INO-quantum/FPGA-SoC-experiment-control/documentation/readme.md

# documentation

## manual

This folder contains the user manual of the FPGA board. 

This contains additional information about the board and how to configure and program it.
