INO-quantum/FPGA-SoC-experiment-control/labscript-suite/readme.md

# labscript FPGA-SoC device

Python code to implement FPGA-SoC board with labscript-suite

## The FPGA-SoC board

The FPGA-SoC (system-on-a-chip) board is used as a low-cost experimental control hardware for controlling cold and ultracold atoms experiments. It is designed to work together with existing hardware placed in a 19" rack and replaces the outdated DIO64 board from Viewpoint Systems. In each sub-rack several plug-in modules can be inserted, like digital or analog outputs which are programmed via a ribbon "bus" cable on the backplane of the sub-rack. A custom [buffer card](/FPGA-buffer-card) was designed to buffer and level-shift the signal from the FPGA-SoC board voltage lever (3.3V) to that of the rack (5V). It additionally hosts clock input and output buffers for an external clock reference and buffers for external I/O which allows to synchronize several boards and as start/stop trigger. The FPGA-SoC board is connected with Arduino style headers to the buffer card and they are together inserted into one slot of the sub-rack and drive the backplane bus. The idea was that the new buffer card replaces the old opto-coupler card which is now not needed anymore. The FPGA-SoC board is the commercial low-cost board Cora-Z7 from Digilent. It has a FPGA-SoC chip from Xilinx (Zynq-7007S) consisting of a FPGA part and a CPU. The board hosts Gigabit Ethernet, USB (device and host) ports and plenty of external pins in an extended Arduino style layout. On the CPU part a simple embedded Linux operating system (Petalinux 2020 with linux kernel 5.4) is running which faciliates proptyping and tests where one can execute custom application generated for example with C/C++ or Python. The second section of the chip is the FPGA (field-programmable gate array) part which contains the custom hardware design (programmed in Verilog) which generates the signals which communicate with the hardware devices in the sub-rack via the backplane bus. 

Each FPGA-SoC board can drive up to two sub-racks when they are not too far apart (few meter). For larger separations two FPGA-SoC boards are recommended.

The channels (plug-in modules into sub-racks) are distinguished with a 7-bit address which must be unique for each sub-rack. The device-dependent data word is 16-bits long which allows to address 16 digital channels or to set the voltage of one 16-bit DAC. The FPGA-SoC puts the address and data word on the bus at the programmed time and after about 300ns (for 1MHz bus update rate; this can be configured) another bit on the bus (called 'strobe') goes high and after about 300ns goes low. The rising edge of the strobe triggers the addressed channel to update its output according to the programmed data word. The delay (usually referred as "setup time") ensures that all data and address bits are settled. Since the strobe signal acts like a clock but is changing state only when needed (different to a real clock), it is called 'pseudoclock' by labscript.

## Implementation as a labscript-suite device

The present software implements the FPGA-SoC board as a labscript device. Labscript-suite (https://docs.labscriptsuite.org/) is a free software package written in Python which allows to control ion, cold- or ultracold atoms experiments. It consists of 'runmanager' which generates the experimental sequence data, 'runviewer' which allows to visualize the data like oscilloscope traces and 'BLACS' which interacts with the hardware. The additional program 'Lyse' allows to gather data (like images) and analyze it. The experimental sequence, i.e. the list of actions as a function of time, is saved as Python script file [see example FPGA_test.py](/labscript-suite/userlib/labscriptlib/FPGA_test/FPGA_test.py) which the user edits. A separate file [connection_table.py](/labscript-suite/userlib/labscriptlib/FPGA_test/connection_table.py) is used to declare the hardware and needs to be imported into each experiment script.

The FPGA-SoC board is implemented in [FPGA_device.py](/labscript-suite/userlib/user_devices/FPGA_device.py) as a "pseudoclock device" (FPGA_board). The plugin-modules (having several channels) are implemented as "intermediate device" (DigitalChannels and AnalogChannels) and the individual channels are standard labscript digital and analog outputs (DigitalOut and AnalogOut).

Each FPGA board can drive up to 2 sub-racks where the second sub-rack shares the same address and data space but individual pseudoclock ('strobe') signals are generated such that only one or the other or both sub-racks are addressed. The timing of the two pseudoclocks can be adjusted individually allowing also to compensate for run-time delays on the different cable lengths.

Several FPGA boards can be declared in the connection table. One of the board must be defined as the primary board (in labscript termed as "master pseudoclock") for which the "trigger_device" entry must be None and for all other boards, called secondary boards, "trigger_device" is set to the name of the primary board. In order to synchronize the boards in time the primary board provides its internal clock on the "clock out" port which needs to be connected with a coaxial cable (and maybe splitter) to the "clock in" of the secondary boards. Alternatively, a shared external clock can be be used instead for all boards. Additionally, the primary board provides a "trigger" (also called "sync out") signal at the start of the experiment which needs to be input to the secondary boards. All output and input signals can be configured by software, either in the connection table, the experimental script or in the BLACS GUI. For examples see [connection_table.py and FPGA_test.py files](/labscript-suite/userlib/labscriptlib/FPGA_test/).

## Steps to get started

1. install labscript-suite on your computer as described here: https://docs.labscriptsuite.org/en/stable/installation/
2. you have to edit the file /labscript-suite/labconfig/\<your computer name\>.ini: give for "apparatus_name" the name of your experiment. This defines in which folder in /labscript-suite/userlib/labscriptlib/ your connection table and experiment script are located. I usually set save_hg_info = False since I have not hg (Mercurial) installed.
3. copy into the folder /labscript-suite/userlib/user_devices: FPGA_device.py, register_classes.py and generic_conversion.py
4. copy into the folder /labscript-suite/userlib/labscriptlib/\<apparatus name\>: conncetion_table.py and FPGA_test.py
5. edit 'FPGA_test.py' and connection_table.py for your actual experimental setup. For example you want to give proper names to each of the channels.
6. to start runmanager and blacs on Windows you will most likely find some desctop shortcuts, on linux it depends how you installed: most likely you launch them from the terminal after activation of a virtual environment. I use instead Pycharm-community.
7. after you started BLACS it will ask you to compile the connection table. Just press the compile button and after the small window appeared and it hopefully successfully compiled click on restart BLACS. BLACS restarts but unfortunately, it will always give error messages ("Broken Pipe" on Ubuntu, something else on Windows) and you have to manually close all of the popup error windows and BLACS and restart it. After manual restart the errors are gone. I have not understood where these errors are coming from but I assume its a bug in labscript. 
8. now yo can lanuch runmanager (sometimes you have to restart it after BLACS recompile and restart error) and click on "Engage" to compile your experiment script. When you have enabled "Run shot(s)" the sucessful created hd5-file with the data is inserted into the "Filepath" table of experiments in BLACS.
9. in BLACS click on the "Pause" button when it is gray and the experiment should be executed. When you enable the "Repeat" button then all files in the table are executed in a loop until you push the "Repeat" button again. To get an idea of the execution of the boards click on the black square in the top-right corner of the board tab. This opens the terminal showing messages from the blacs worker talking with the board (and maybe with the other boards). This is helpful if something goes wrong. The Digital and Analog outputs buttons open the sections where you can set outputs manually. In the "FPGA board" section you can see the current setup of the board and you can temporarily do changes after you enabled "allow changes (caution!)" - this is for testing. The "get state" button prints the actual board state in the terminal window. The disconnect button disconnects the board. The "abort!" button I think does not do anything at the moment.

## notes regarding the 'pseudoclock' and other details

The concept of the 'pseudoclock' has caused some confusion. As stated above, it is a phycical (digital) signal which acts like a clock but changes state only when needed, i.e. only when some device on the sub-rack has to read data from the bus and change state. This has two advantages: 1. for each channel only the state changes need to be memorized and uploaded without corresponding timing information, and 2. channels provided with independent pseudoclocks can run independently.

Most labscript devices are either a pseudoclock device (like the Pulseblaster) or a so-called intermediate device (like the National Instruments cards) which uses an external pseudoclock device for timing. A pseudoclock device needs to process only timing data, while the intermediate device needs to process only channel data. A physical pseudoclock device can provide several pseudoclocks to clock devices at different rates. Some of them have also a limited number of digital channels (called "direct outputs") for arbitrary use. 

The present implementation features both aspects, where the "FPGA_board" is the pseudoclock device handling the timing, and the two intermediate devices ("DigitalChannels" and "AnalogChannels") are handling the channel data. However, time and channel data is **not separated** here and is uploaded on each FPGA board within a single data structure. This is the data expected by the Viewpoint Systems DIO card which the present FPGA board is intended to replace.

The uploaded data consists of 32bit time information (in units of 1/bus_rate which is typically one microsecond) plus 32bit data where 7bits is the channel address and 16bits is the channel data. For the 2 sub-racks version a second 32-bit data with the same structure is added. From the remaining 9 bits in the data the bit (BIT_STRB) next to the address bits was historically toggled for each sample which created in the old opto-coupler card the delayed 'strobe' pulse. This was a cheap way to generate a 300ns delayed pulse without the need of a separate clock signal. Additionally, it allowed to skip one sample without changing the buffer size by not toggling this bit (but the bit needed to be toggled in all following data samples). The present FPGA board ignors BIT_STRB (although generated by runmanager) since it can generate the strobe independently with a much better resolution (and much less jitter) than the old opto-coupler card. However, if needed, BIT_STRB can be enabled to skip samples when this bit does not toggle. This way it might be easier to migrate from old software in case it uses this feature. Ask me or check with an oscilloscope that this feature works, since it might need to be enabled also in the firmware (note that with the old DIO card, because of the BIT_STRB, it might skip the first sample when the last executed sequence has an odd number of samples). Another - more useful bit - is bit 31 (BIT_NOP) of the data. If BIT_NOP is set (1) then the sample is ignored by the FPGA board but the timing is not affected. This allows, as BIT_STRB to skip data but only one sample needs to be changed in memory. This bit cannot be disabled since it is also used by the driver (on the FPGA board) to add additional samples to have always a multiple of 4 samples in the data (this comes from the 8 or 12bytes per sample and allows to have a fixed internal bus size on the FPGA logic of 16bytes since 4x8=2x16 and 4x12=3x16 give integer multiple of 16). Last special bit which can be enabled is bit 30 (BIT_IRQ) which when set causes the FPGA board to generate an internal IRQ which triggers to update the number of sample and execution time registers and sends an updated time information to the control software. This is useful to software trigger some external devices, for example a device using USB or GPIB, and avoids that the software has to poll for a certain execution time to send commands to the device. Tests showed that the jitter caused when using this feature is significantly reduced. Please ask me for details how to do this when needed.
