INO-quantum/FPGA-SoC-experiment-control/firmware-source/2017.4/Vivado/Screenshot from 2021-05-19 11-35-13.png

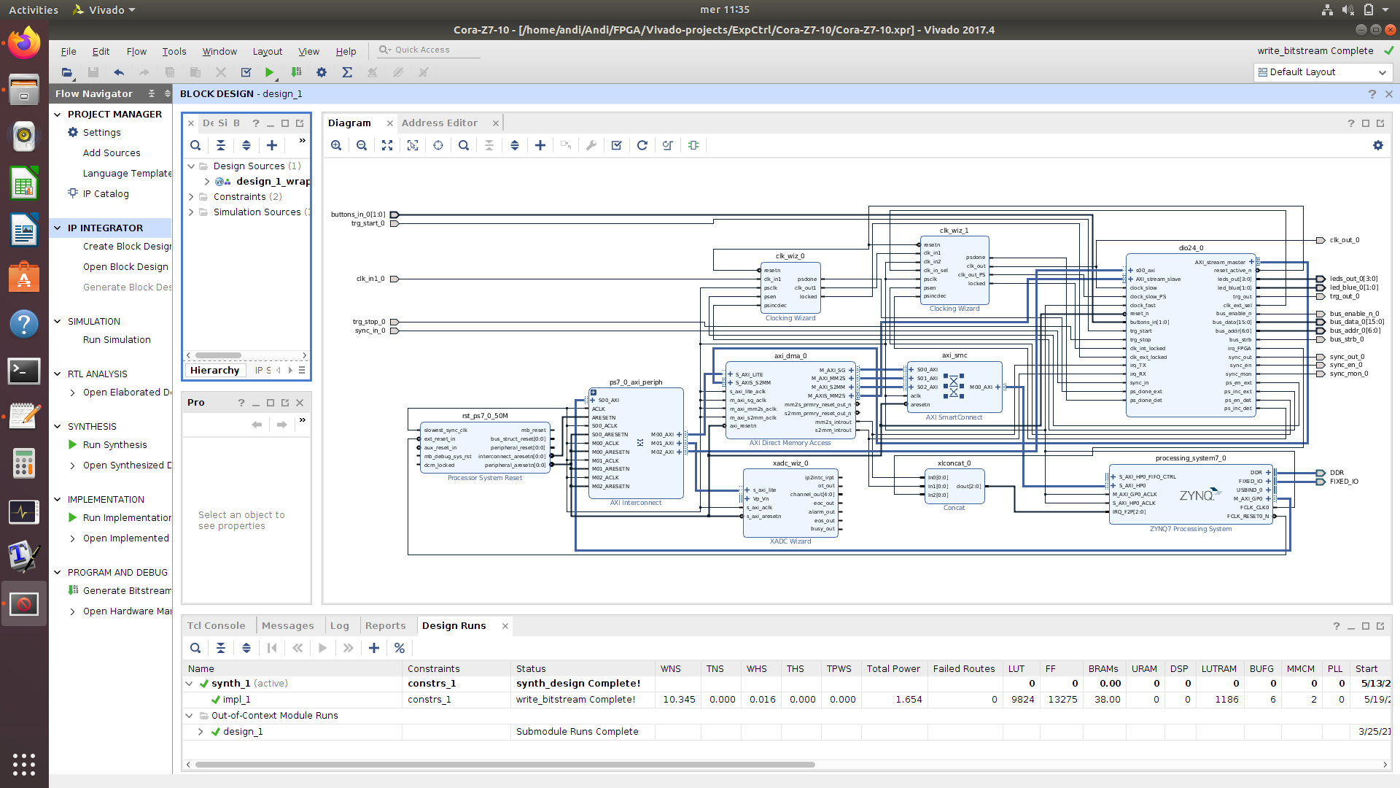
firmware-source/2017.4/Vivado/Screenshot from 2021-05-19 11-35-13.png
