INO-quantum/FPGA-SoC-experiment-control/buffer-card/v1.4/production/FPGA_buffer_board_v1.4_shopping_list.xls

FPGA and buffer board v1.4, 2024/01/16 by Andi
list contains items needed for 1 FPGA board + 1 buffer board
not all items are/were available on RS. I found the rest at mouser
*these items depend on the chosen configuration. you can leave them open and insert later manually when needed.
price is without VAT
position | qty/board | Value | description | RS/mouser code | price/item | items/pgk | pkg to buy | RS list | price/RS | price/total | note
C1 | 1 | 100uF | Condensatore Panasonic, serie HD RADIAL, 100μF, 16V cc, ±20%, +105°C, Radiale, Foro passante | 744-1990 | 0.118 | 10 | 1 | ok | 1.18 | 1.18
C2 | 1 | 10uF Tantalum | AVX TAJ 10μF ±20%, 16V cc, +125°C, package 1206 (3216M) | 136-0190 | 0.222 | 50 | 1 | ok | 11.1 | 11.1
C3 - C13, C16, C17 | 13 | 100nF | Condensatore ceramico multistrato MLCC, 0603 (1608M), 100nF, 50V cc, SMD | 135-8352 | 0.08 | 50 | 1 | ok | 4 | 4
C14, C15 | 2* | 10nF/short* | Condensatore ceramico multistrato MLCC, 0603 (1608M), 10nF, ±10%, 50V cc, SMD, X7R | 242-3912 | 0.01 | 100 | 0 | * | 0 | 0 | *10nF/short for ext.clock 10MHz since/LVPECL
D1 | 1 |  | Indicatore LED per PCB Rosso Dialight, 45 °, 1 LEDs, Right-angle, 2 V, Montaggio con foro passante | 546-0463 | 1.1 | 1 | 1 | ok | 1.1 | 1.1
D2, D3 | 2 |  | Indicatore LED per PCB Verde Dialight, 45°, 1 LEDs, Right-angle, Montaggio con foro passante | 917-0767 | 0.785 | 20 | 1 | ok | 15.7 | 15.7
J1 | 1 | Cora supply jack 2.1mm | Morsettiera per circuito stampato RS PRO Maschio a 2 vie, 1 fila, passo 5mm, Montaggio su foro passante | 897-0843 | 0.537 | 10 | 1 | ok | 5.37 | 5.37
J2 | 1 | +/-15V, 5V from rack | Connettore circuito stampato Molex Filo-Scheda, 5 vie, 1 fila, passo 3.96mm | 679-5697 | 0.462 | 10 | 1 | ok | 4.62 | 4.62 | maybe by mistake of RS we recieved a shorter version last time. this should be Molex type 41791, mat. nr. 26-60-4050 with total pin length 18.29mm (mating length 11.43mm)
J3, J5, J6 | 2 | 1x8 (1x 1x2, 1x 1x8, 1x 1x4) | HMTSW-108-22-G-S-400, Board to Board & Mezzanine Connectors .100" High-Temp Variable Post Height Terminal Strip | 200-HMTSW10822GS400 | 1.47 | 1 | 2 |  |  | 2.94 | mouser
J4, J8 | 2 | IO0-41 (2x 2x8) | HMTSW-108-22-S-D-400, Board to Board & Mezzanine Connectors .100" High-Temp Variable Post Height Terminal Strip | 200-HMTSW10822SD400 | 3.35 | 1 | 2 |  |  | 6.7 | mouser
J7 | 1* | SPI* (2x3) | Presa PCB Samtec, 6 vie, 2 file, passo 2.54mm, Foro passante | 155-7781 | 1.96 | 10 | 0 | * | 0 | 0 | *open
J9 | 1 | A0-A11 (2x6) | HMTSW-106-22-L-D-400, Board to Board & Mezzanine Connectors .100" High-Temp Variable Post Height Terminal Strip | 200-HMTSW10622LD400 | 1.82 | 1 | 1 |  |  | 1.82 | mouser
J10, J11 | 2 | Cora PMOD JA/B (2x6) | Presa PCB Samtec, 12 vie, 2 file, passo 2.54mm, Montaggio superficiale | 198-1520 | 4.19 | 1 | 2 | ok | 8.38 | 8.38
J12 | 1* | I2C* (1x3) | Connettore maschio Samtec, 3 vie, 1 fila, passo 2.54mm | 180-3419 | 0.263 | 50 | 0 | * | 0 | 0 | *open
J13, J21 | 2 | daugther I/O, bus out (2x25) | TSM-125-01-L-DV, Headers & Wire Housings .100" Surface Mount Terminal Strip | 200-TSM12501LDV | 6.87 | 1 | 2 |  |  | 13.74 | mouser
J14 | 1 | rack backplane connector (2x32) | Connettore DIN 41612 Harting 09031647921 64 vie Maschio, 2 file, passo 2.54mm, tipo C, classe C3 Foro passante, Saldare | 406-357 | 3.04 | 1 | 1 | ok | 3.04 | 3.04
J15, J18, J22, J23 | 4 | clock in/out, in/out_0 (SMA) | Connettore coassiale Diritto RS PRO, Femmina, 50Ω, Montaggio su bordo, 1.6mm spessore | 526-5785 | 3.73 | 1 | 4 | ok | 14.92 | 14.92 | alternative SMB: 526-5814
J16-17, J19-20, J24 | 5* | in_1/2, out_1/2, clock_LVDS_1/2* | Connettore coassiale Ad angolo retto RS PRO, Maschio, 50Ω, Circuito stampato | 253-7046 | 2.3 | 1 | 1 | ok | 2.3 | 2.3 | *optional, J24 recommended for clock (1 selected)
R1, R2, R3 | 3 | 510 | Resistenza SMD Vishay Film spesso, 510Ω, 0805 (2012M), ±1%, 0.125W, serie CRCW | 679-1519 | 0.06 | 50 | 1 | ok | 3 | 3
R4, R5, R6, R29 | 4 | 100 | Resistenza SMD Panasonic Film spesso, 100Ω, 0805 (2012M), ±1%, 0.125W, serie ERJ | 865-4191 | 0.053 | 100 | 1 | ok | 5.3 | 5.3
R7, R8, R9 | 0* | open* |  |  |  |  | 0 | * | 0 | 0 | *open
R10, R11, R12 | 3 | 2.2k | Resistenza SMD Yageo Film spesso, 2.2kΩ, 0805 (2012M), ±5%, 0.25 W, 0.125 W | 199-5764 | 0.01 | 100 | 1 | ok | 1 | 1
R13-R20 | 8* | 220* | Resistenza SMD Vishay Film spesso, 220Ω, 0805 (2012M), ±1%, 0.5W | 812-3482 | 0.012 | 25 | 0 | * | 0 | 0 | *open
R21-R28 | 8 | 220k | Resistore per montaggio superficiale a film spesso TE Connectivity 220kΩ ±1%, 0.125W, 0805, serie CRG | 223-0742 | 0.034 | 50 | 1 | ok | 1.7 | 1.7
R30, R31, R36-R39 | 6 | 0 | Resistenza SMD Vishay Film spesso, 0Ω, 1206 (3216M), ±0%, 0.5W, serie CRCW | 812-1773 | 0.158 | 25 | 1 | ok | 3.95 | 3.95
R32, R34 | 2* | open/120* | Resistenza SMD TE Connectivity Film spesso, 120Ω, 1206 (3216M), ±5%, 0.5W, 200V, serie CRGH | 807-1114 | 0.02 | 100 | 0 | * | 0 | 0 | *open/120 for ext.clock 10MHz sine/LVPECL
R33 | 1* | short/82* | Resistenza SMD TE Connectivity Film spesso, 82Ω, 1206 (3216M), ±5%, 0.5W, 200V, serie CRGH | 807-1306 | 0.012 | 100 | 0 | * | 0 | 0 | *short/82 for ext.clock 10MHz sine/LVPECL
R35 | 1* | 51/82* | Resistenza SMD Vishay Film spesso, 51Ω, 1206 (3216M), ±1%, 0.5W, serie CRCW | 812-1916 | 0.3 | 25 | 0 | * | 0 | 0 | *51/82 for ext.clock 10MHz sine/LVPECL
R40, R41 | 2 | 110 | Resistenza SMD TE Connectivity Film sottile, 110Ω, 0805 (2012M), ±0.1%, 0.1W | 666-2446 | 0.094 | 5 | 1 | ok | 0.47 | 0.47
U1-U4, U7-U10 | 8 | 74HCT541 | Driver e buffer di linea 74HCT541D,652, HCT, 3 stati, Non-invertente, SOIC, 20-Pin | 103-8183 | 0.633 | 38 | 0 | * | 0 | 0
 |  |  | 74HCT541D,653, Buffer e line driver OCTAL BUF/DRIVER 3-S | 771-74HCT541D-T | 0.586 | 1 | 8 |  |  | 4.688 | alternative on mouser
U5 | 1 | 74LVC06 | Invertitore HEX INV Open Drain 1.65V to 5.5V 24mA | 621-74LVC06AT14-13 | 0.353 | 1 | 1 | ok | 0.353 | 0.353
U6 | 1 | 74LVC3G17 | Buffer SN74LVC3G17DCTR, Triple canali, LVC, 1,65 → 5,5 V, SSOP, 8 Pin Sì | 662-9045 | 0.74 | 5 | 0 | * | 0 | 0 | package TSSOP-8 3x3mm is ok
 |  |  | 771-LVC3G17DP125, Buffer e line driver TRIP NO-INV SCH TRIG, TSSOP-8 | 771-LVC3G17DP125 | 0.567 | 1 | 1 |  |  | 0.567 | alternative on mouser
U11 | 1 | MC10EPT20 | Traslazione - Livelli di tensione 3.3V TTL/CMOS to Diff PECL, SOIC-8 | 863-MC10EPT20DG | 9.47 | 1 | 1 | ok | 9.47 | 9.47 | alternative 908-0951 (TSSOP, dual footprint)
U12 | 1 | LTC6957xDD-3 | Buffer di clock Low Phase Noise, Dual Output Buffer/Driver/Logic Converter with LVDS Outputs | LTC6957HMS-2#PBF | 10.2 | 1 | 1 |  |  | 10.2 | mouser, alternative: 584-LTC6957HMS-3#PBF or 584-LTC6957HMS-4#PBF
additional:
 | 1 |  | Kit di sviluppo 410-370 per ARM Development, FPGA Development | 184-0456 | 151.96 | 1 | 1 | ok | 151.96 | 151.96
 |  |  | Strumenti di sviluppo CI logici programmabili Cora Z7-07S Product Kit | 424-410-370 | 144.12 | 1 | 0 |  |  | 0
 | 1 |  | Micro SD Transcend Class 10, UHS-1 U1 MicroSDHC | 124-9639 | 13.99 | 1 | 1 | ok | 13.99 | 13.99 | use high-quality SD cards! 2 from Verbatim broke very fast!
 | 1 | 2x30, 90 degree, long pins, Cora PMOD JA clock interconnection | HMTSW-130-09-G-D-240-RA, Board to Board & Mezzanine Connectors .100" High-Temp Variable Post Height Terminal Strip | 200-HMTSW13009GD240R | 9.64 | 1 | 1 |  |  | 9.64 | found only on Mouser; this is for clock connection which could be made also just by cutting 0.7mm thick wire.
 | 1 |  | Cavo di alimentazione, L. 1.8m, Cavo spina da 2,5 mm Senza terminazione, 12 V, 1 A | 656-3894 | 7.42 | 1 | 1 | ok | 7.42 | 7.42
 | 4 |  | Connettore coassiale Angolo destro Telegartner, Maschio, 50Ω, Montaggio su cavo | 193-8990 | 4.68 | 1 | 4 | ok | 18.72 | 18.72 | SMA connector for external clock and trigger. maybe you need a coaxial cable for this as well?
sum | 80 |  |  |  |  |  |  |  | 289.043 | 339.338
