INO-quantum/FPGA-SoC-experiment-control/buffer-card/v1.4/production/FPGA_buffer_board_v1.4_FPGA_board_only_with_accessoires.xls

FPGA board v1.4, 2025/03/05 by Andi
list contains items needed for 1 FPGA board
price is without VAT
position | qty/board | Value | description | RS code | Mouser code | price/item | items/pgk | pkg to buy | RS list | price/RS | price/total | note
0 | 1 |  | Kit di sviluppo 410-370 per ARM Development, FPGA Development | 184-0456 | - | 151.96 | 1 | 1 | ok | 151.96 | 151.96
1 | 1 |  | Micro SD Transcend Class 10, UHS-1 U1 MicroSDHC | 124-9639 | - | 14.41 | 1 | 1 | ok | 14.41 | 14.41 | use high-quality SD cards! 2 from Verbatim broke very fast!
2 | 1 |  | Cavo di alimentazione, L. 1.8m, Cavo spina da 2,5 mm Senza terminazione, 12 V, 1 A | 656-3894 | - | 8.03 | 1 | 1 | ok | 8.03 | 8.03
