INO-quantum/FPGA-SoC-experiment-control/firmware-source/2020.1/labscript/labscriptlib/NI_DAQmx_test/c1f0nXgzot6vj0mP.png

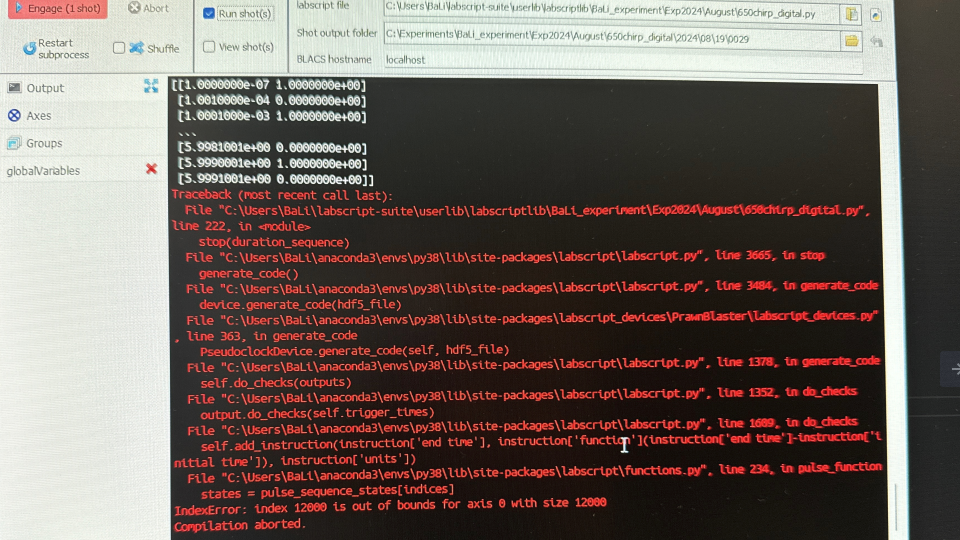
firmware-source/2020.1/labscript/labscriptlib/NI_DAQmx_test/c1f0nXgzot6vj0mP.png
