INO-quantum/FPGA-SoC-experiment-control/buffer-card/v1.4/FPGA_buffer_board_v1.4_schematics_color.pdf

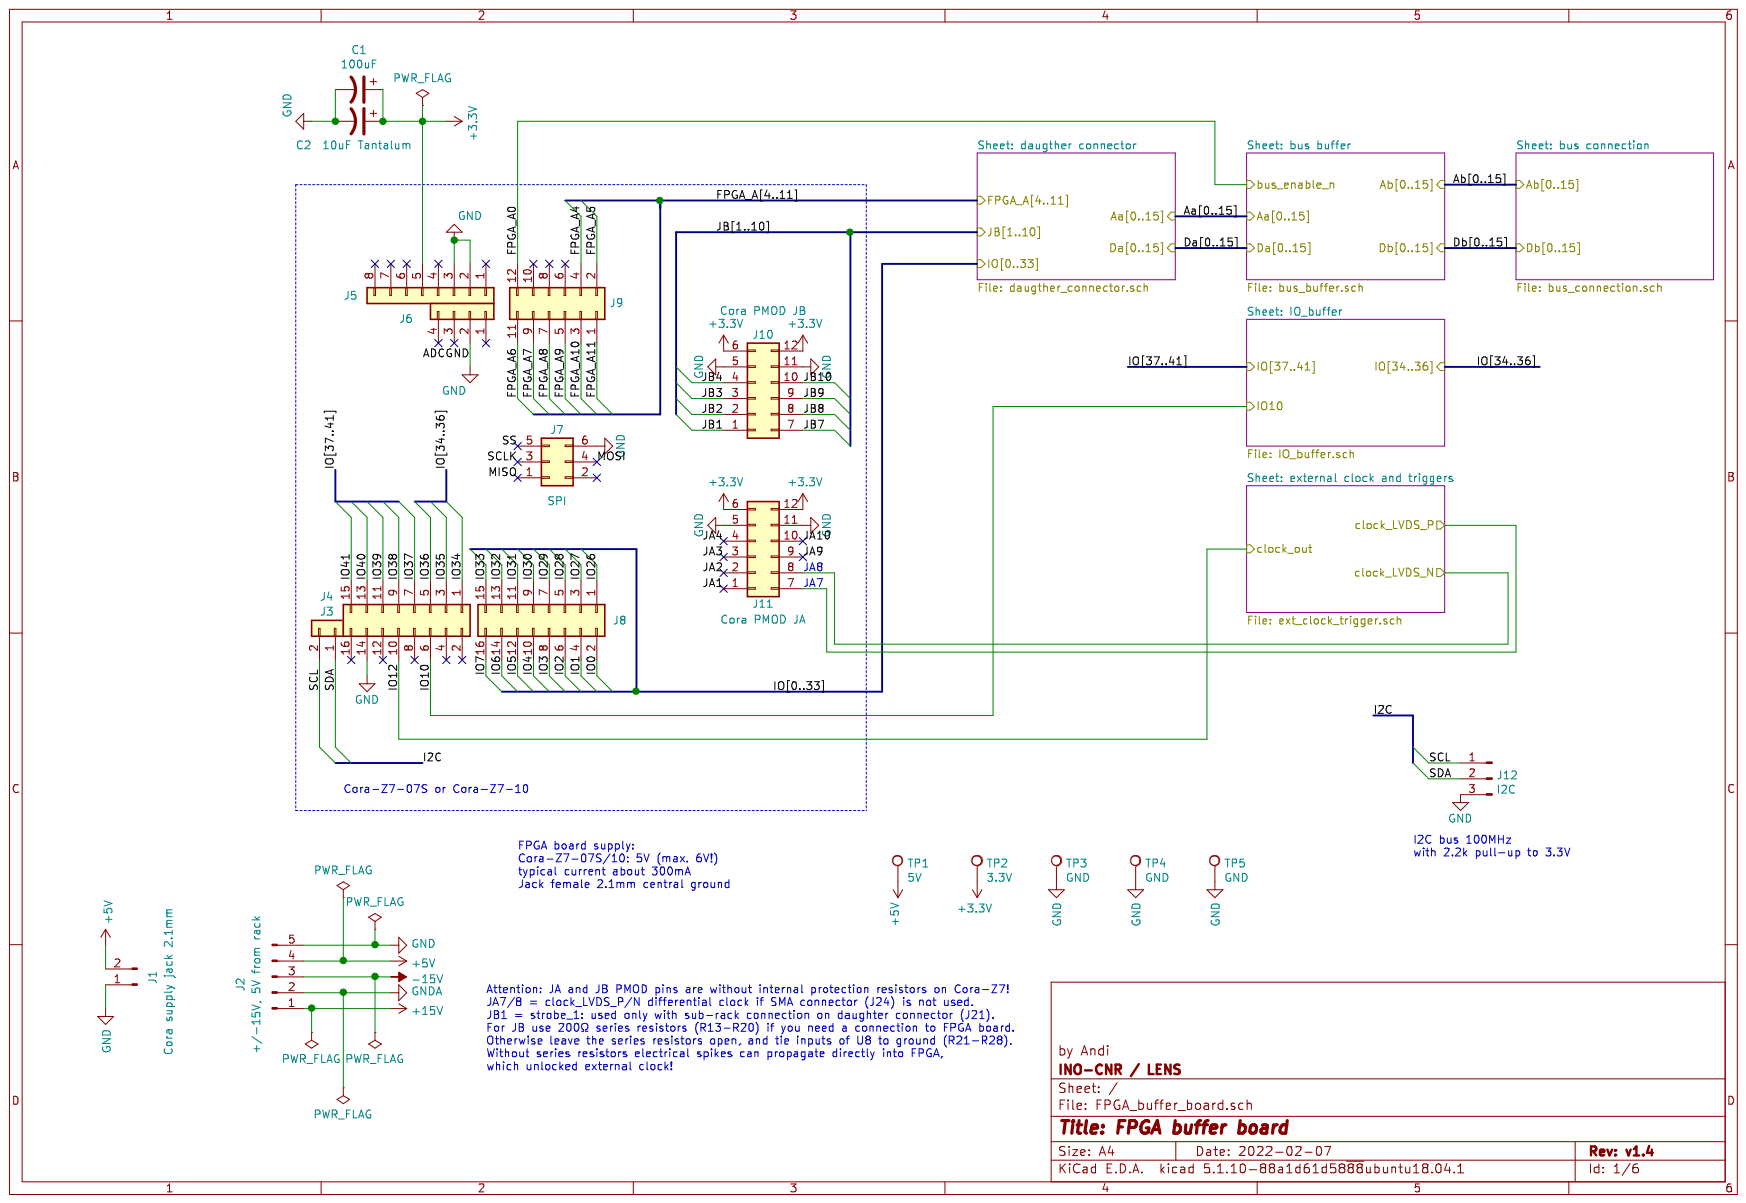
[picture p11: page 1]

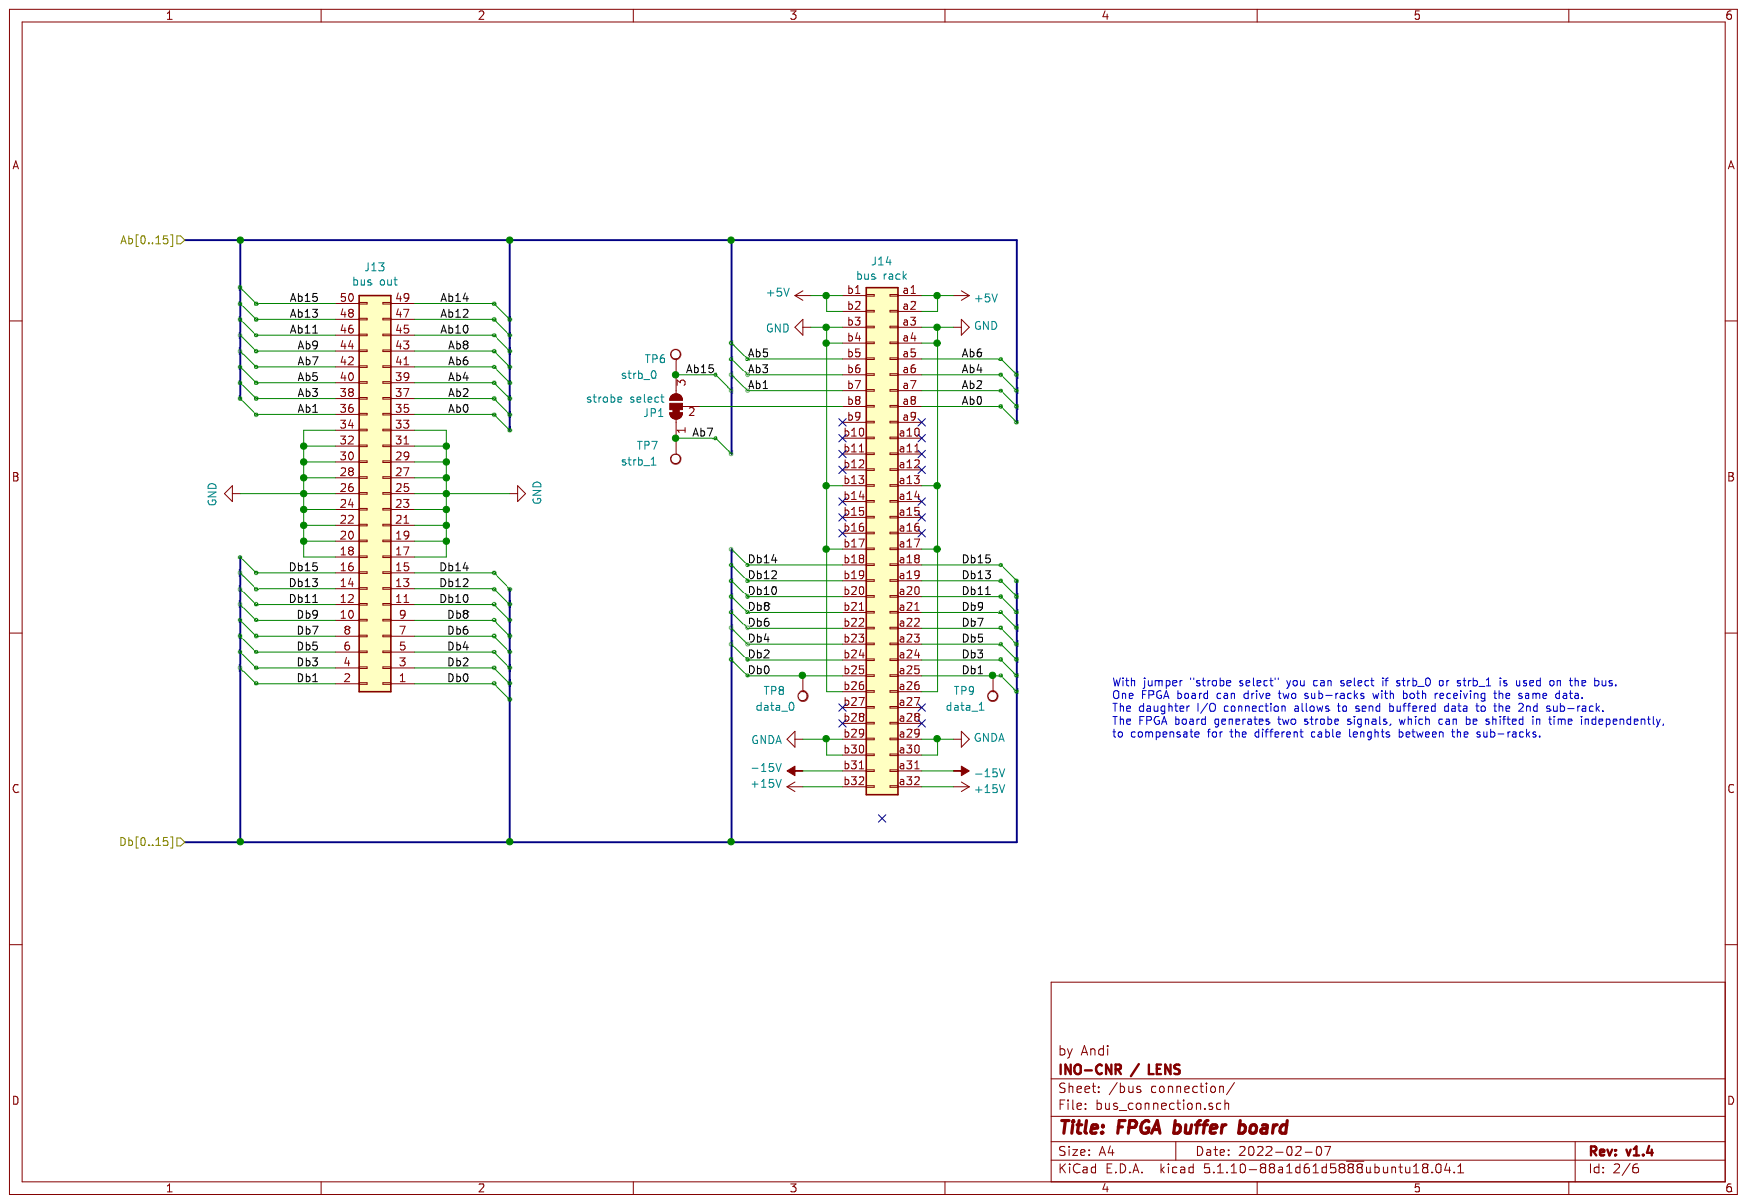
[picture p12: page 2]

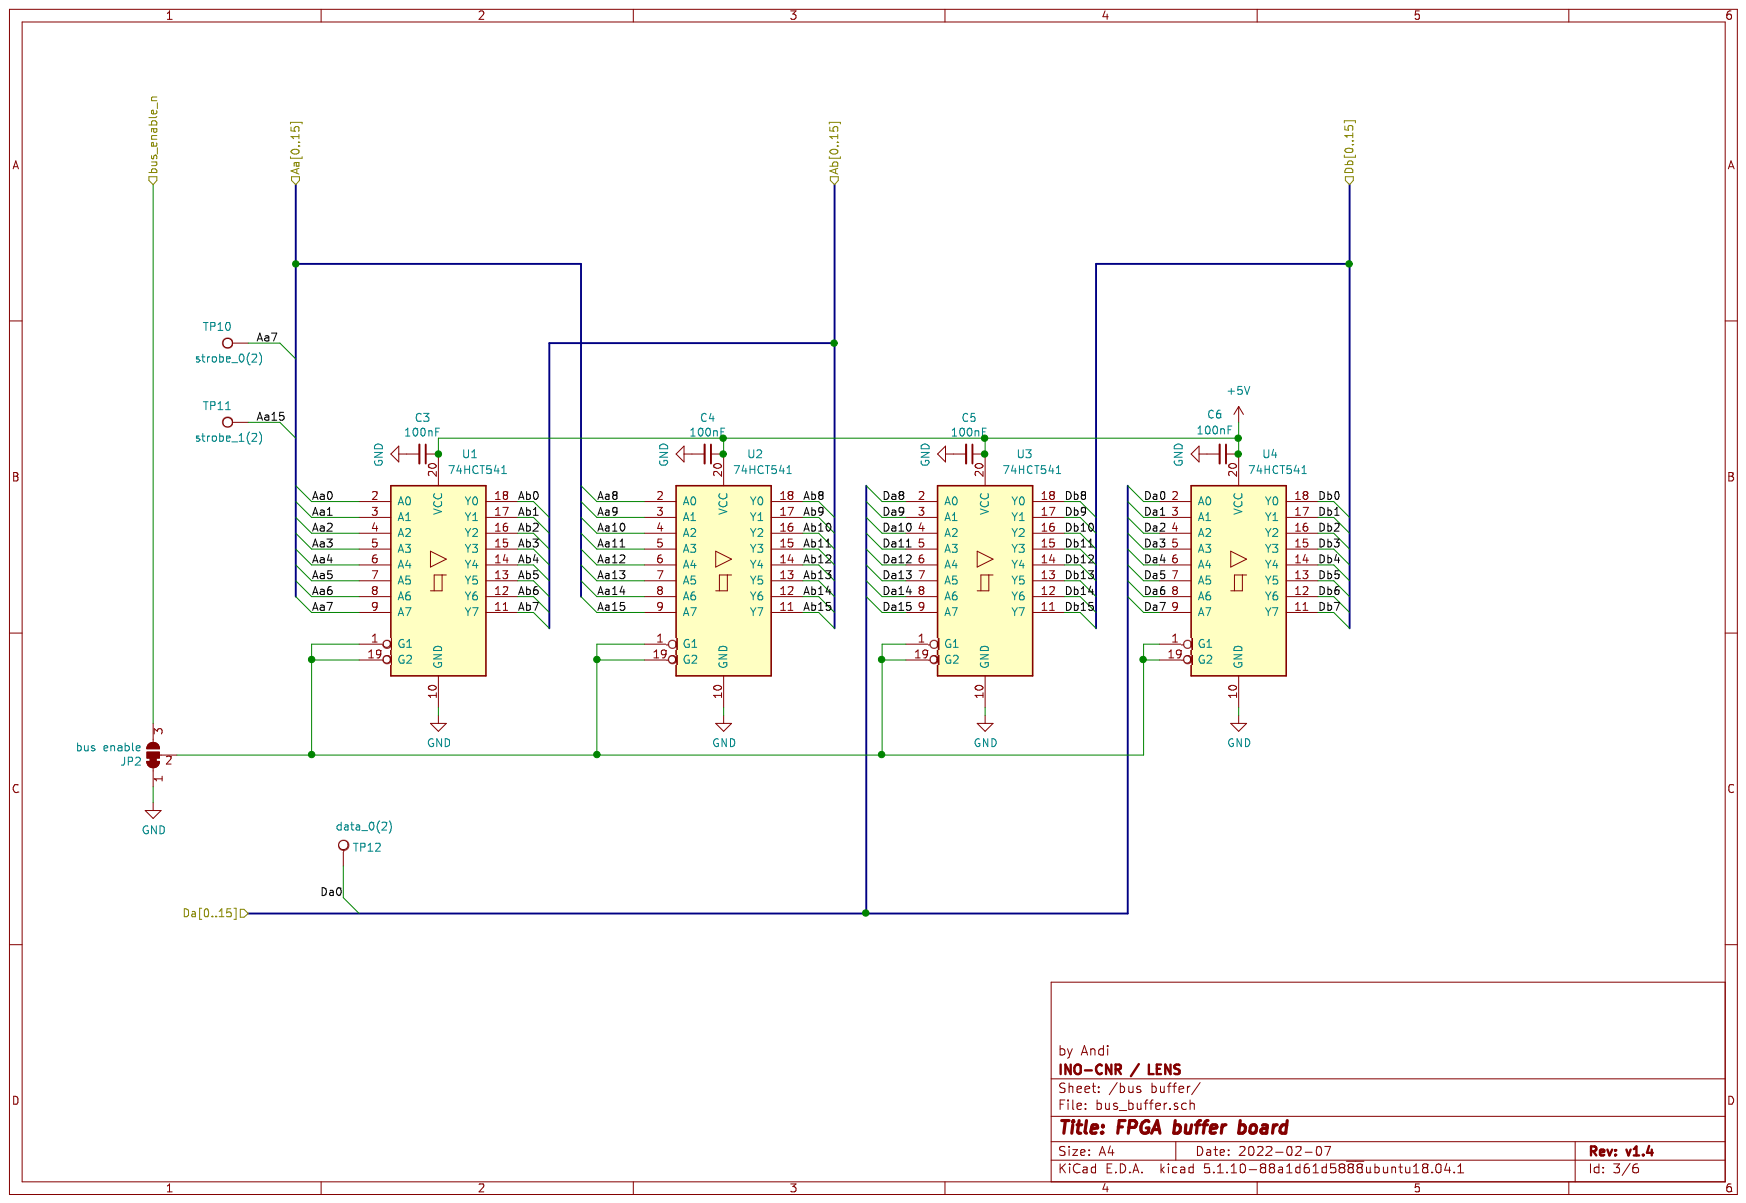
[picture p13: page 3]

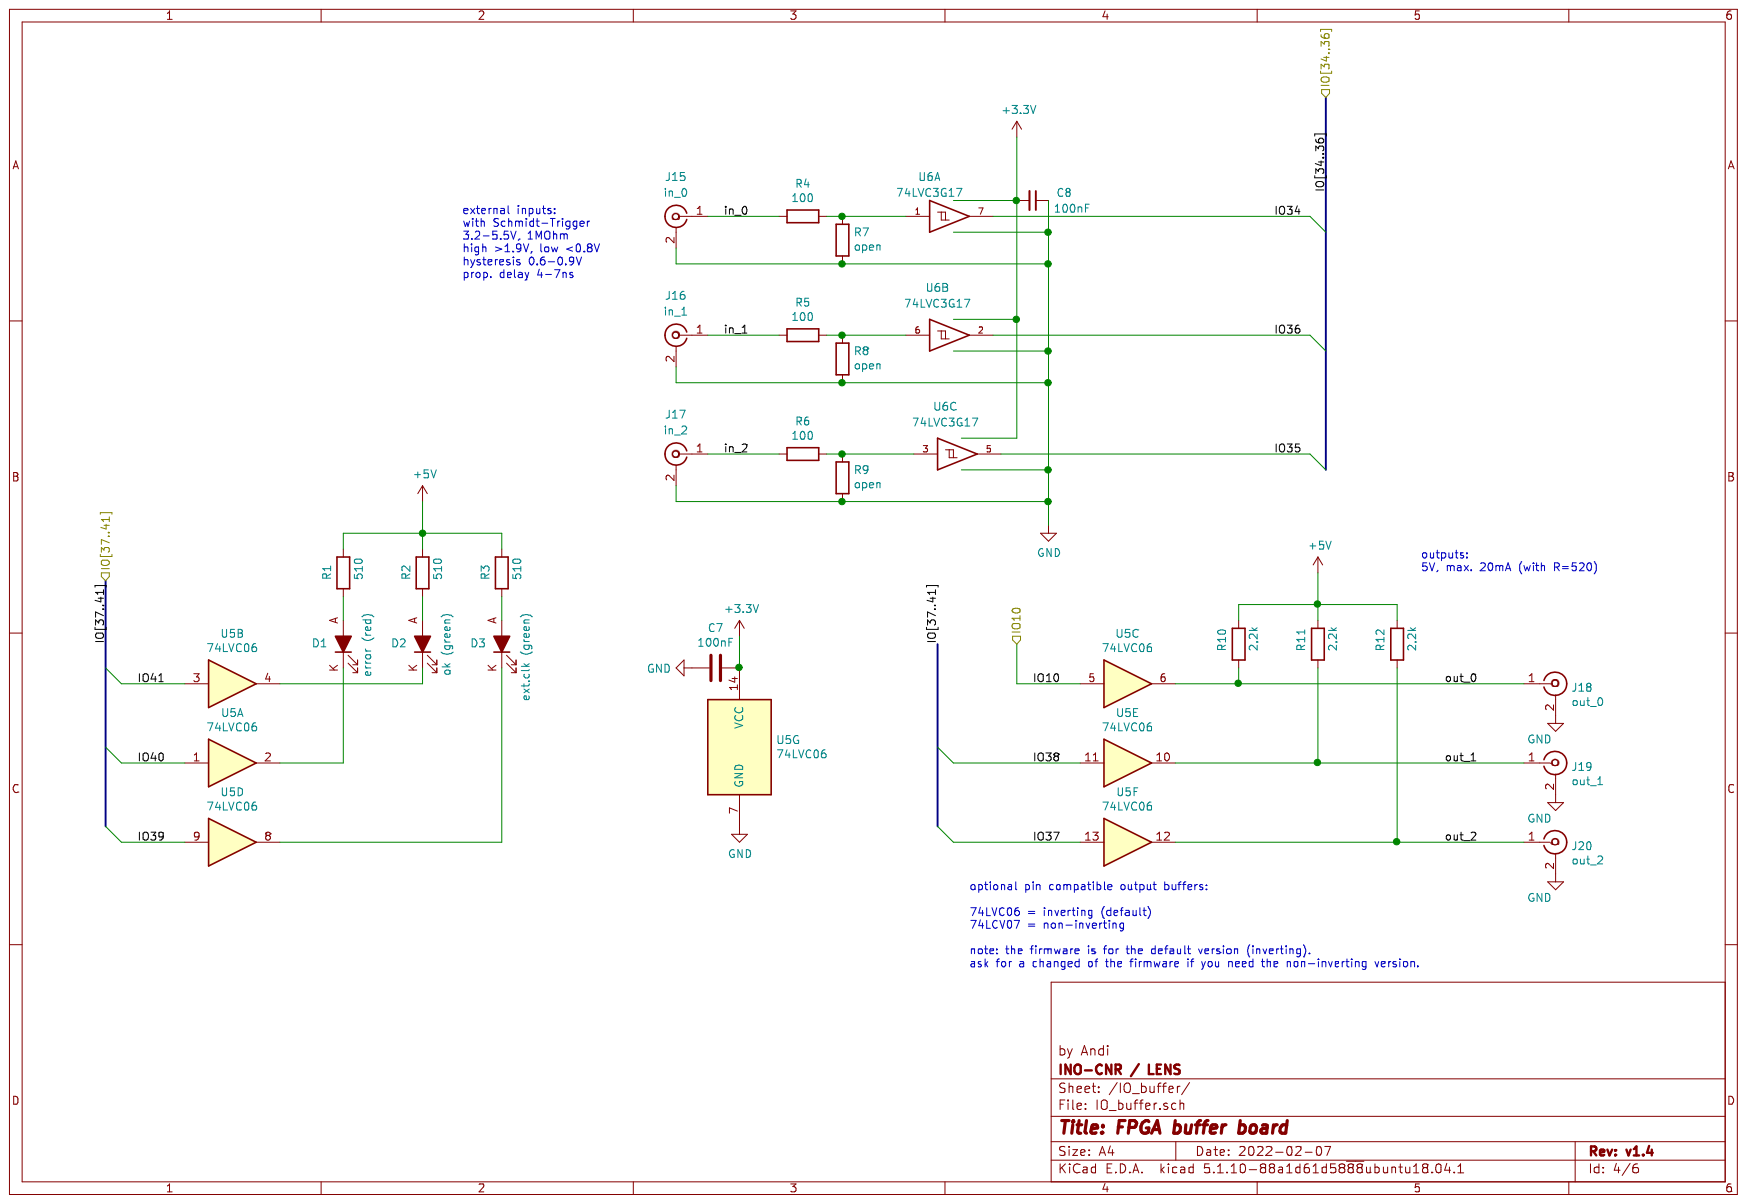
[picture p14: page 4]

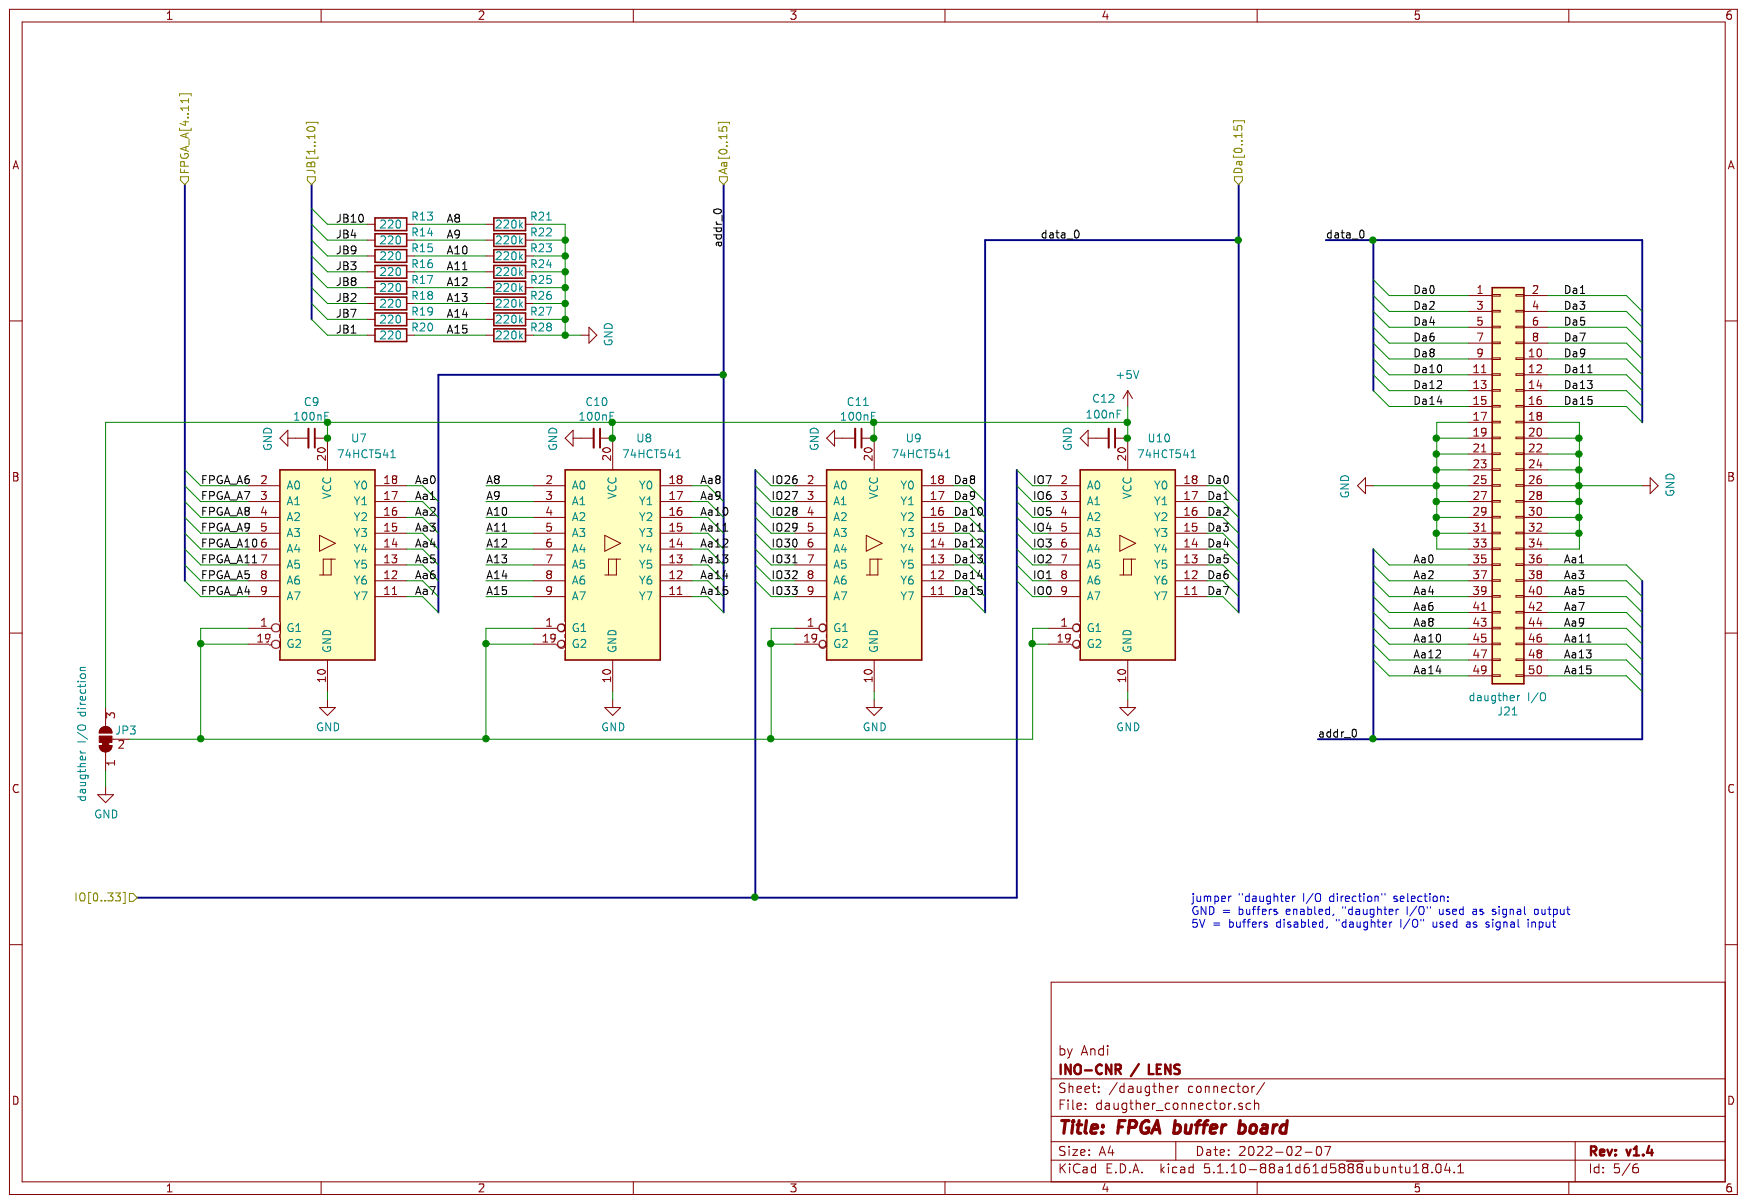
[picture p15: page 5]

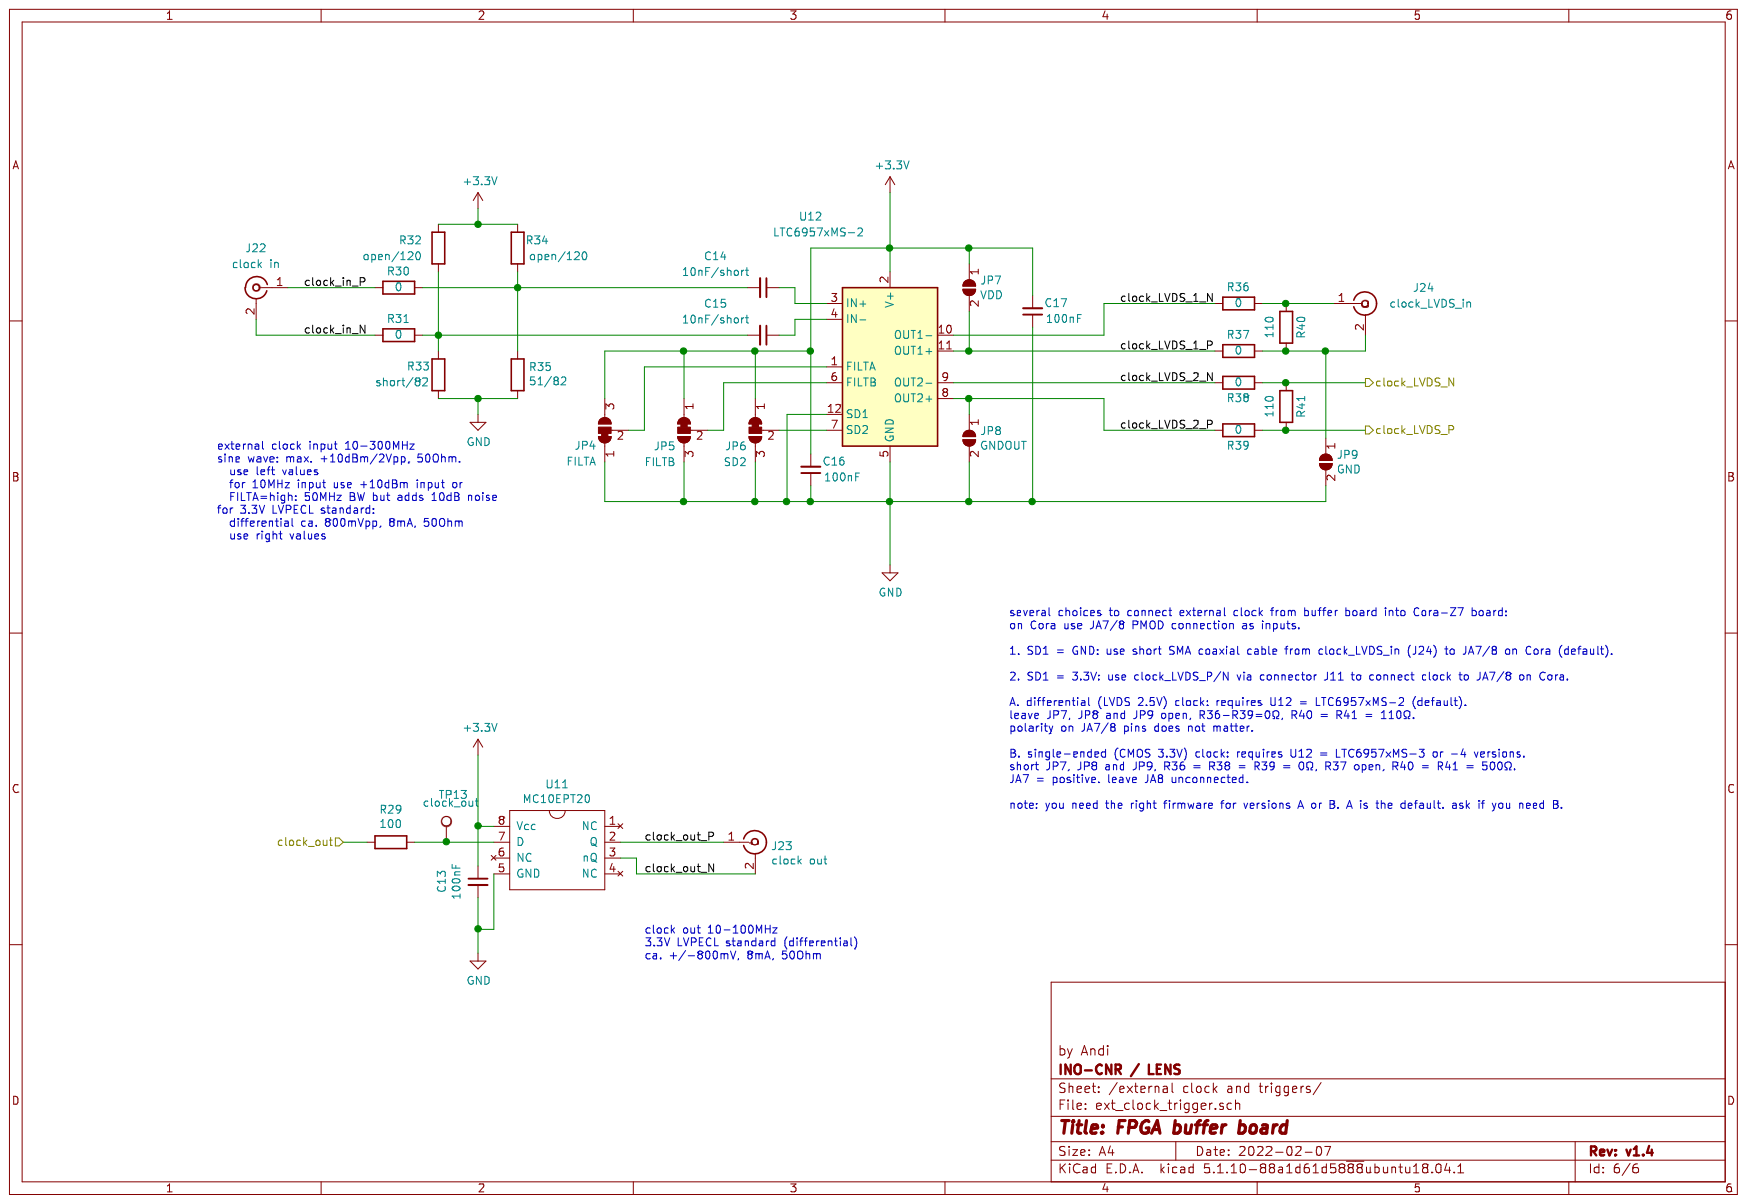
[picture p16: page 6]
