INO-quantum/FPGA-SoC-experiment-control/buffer-card/v1.4/production/FPGA_buffer_board_v1.4_PCB_back.pdf

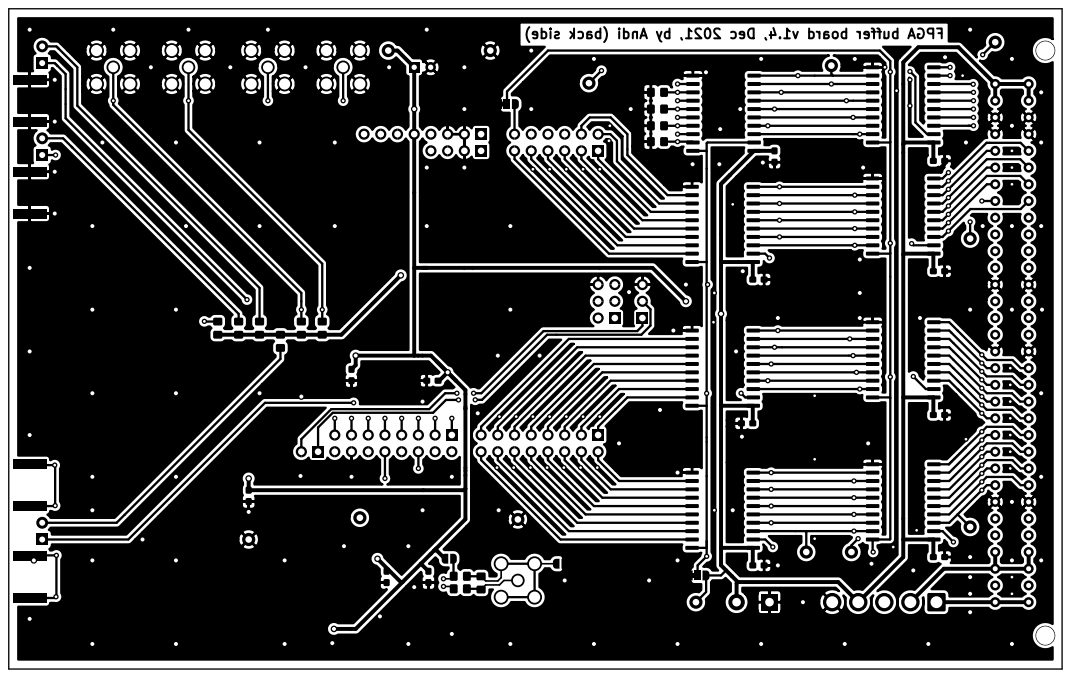
[picture p17: page 1]
