INO-quantum/FPGA-SoC-experiment-control/buffer-card/v1.4/production/FPGA_buffer_board_v1.4_PCB_front.pdf

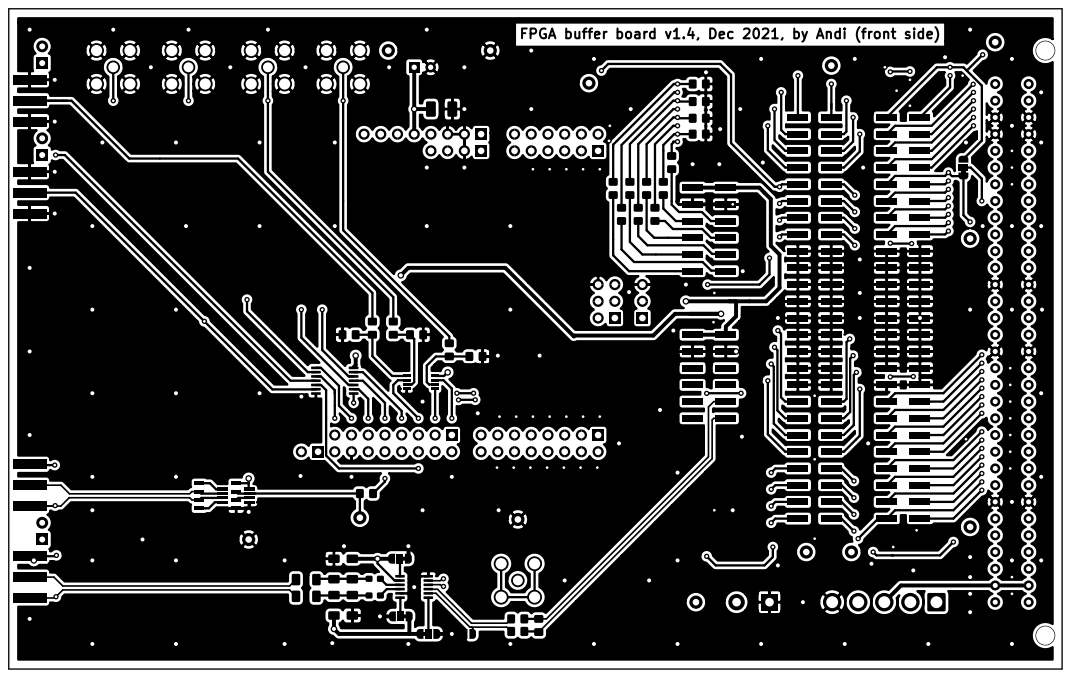
[picture p18: page 1]
