INO-quantum/FPGA-SoC-experiment-control/paper/schematics/FPGA_cable_driver.pdf

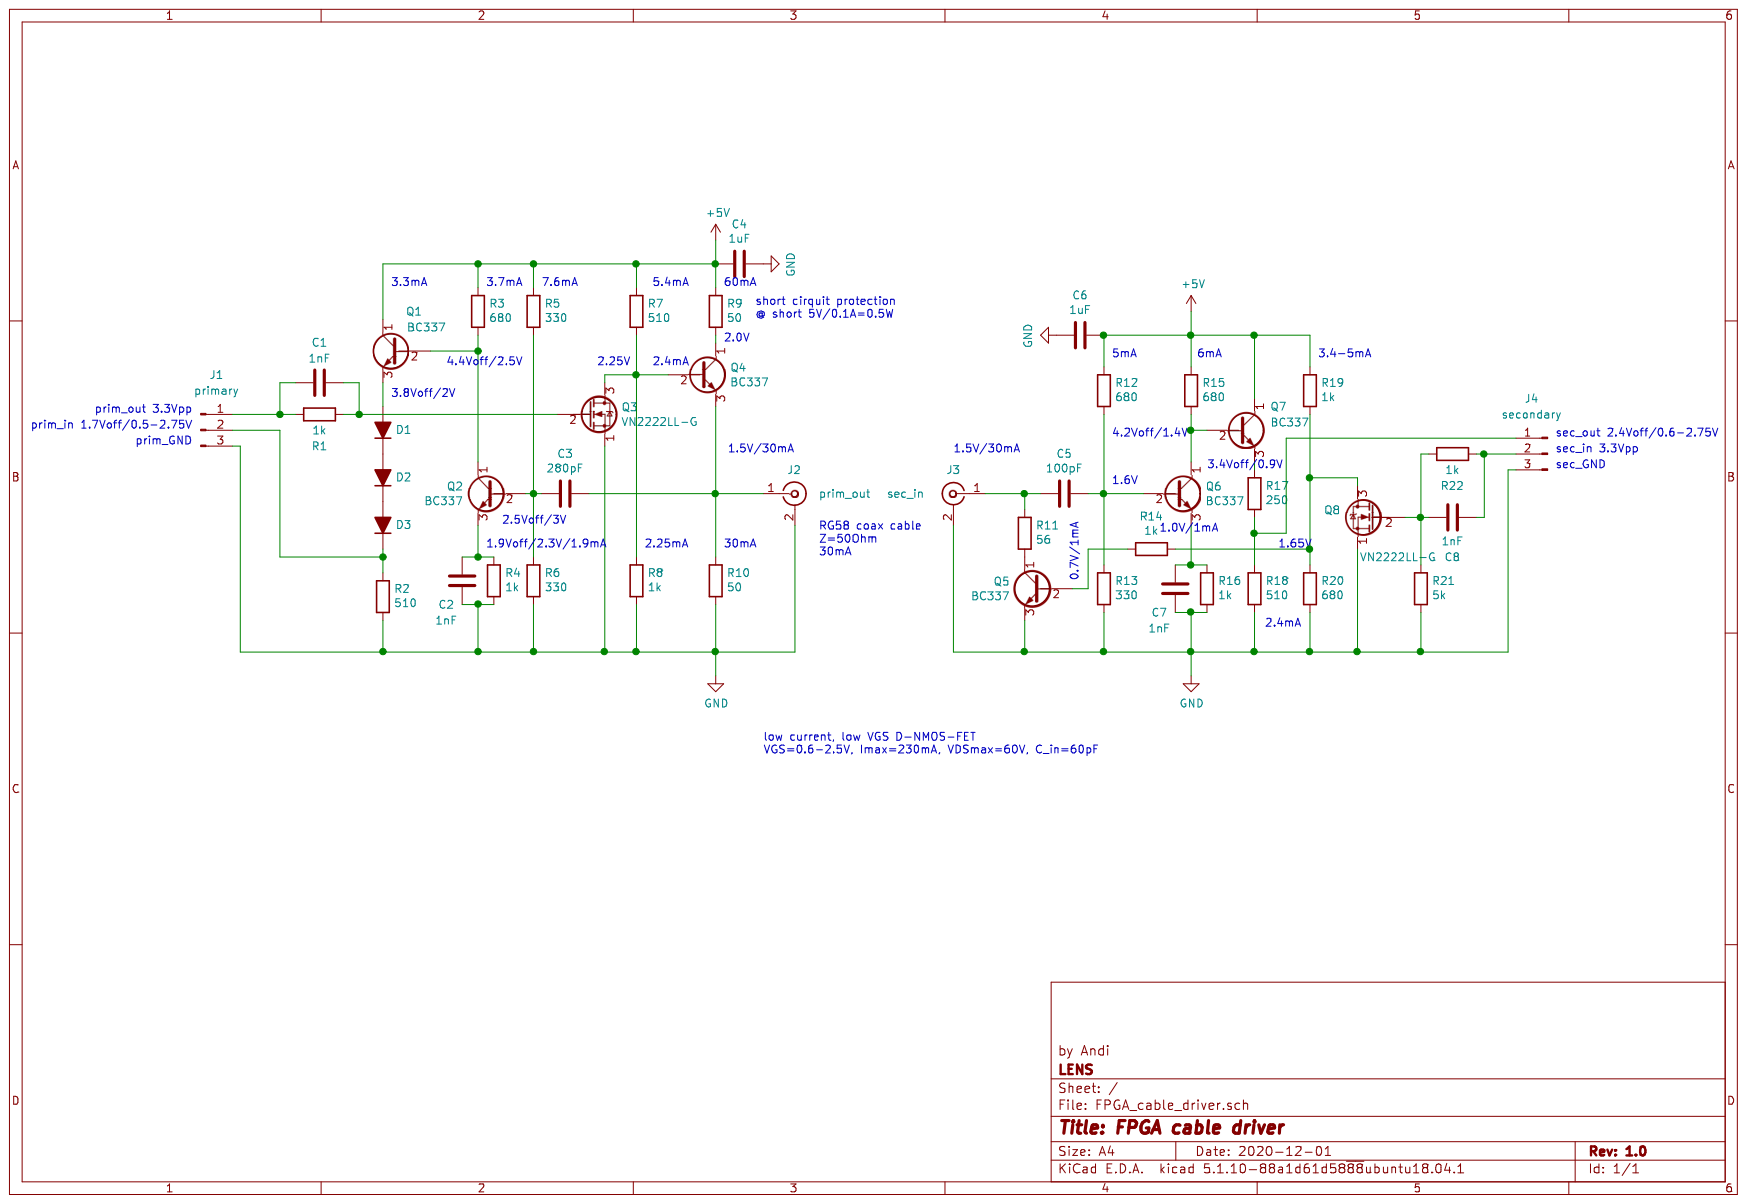
[picture p21: page 1]
