INO-quantum/FPGA-SoC-experiment-control/buffer-card/v1.3/v1.3.1/FPGA_buffer_board_v1.3_schematics.pdf

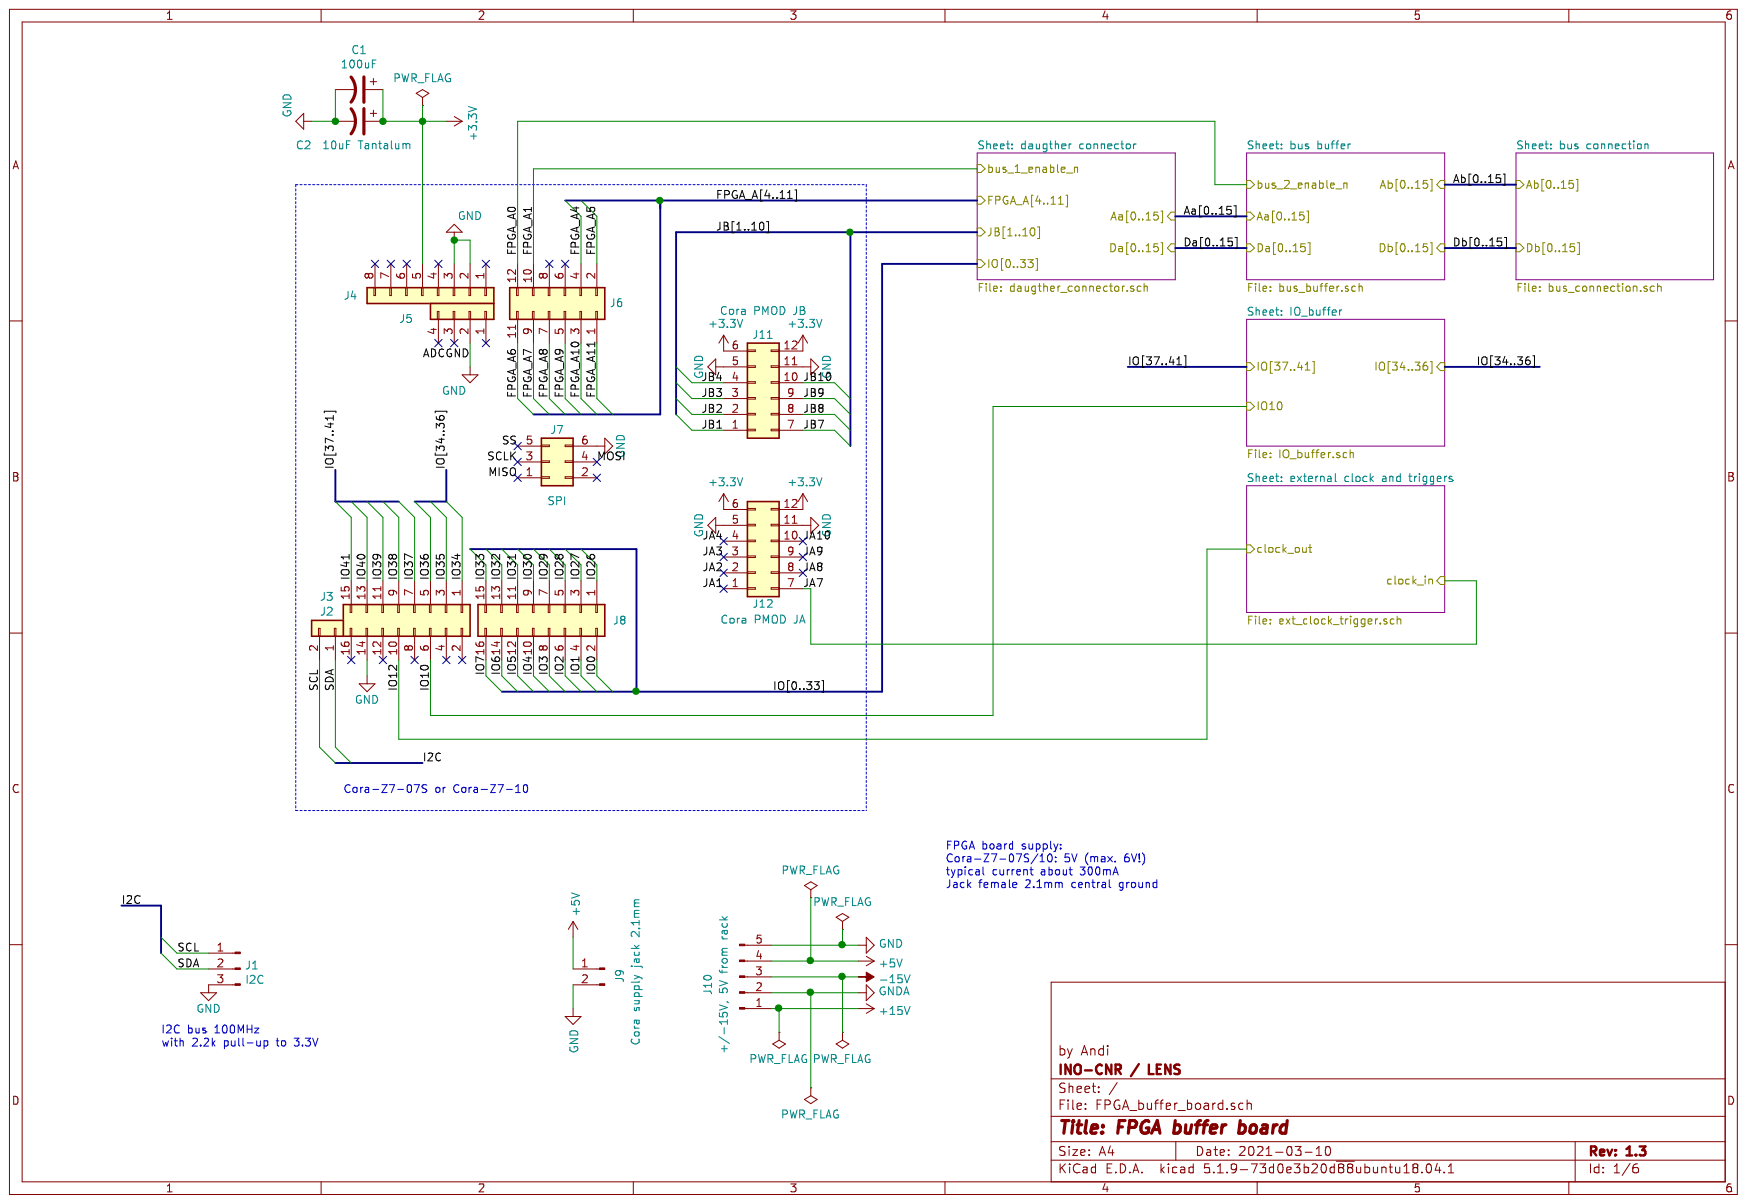
[picture p22: page 1]

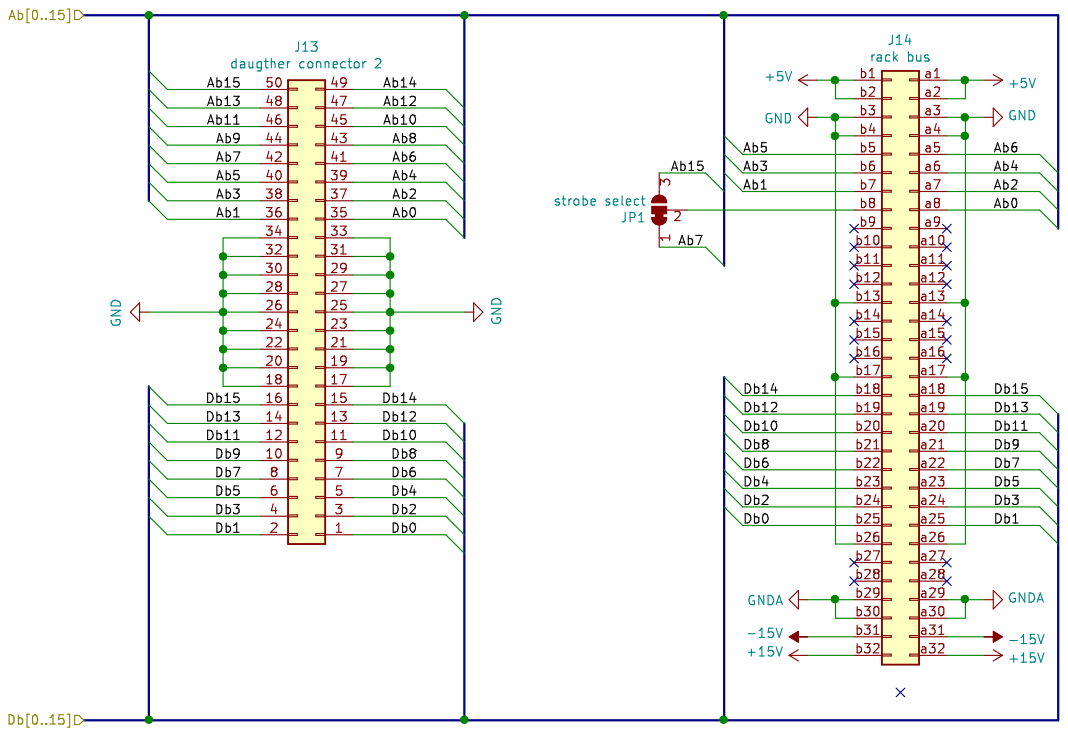
[picture p23: page 2]

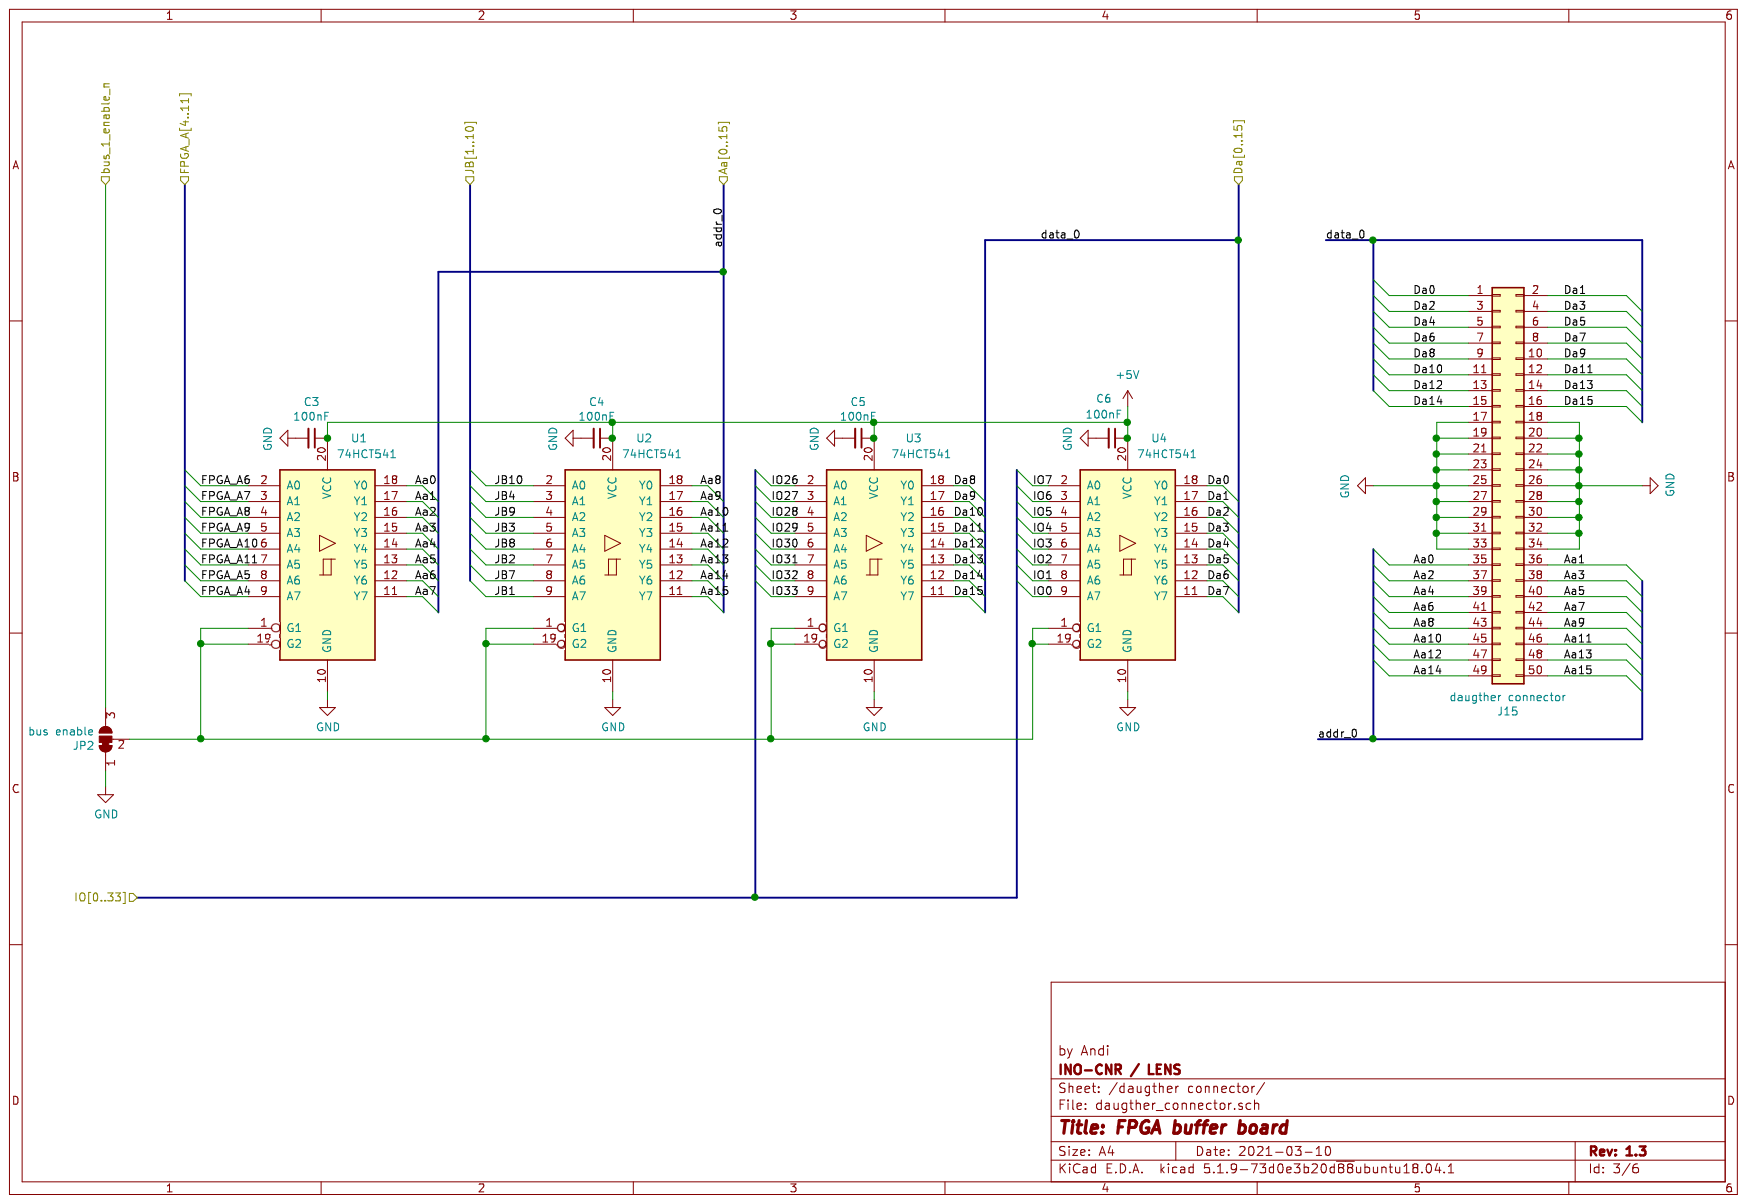
[picture p24: page 3]

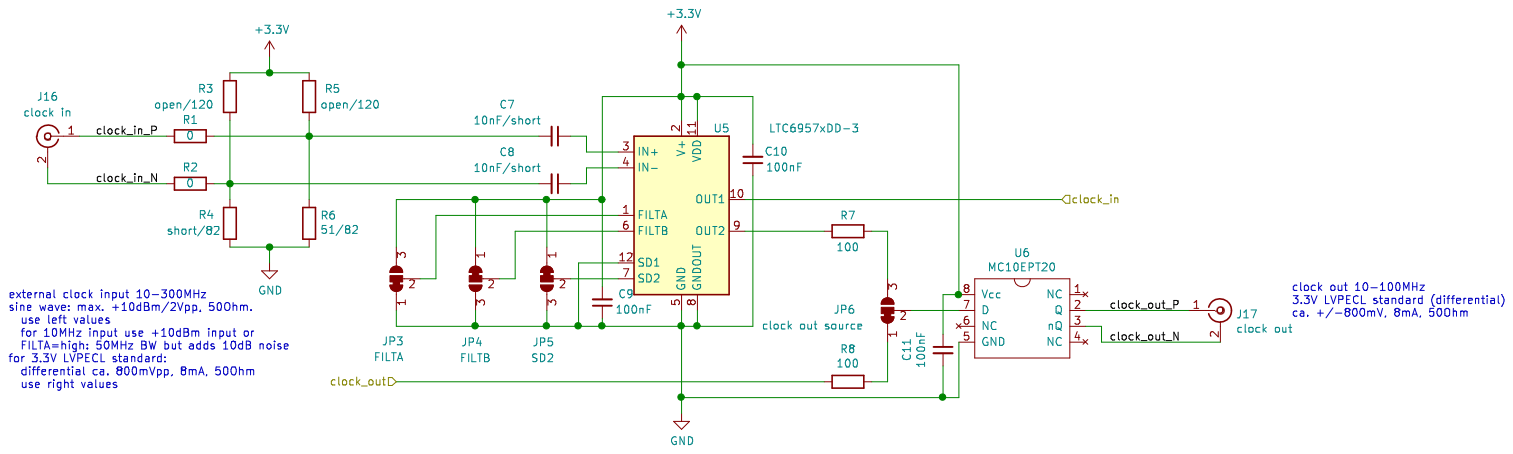
[picture p25: page 4]

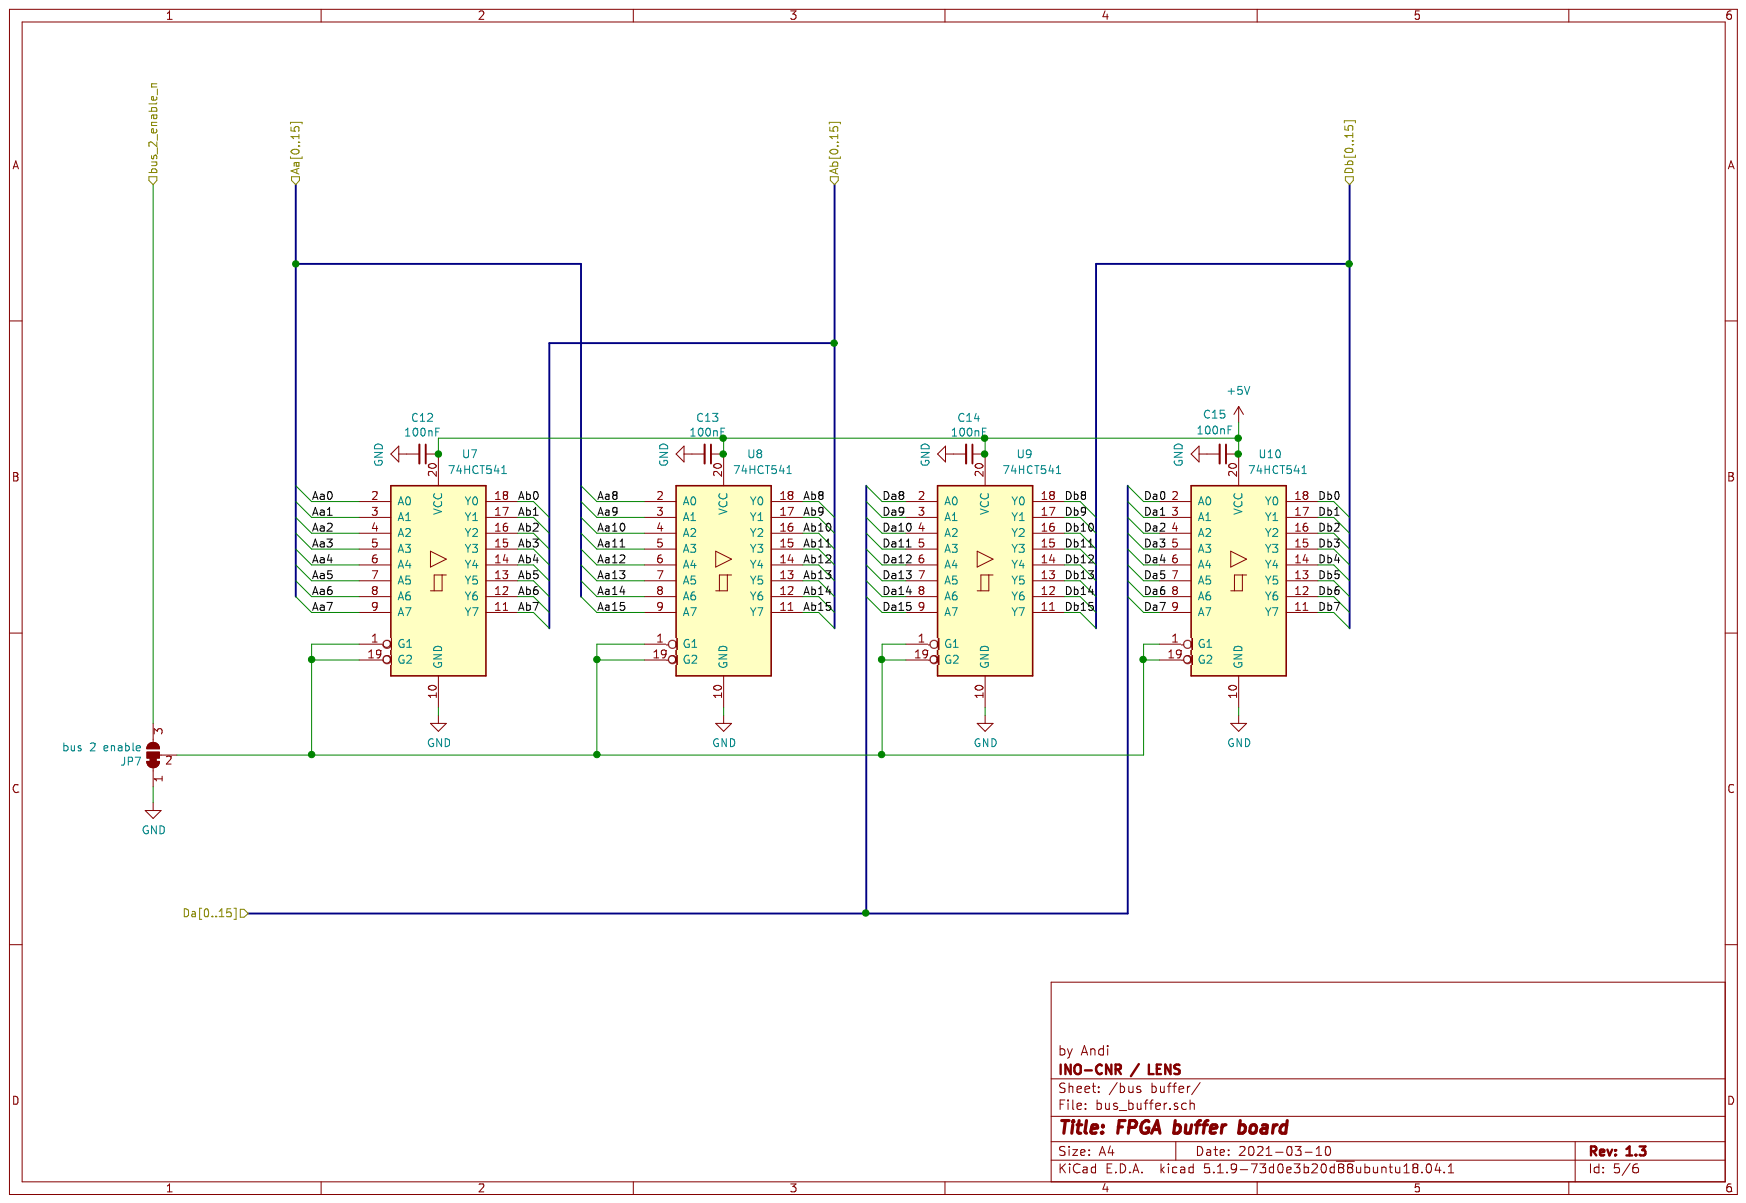
[picture p26: page 5]

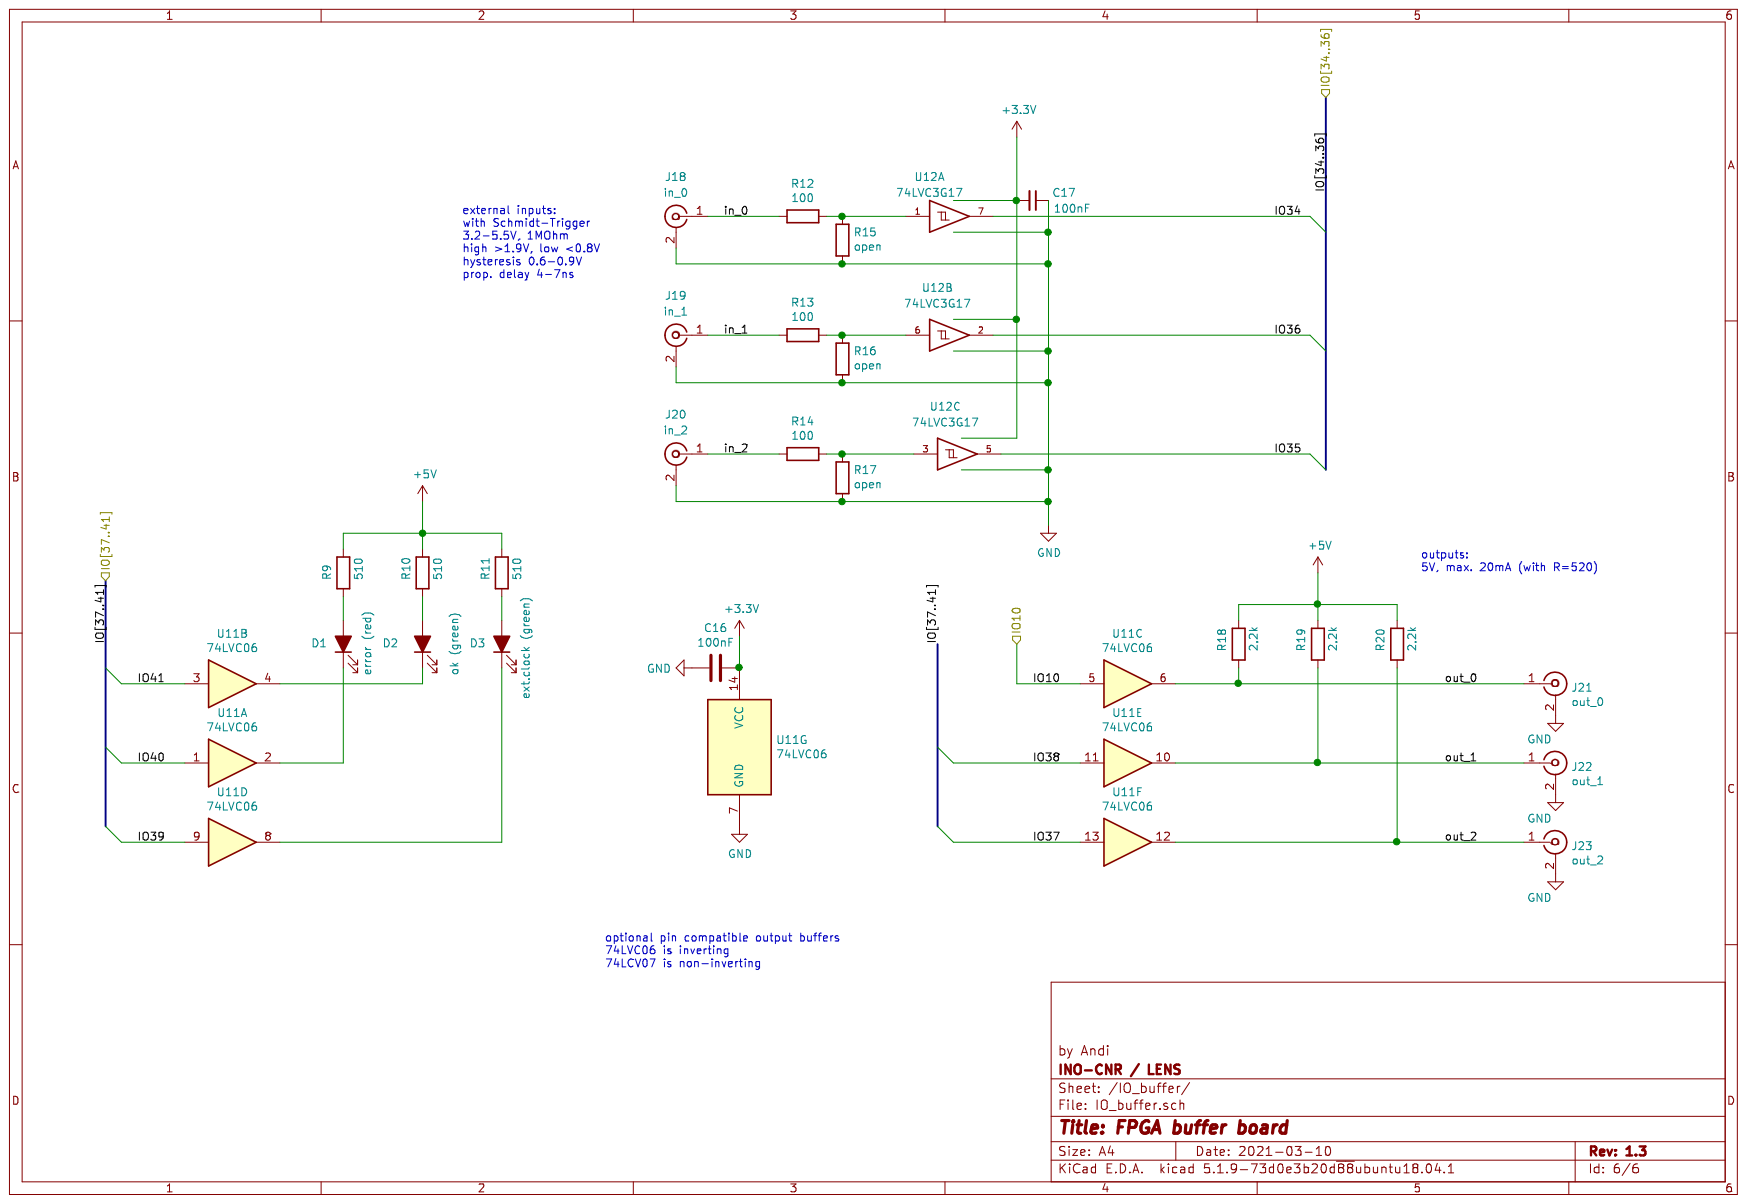
[picture p27: page 6]
