INO-quantum/FPGA-SoC-experiment-control/buffer-card/v1.3/v1.3.2/production/FPGA_buffer_board_v1.3.2_schematics.pdf

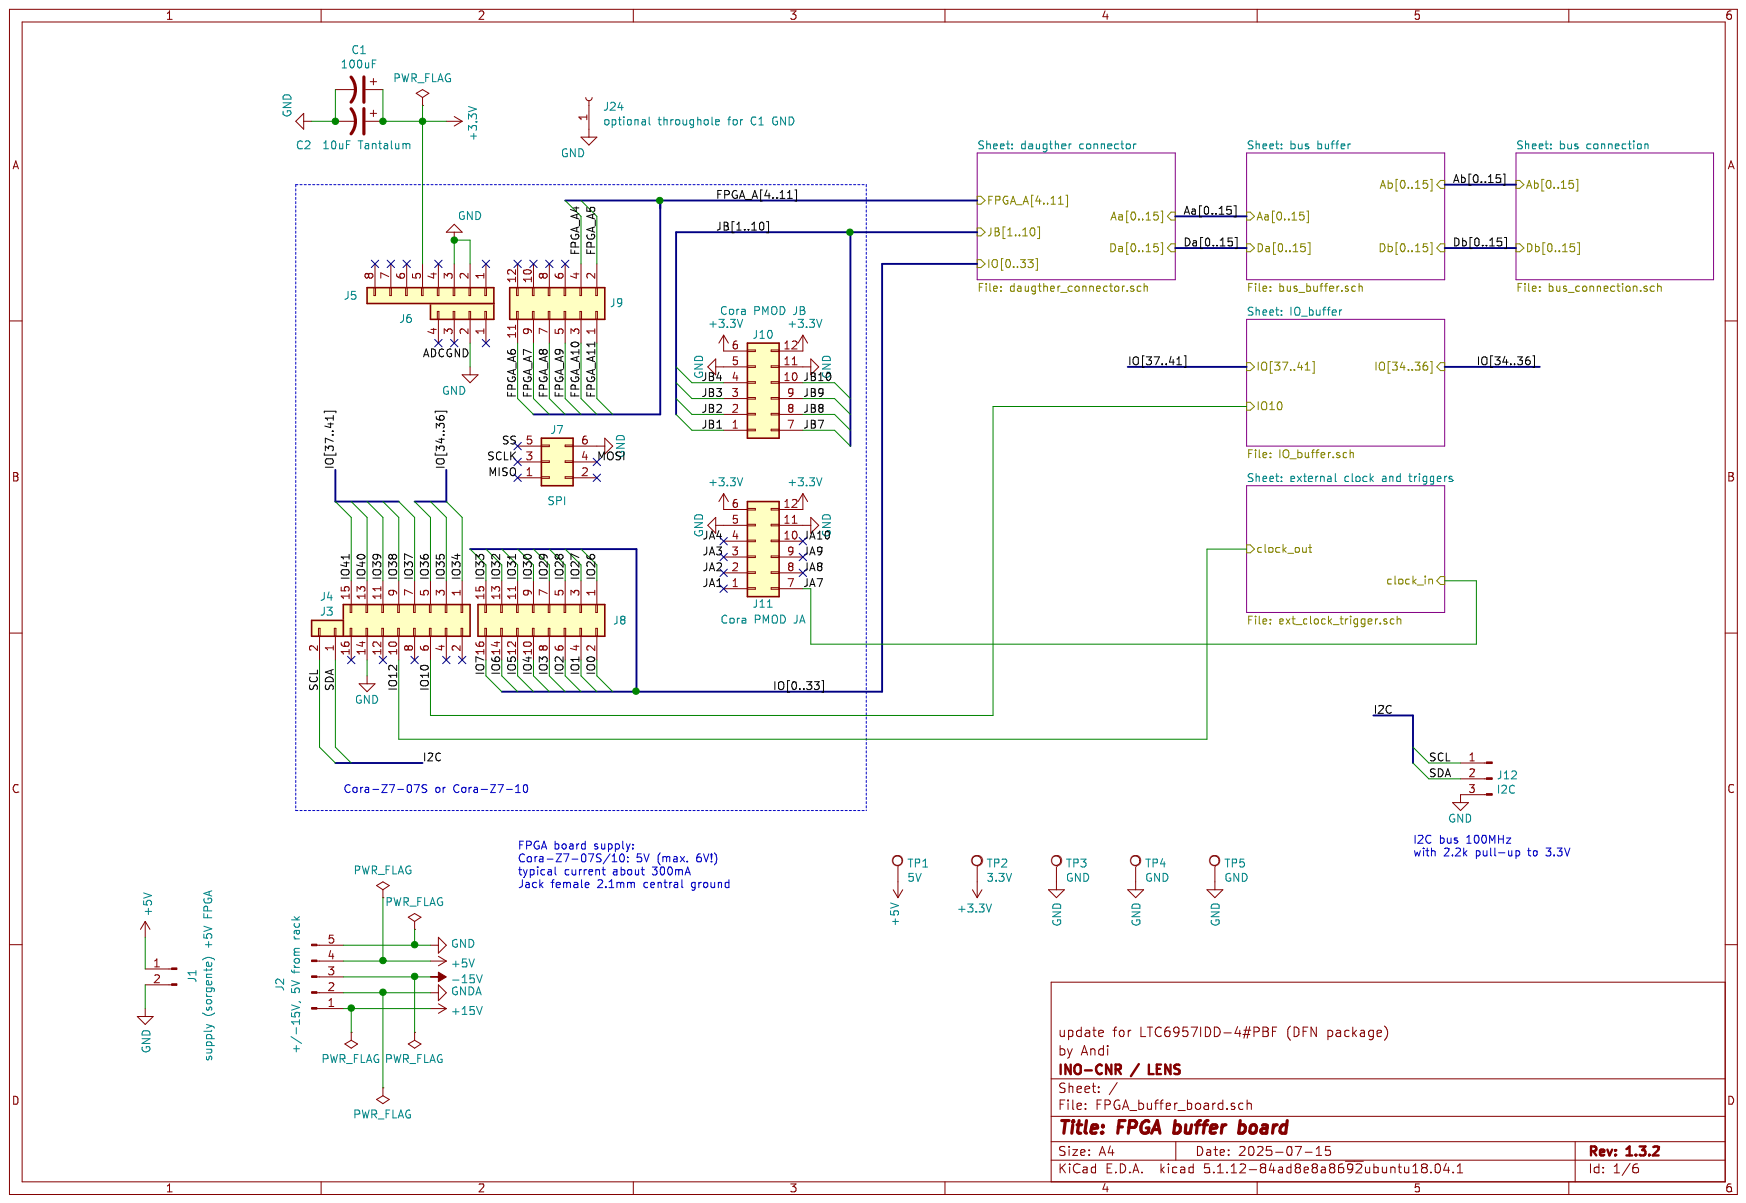
[picture p28: page 1]

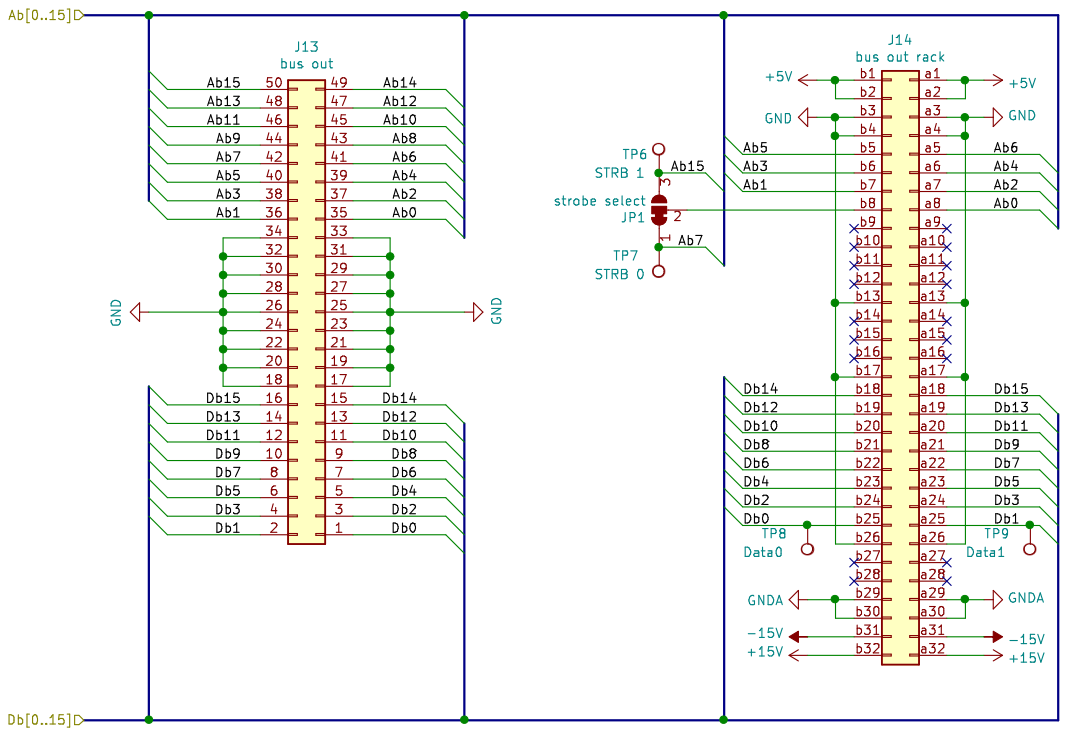
[picture p29: page 2]

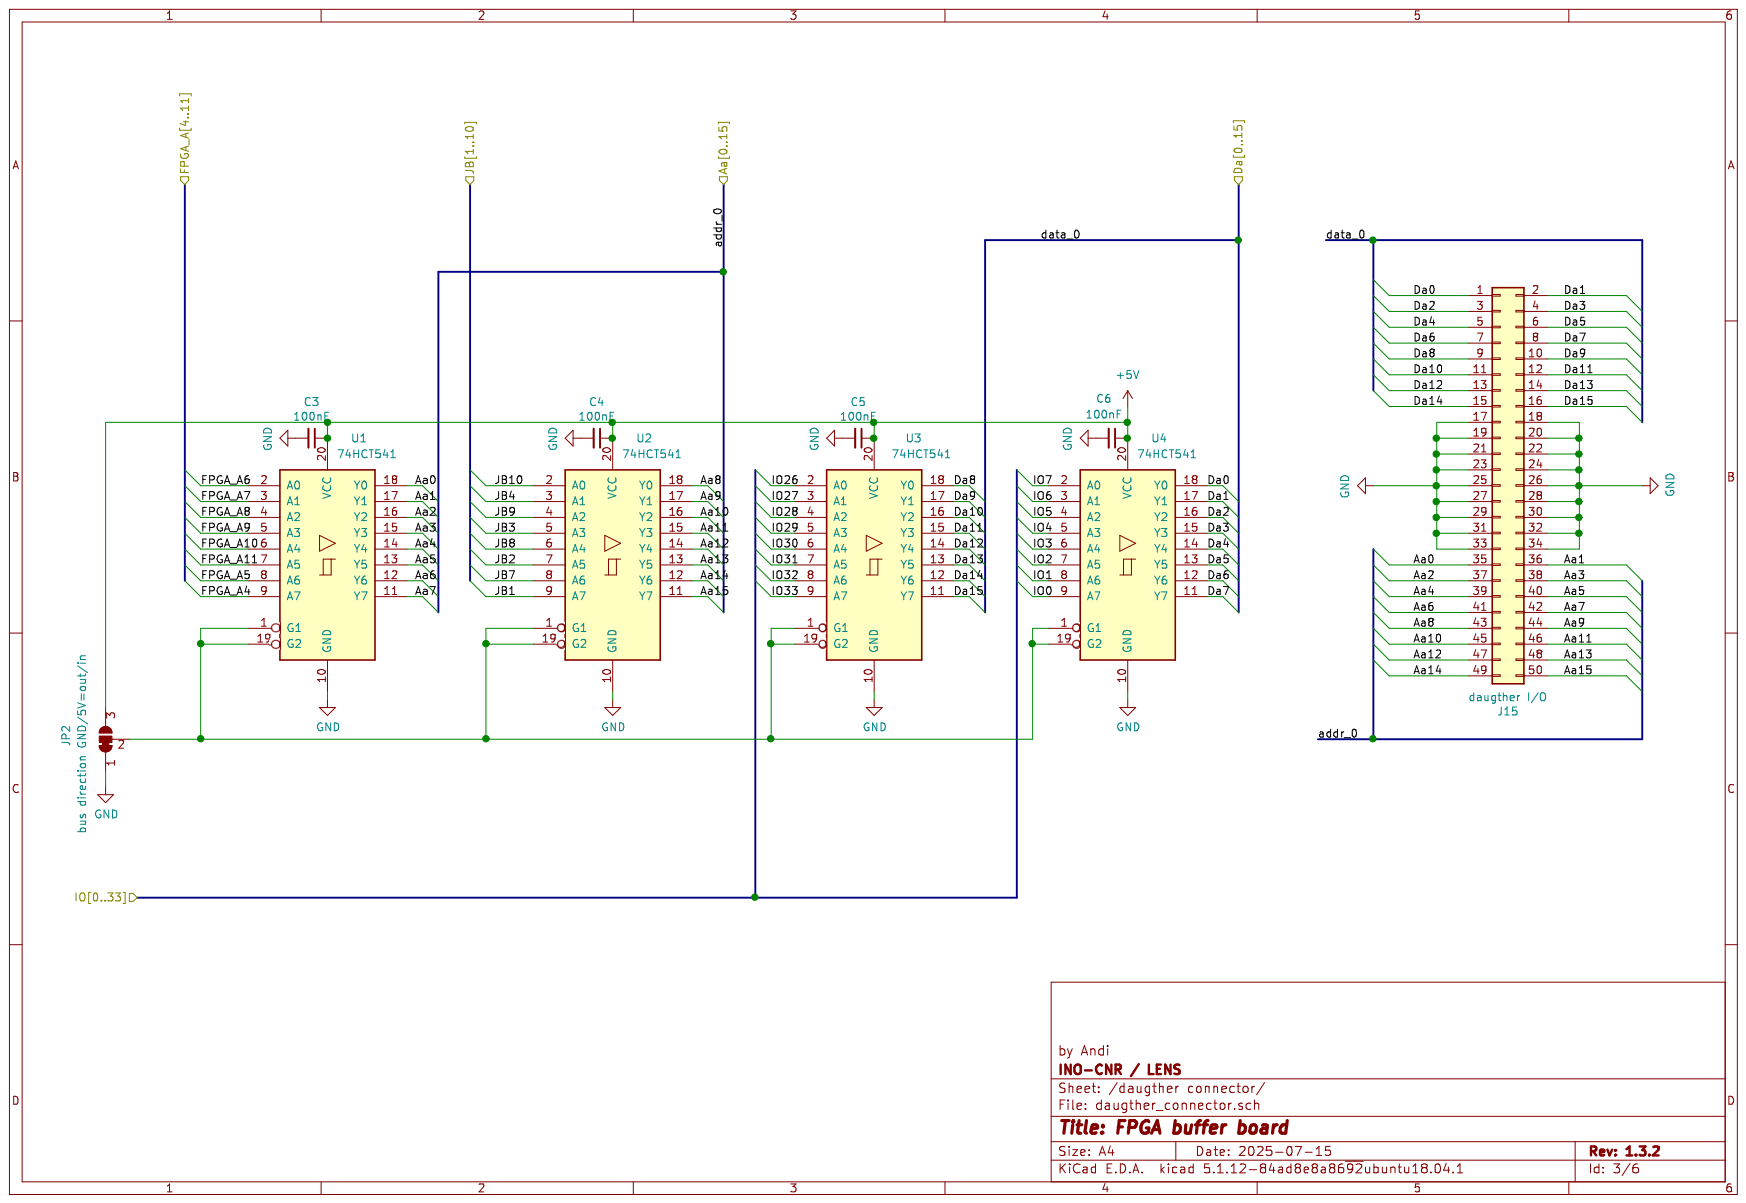
[picture p30: page 3]

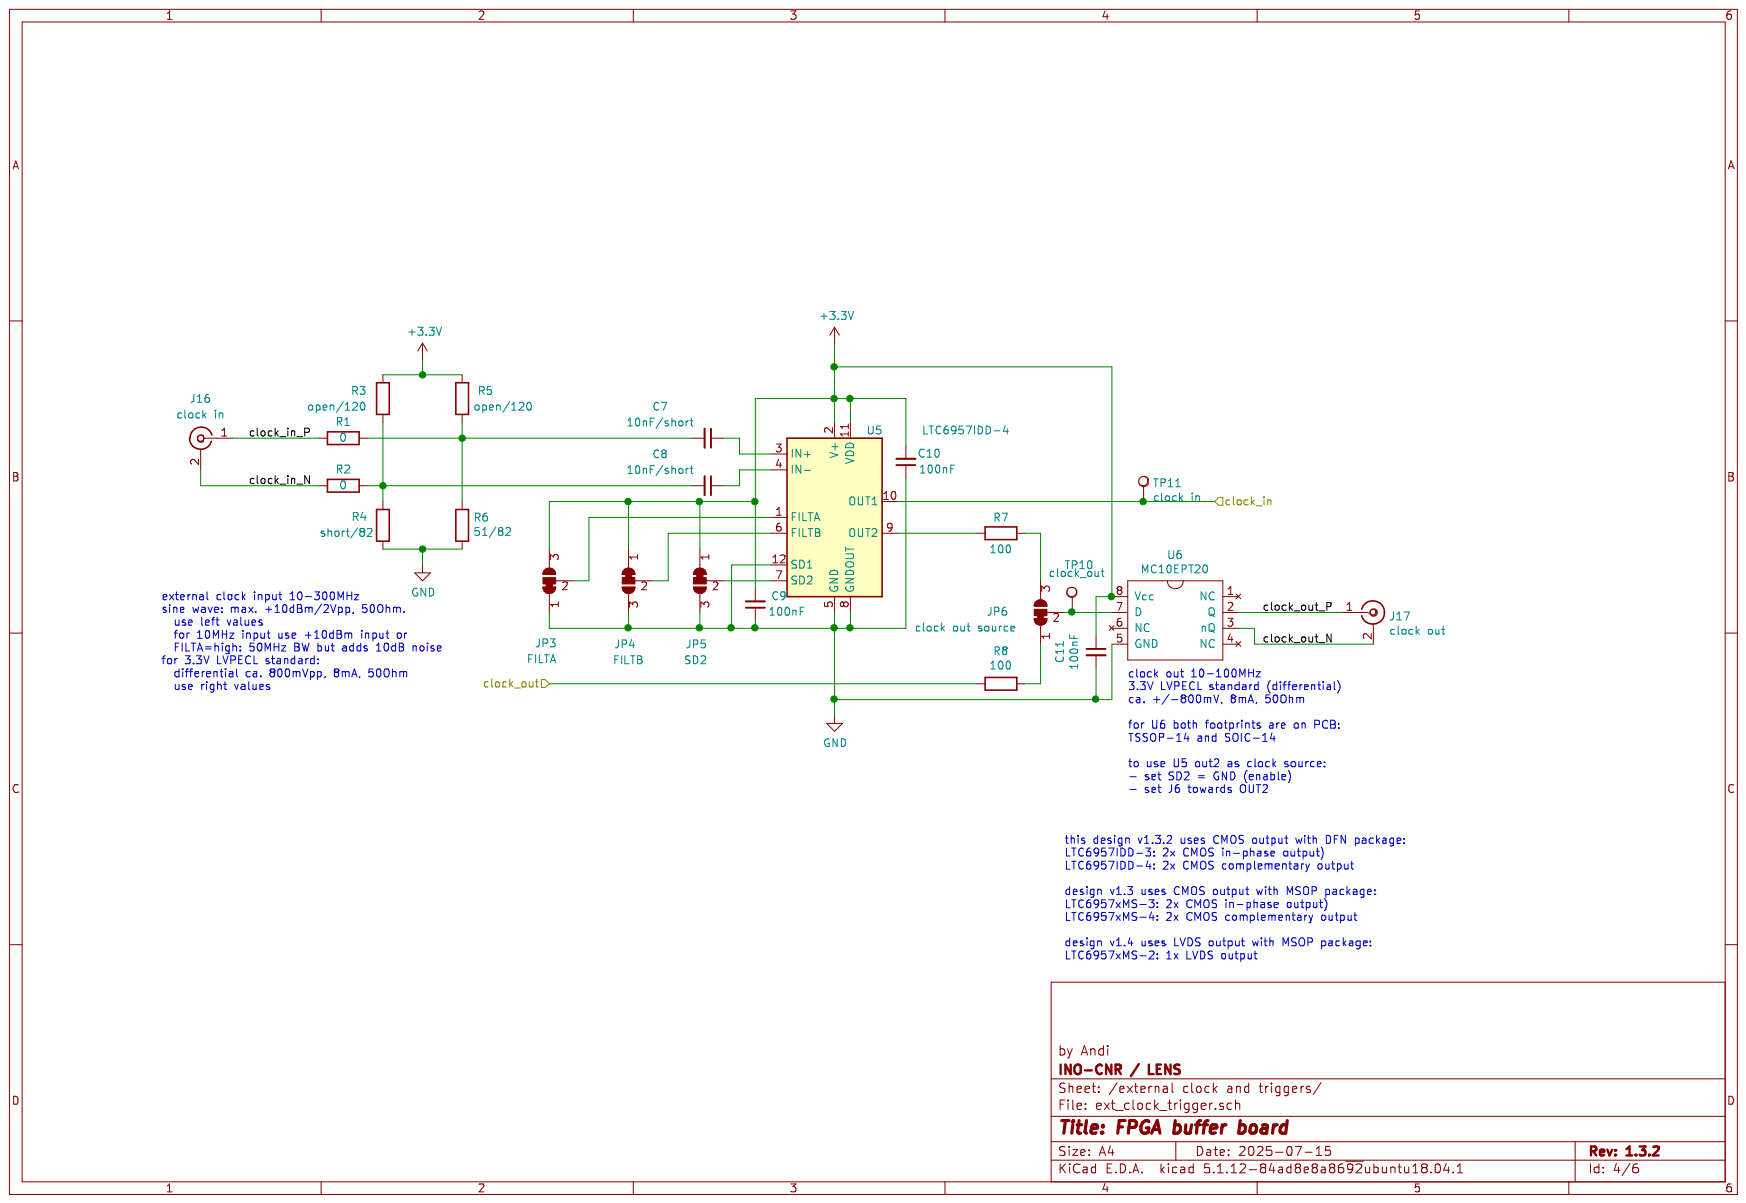
[picture p31: page 4]

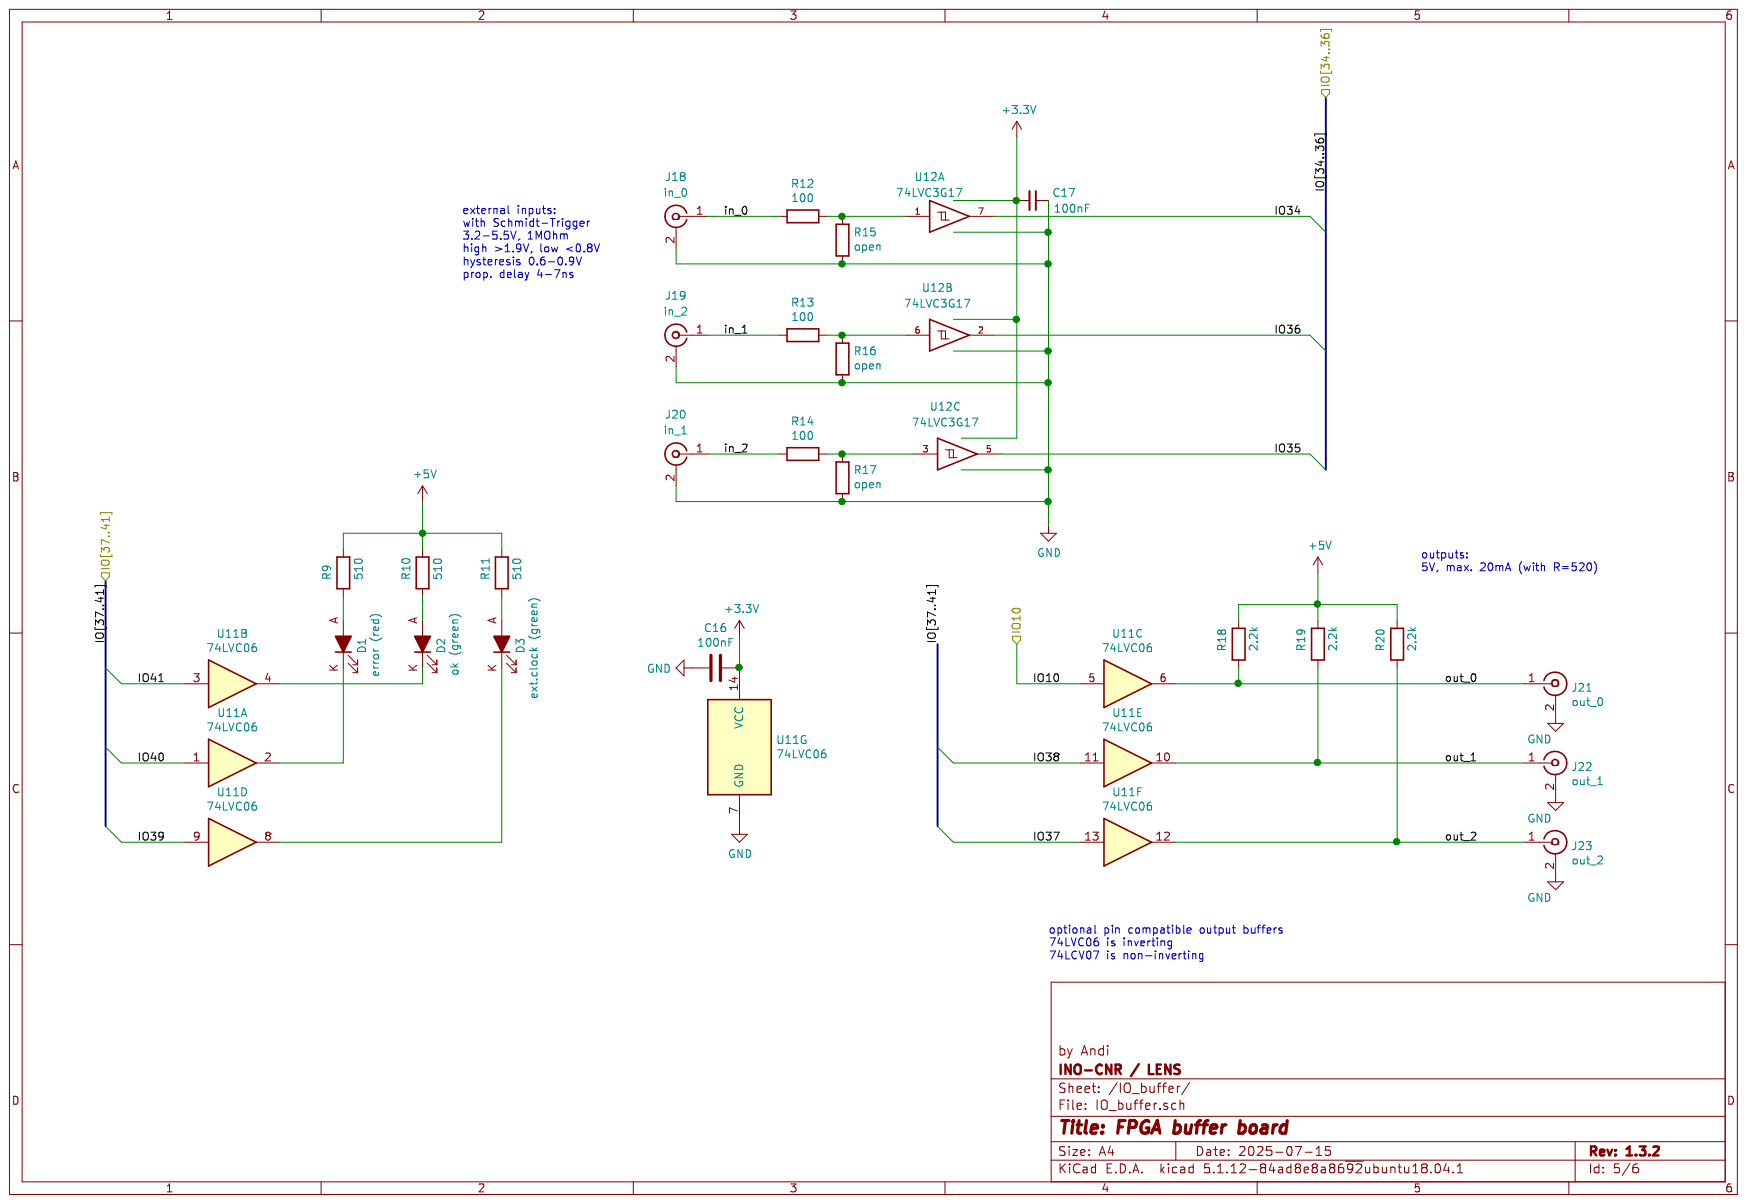
[picture p32: page 5]

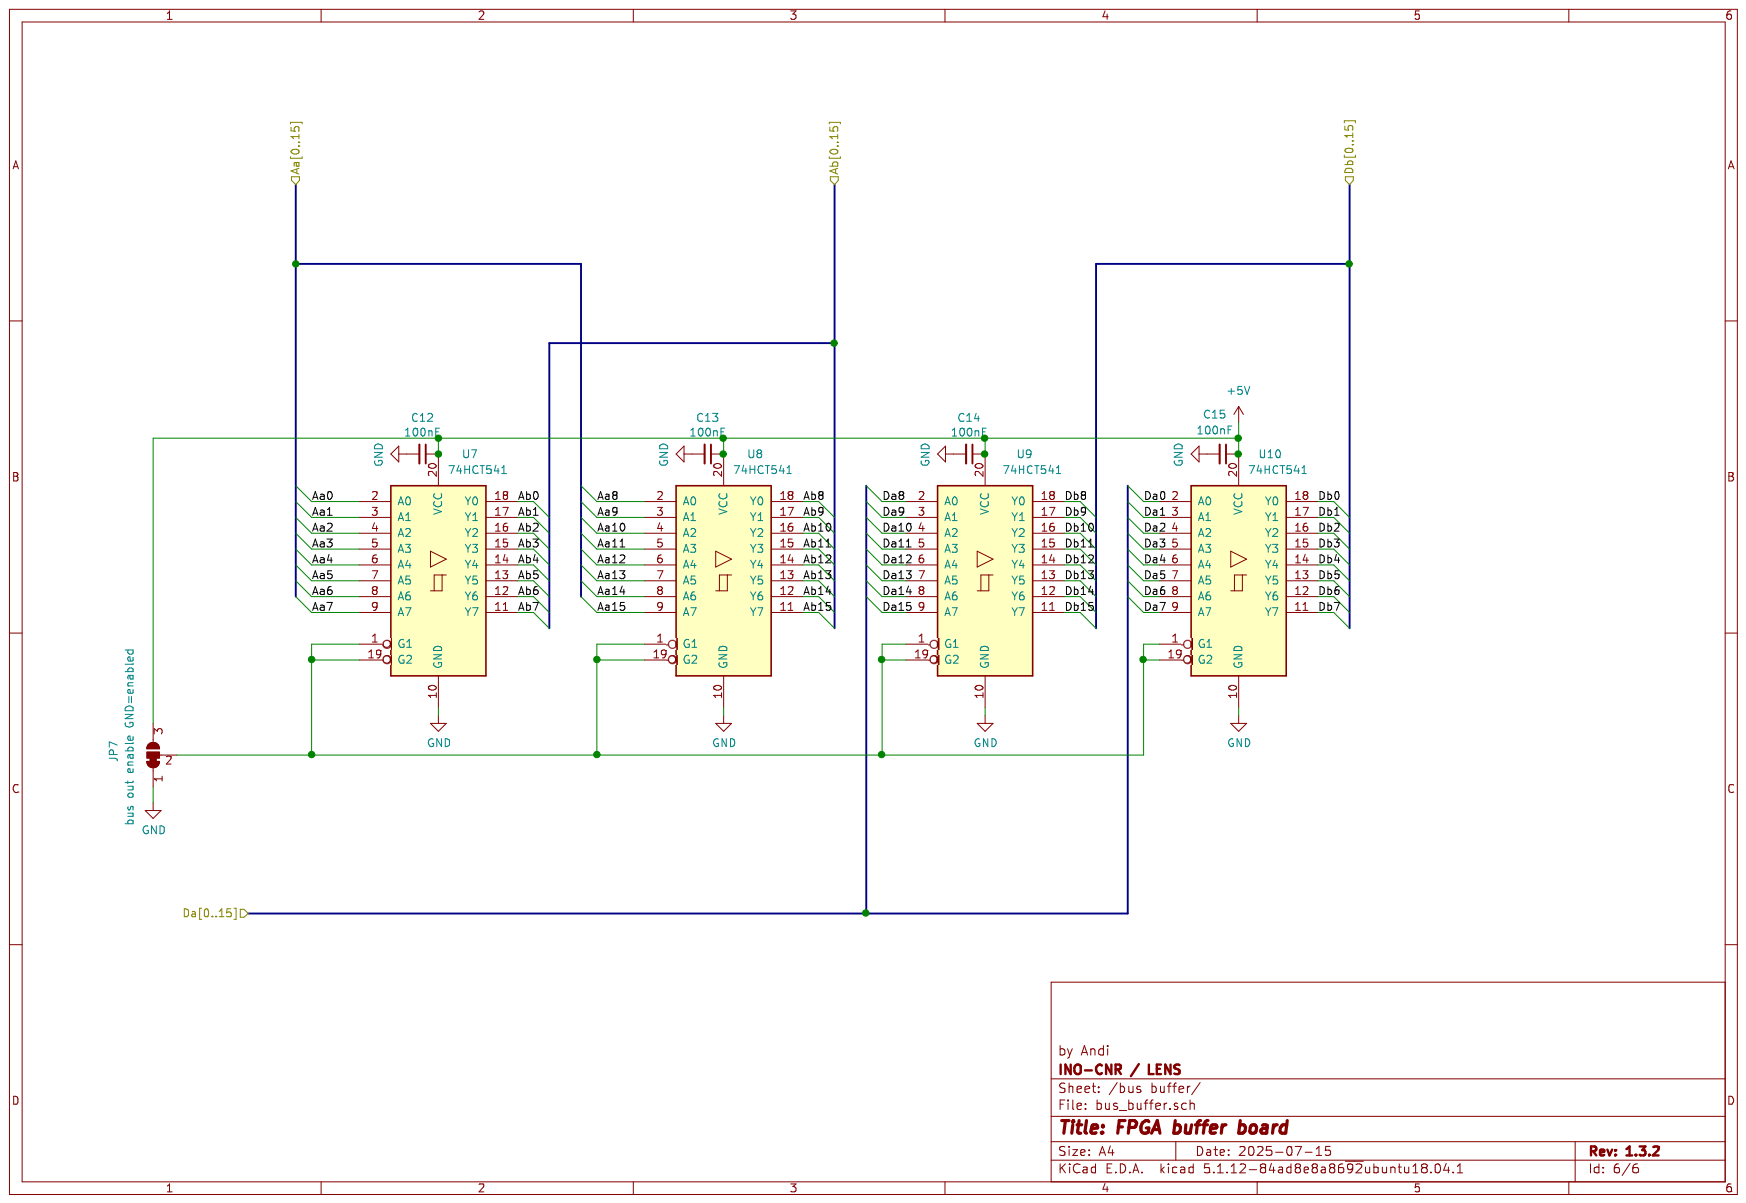
[picture p33: page 6]
