INO-quantum/FPGA-SoC-experiment-control/buffer-card/v1.2/FPGA_buffer_board_v1.2_scheme.pdf

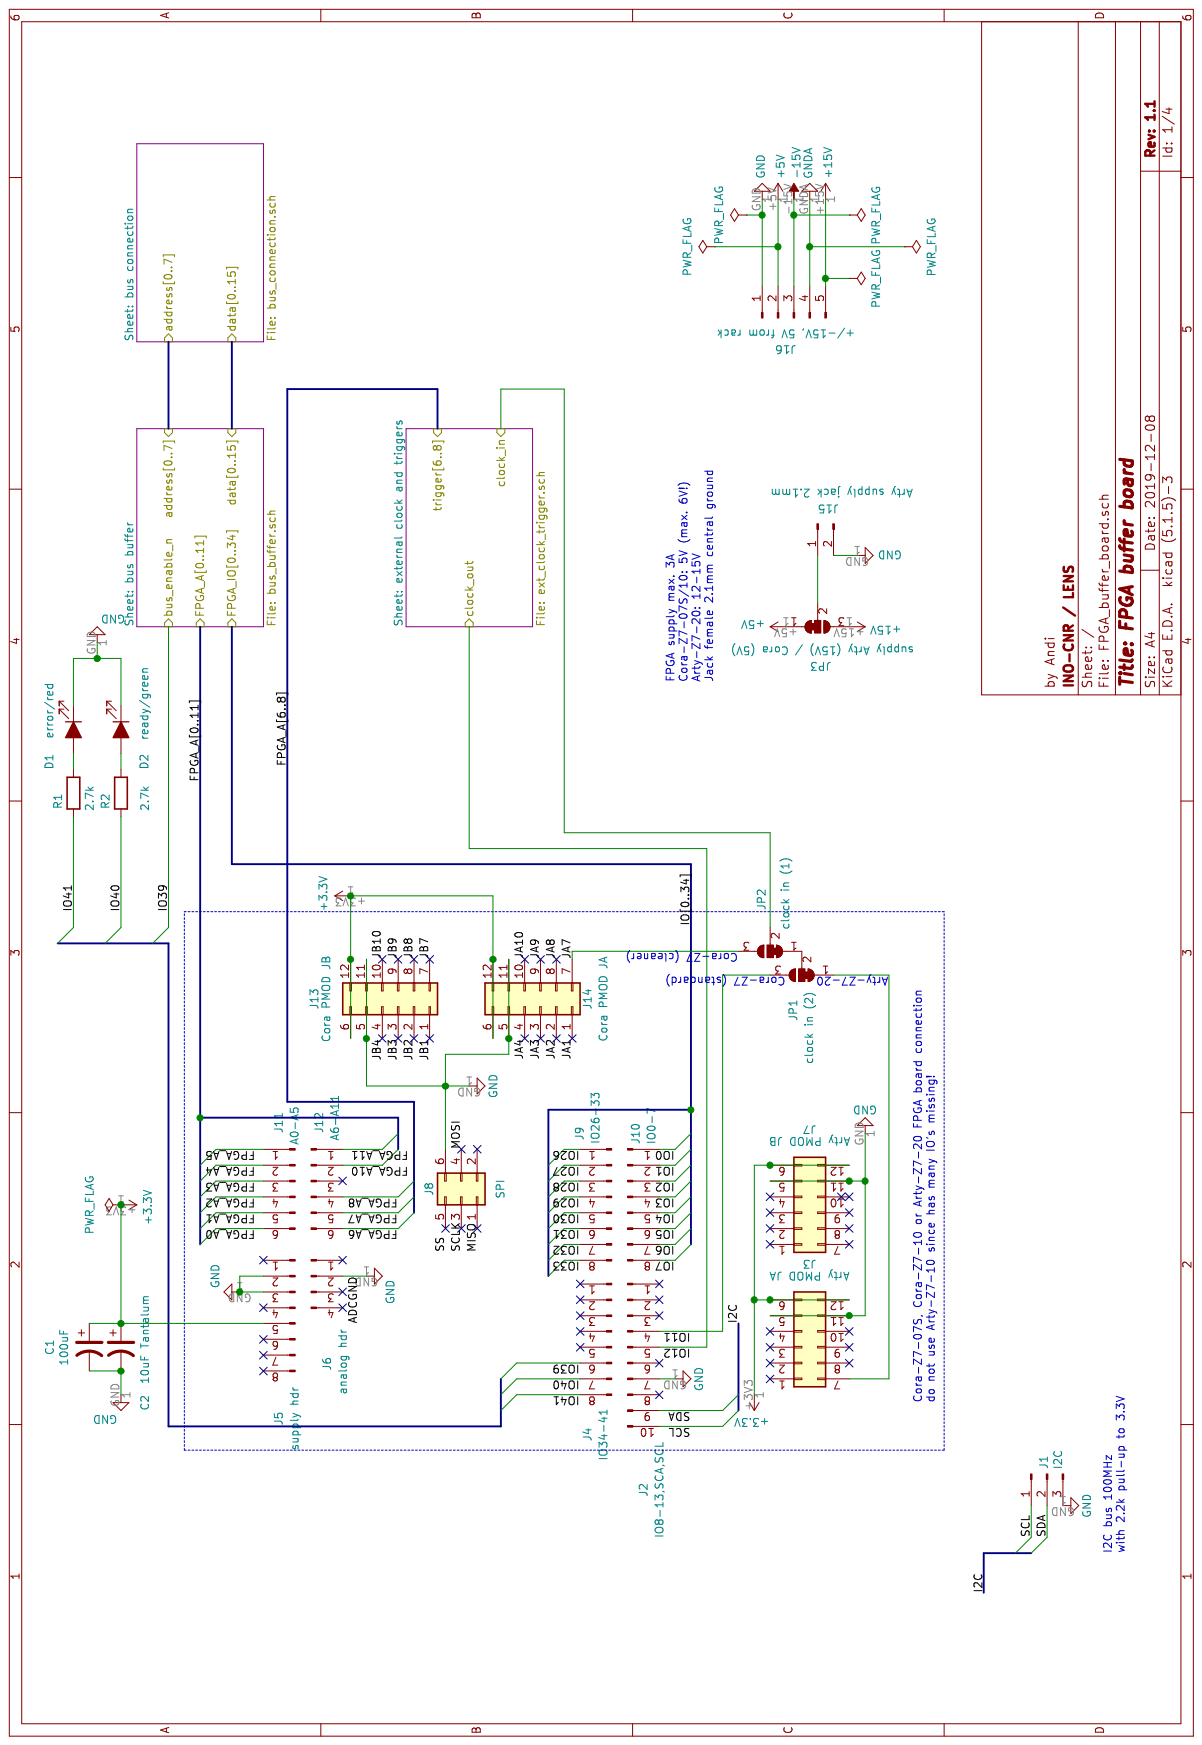
[picture p34: page 1]

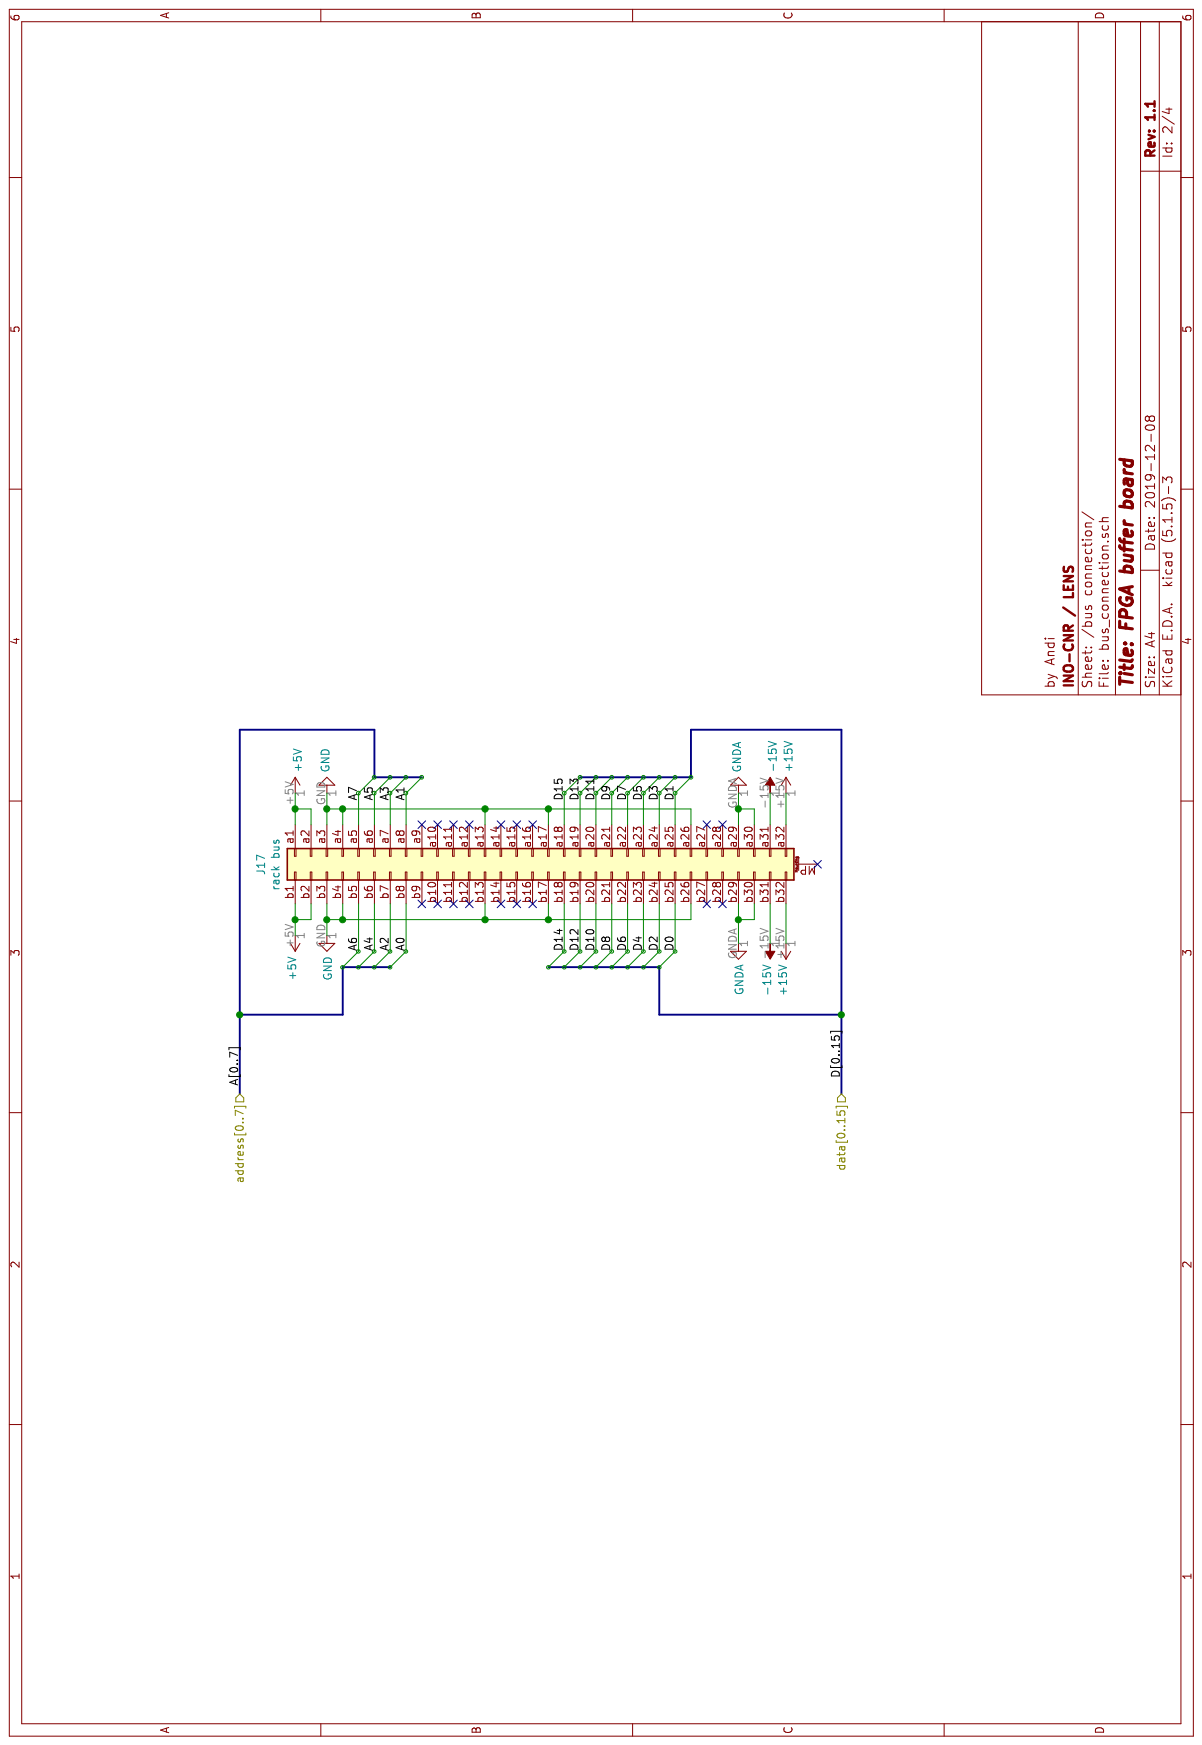
[picture p35: page 2]

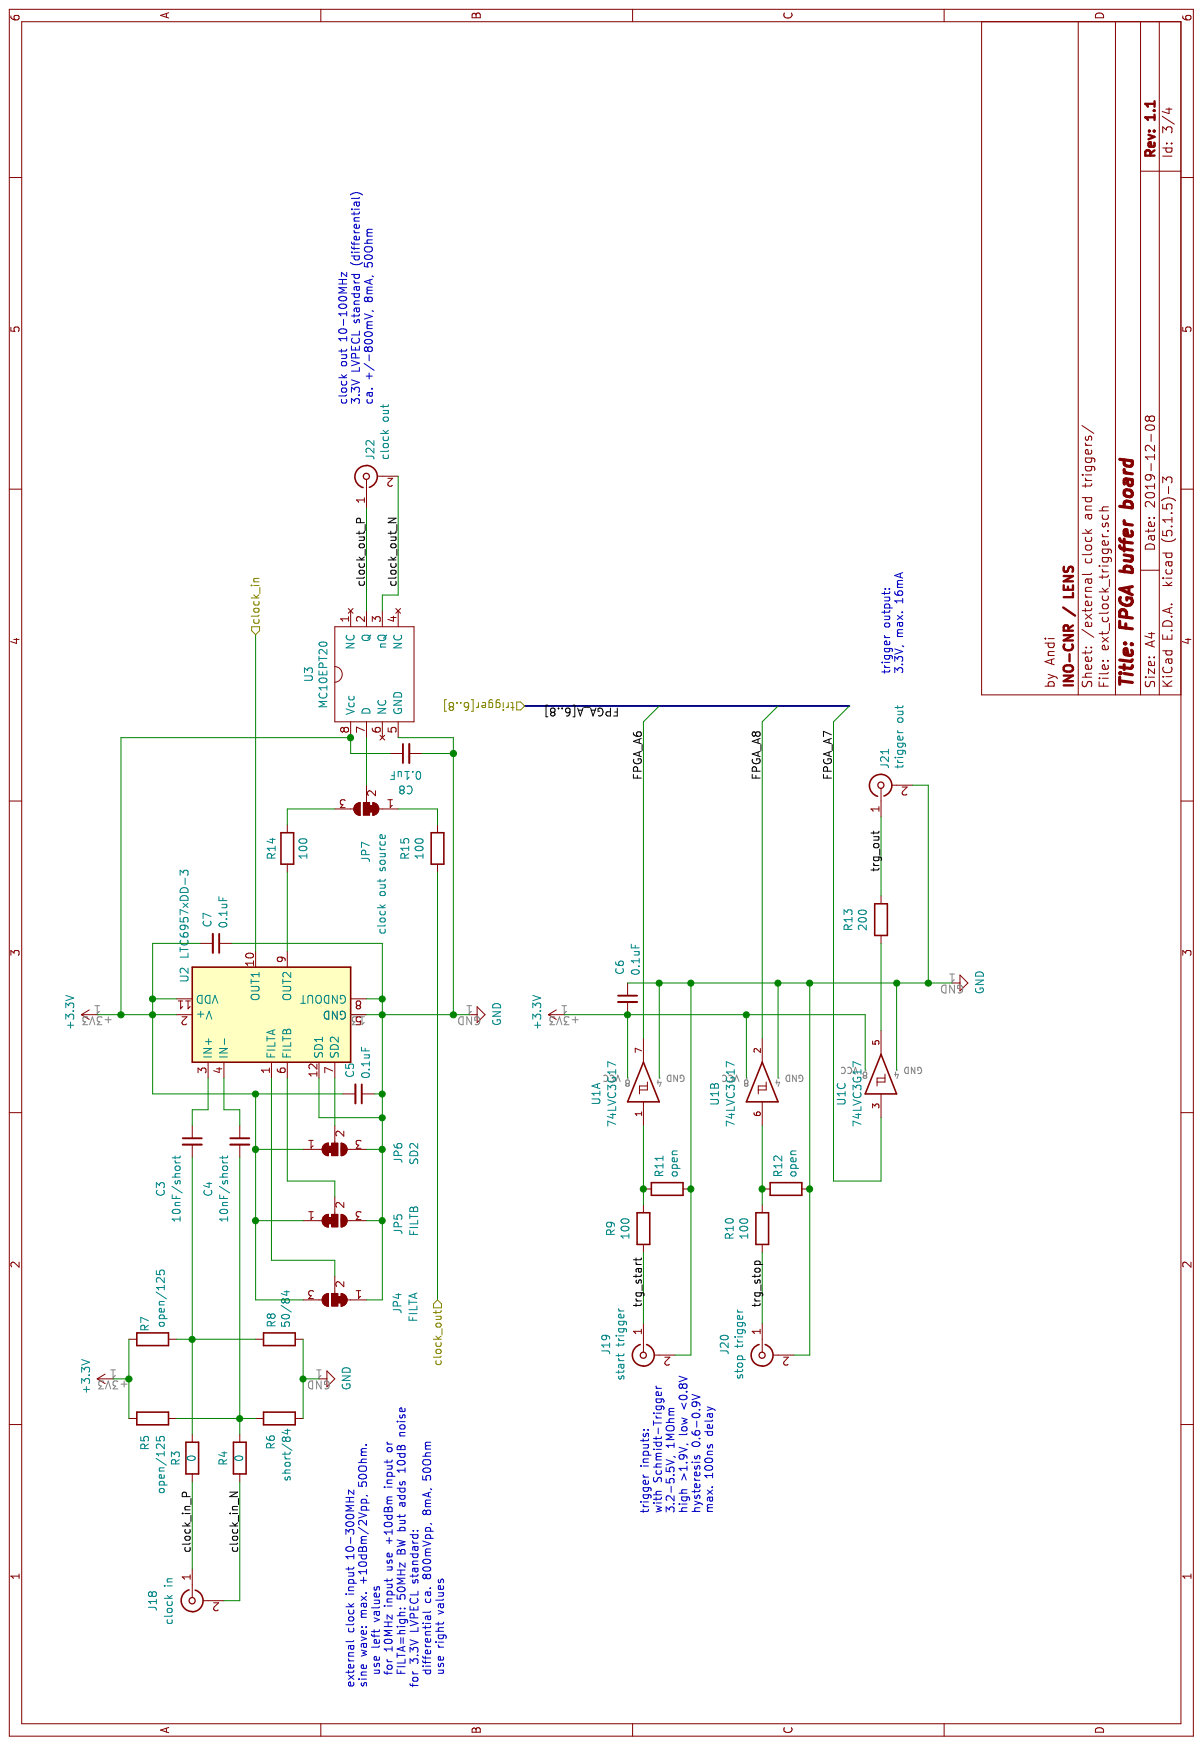
[picture p36: page 3]

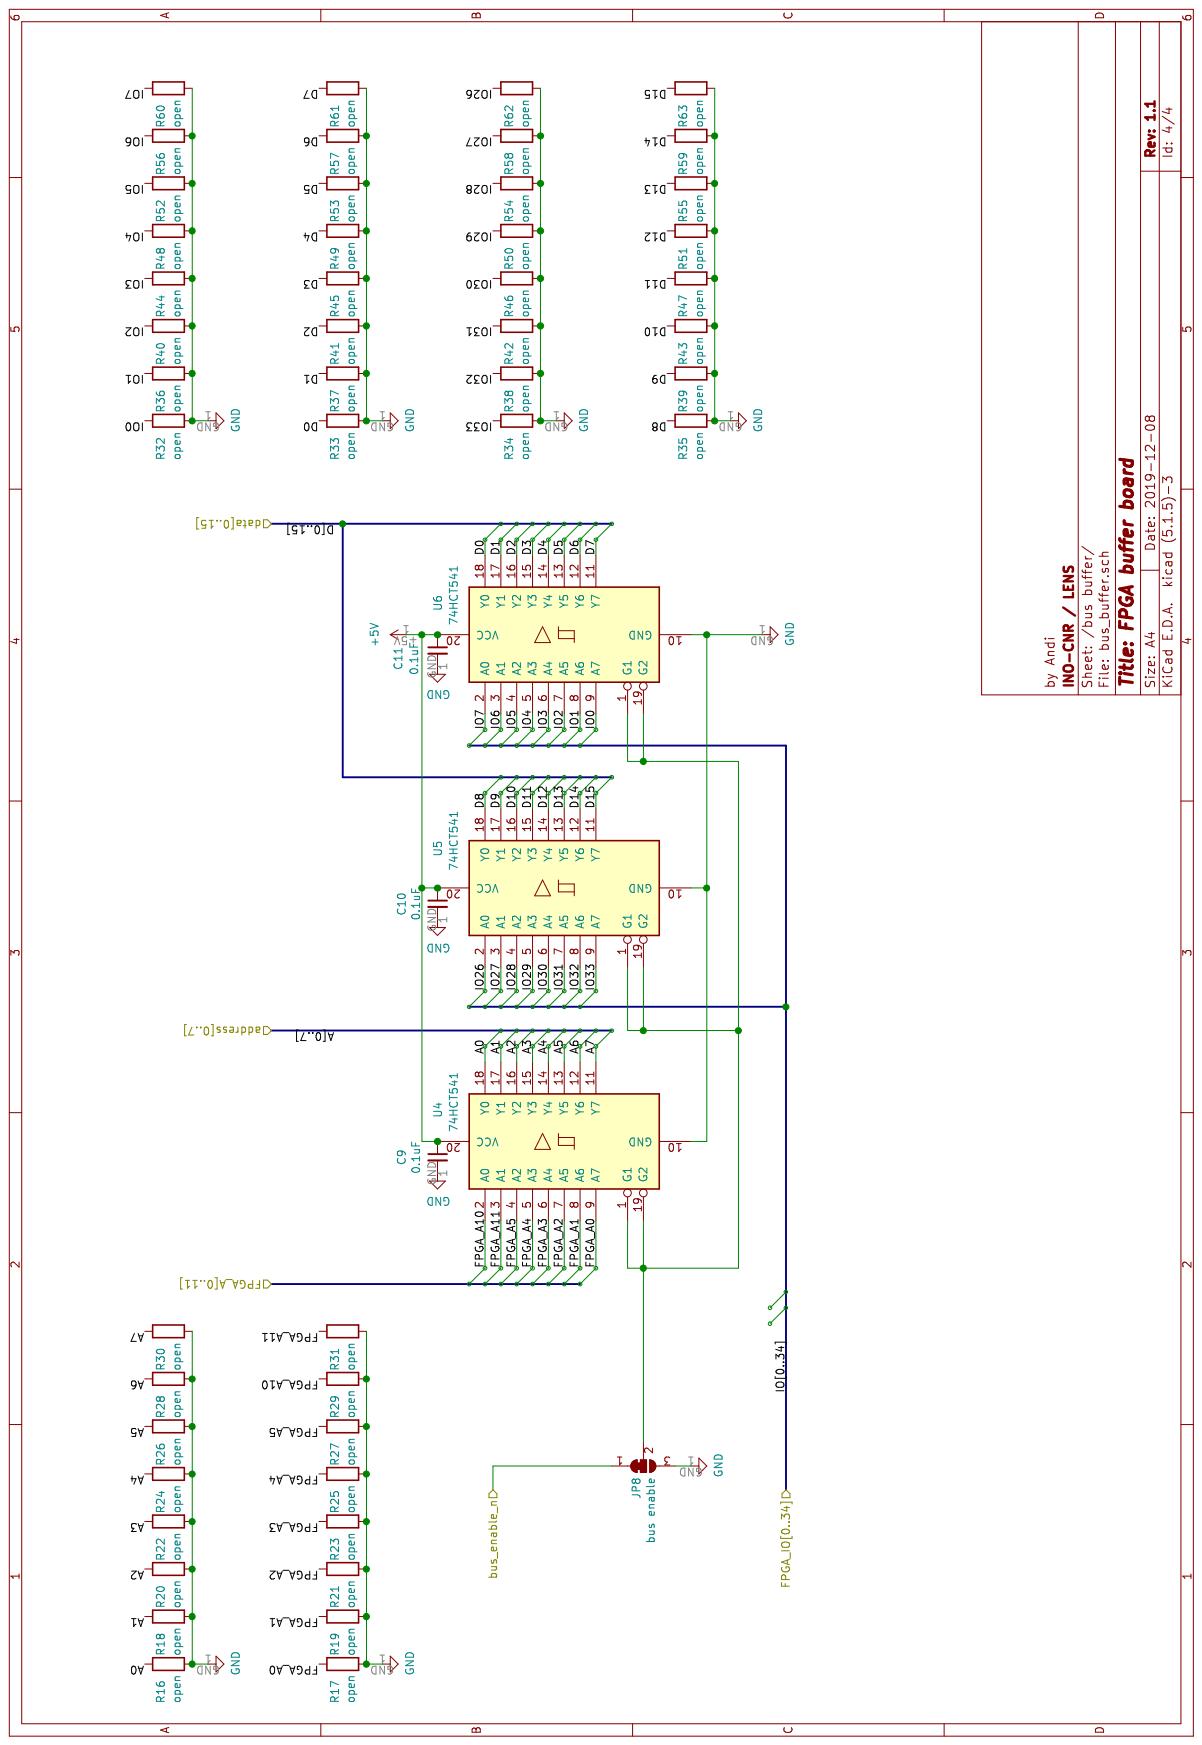
[picture p37: page 4]
