INO-quantum/FPGA-SoC-experiment-control/buffer-card/v1.3/v1.3.2/production/FPGA_buffer_board_v1.3.2_back.pdf

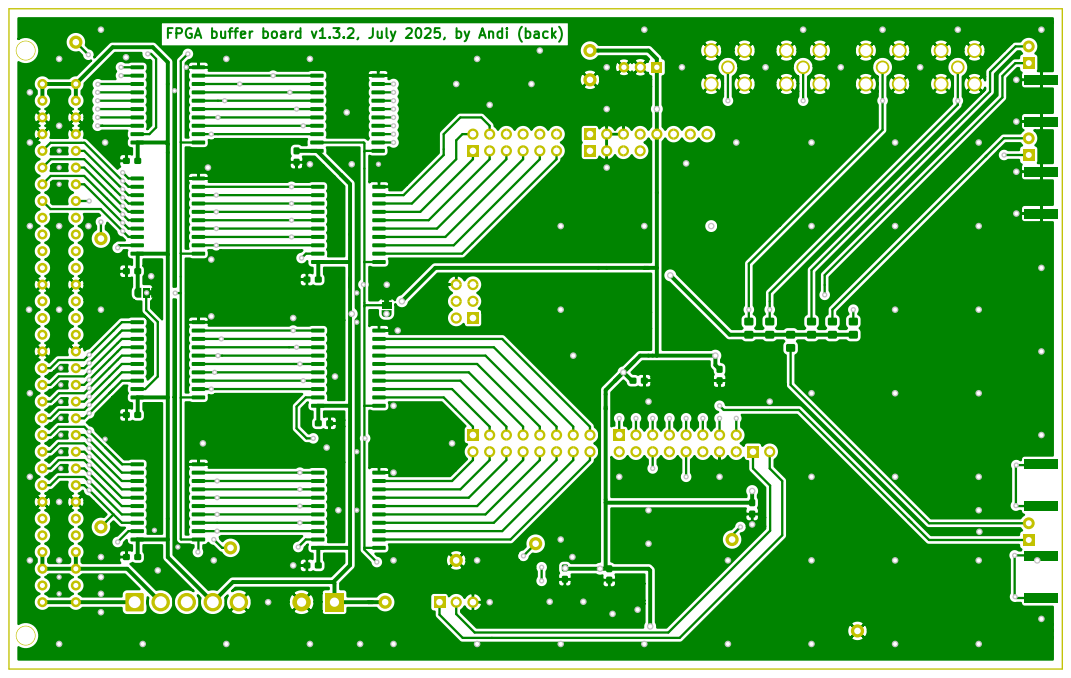
[picture p38: page 1]
