INO-quantum/FPGA-SoC-experiment-control/buffer-card/v1.3/v1.3.2/production/FPGA_buffer_board_v1.3.2_front.pdf

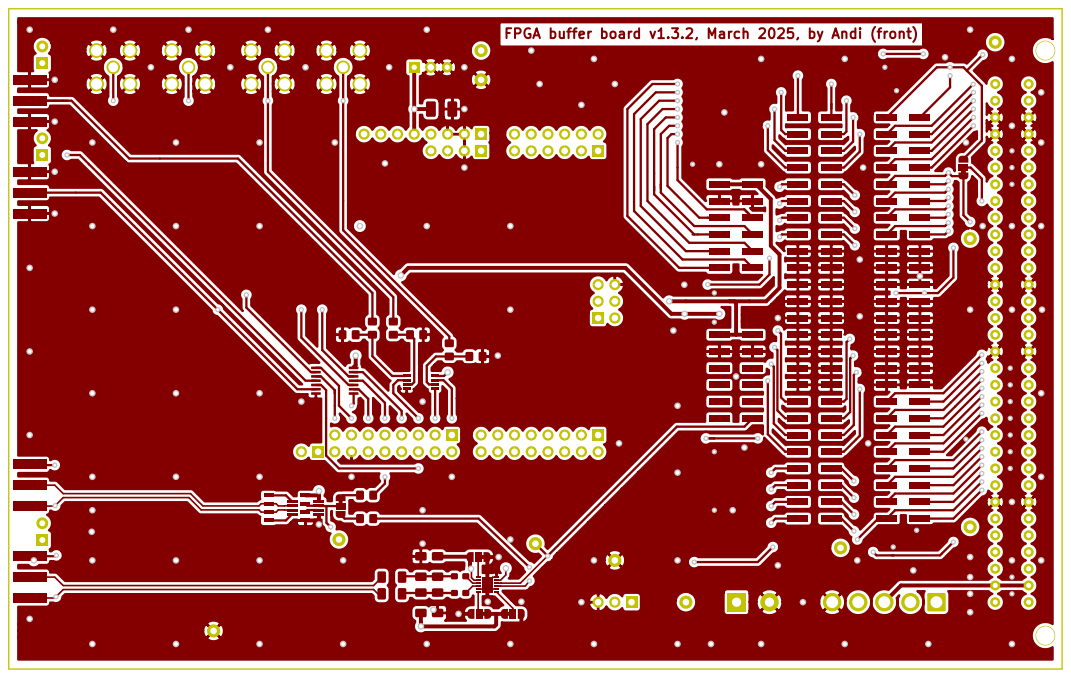
[picture p39: page 1]
