INO-quantum/FPGA-SoC-experiment-control/buffer-card/v1.3/v1.3.1/production/FPGA_buffer_board_v1.3_front.pdf

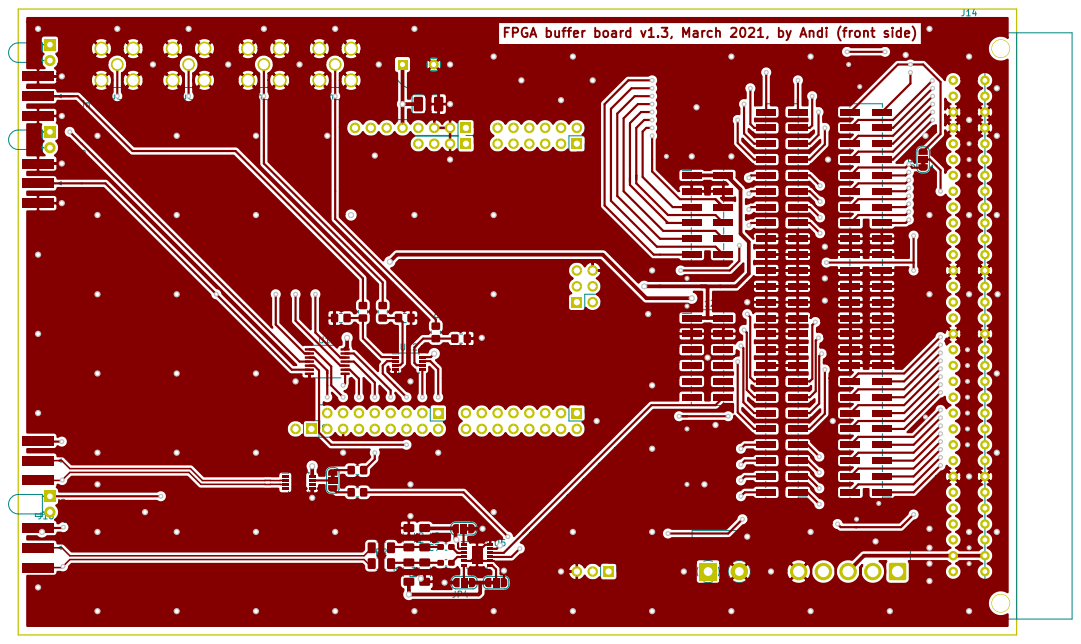
[picture p41: page 1]
