INO-quantum/FPGA-SoC-experiment-control/firmware-source/2020.1/labscript/user_devices/FPGA_device.py

#####################################################################
# FPGA-SoC device by Andreas Trenkwalder
# works as PseudoClockDevice
# created 6/4/2021
# last change 30/6/2024 by Andi
#####################################################################

from __future__ import generator_stop
import labscript.labscript
from labscript import (
    PseudoclockDevice, Pseudoclock, ClockLine, IntermediateDevice,
    DDS, DigitalOut, AnalogOut, Output, DDSQuantity,
    set_passed_properties, LabscriptError, config,
    add_time_marker,
    )
from labscript_devices import BLACS_tab, runviewer_parser
from labscript_utils.setup_logging import setup_logging
from labscript_utils import import_or_reload
from labscript_utils.unitconversions import get_unit_conversion_class
from labscript_utils.qtwidgets.toolpalette import ToolPaletteGroup
from labscript_utils.qtwidgets.digitaloutput import DigitalOutput
from labscript_utils.qtwidgets.analogoutput import AnalogOutput
import logging

# used for unit conversion inverse function
#from scipy.optimize import newton

import numpy as np
from time import sleep
from time import perf_counter as get_ticks
from time import process_time as get_ticks2
import struct
import h5py, labscript_utils.h5_lock
#import libusb
#libusb.config(LIBUSB=None)

import sys

from qtutils.qt.QtWidgets import *
from PyQt5.QtCore import *
from PyQt5.QtGui import *
from PyQt5.QtWidgets import *

from blacs.tab_base_classes import Worker, define_state, MODE_MANUAL, MODE_TRANSITION_TO_BUFFERED, MODE_TRANSITION_TO_MANUAL, MODE_BUFFERED
from blacs.device_base_class import DeviceTab

# note: do not import MOGLabs_QRF here!
#       it seems Python cannot handle circular references!
#       the error occurred during compilation of connection table with BLACS.
#from user_devices.MOGLabs_QRF import MOGLabs_QRF

# reduce number of log entries in logfile (labscript-suite/logs/BLACS.log)
log_level = [logging.CRITICAL, logging.ERROR, logging.WARNING, logging.INFO, logging.DEBUG, logging.NOTSET][2]

# set this to True when you have a problem to start BLACS. resets all stored values to default.
# can happen when changing values saved to file.
reset_all = False

# use latest stable version from 24/1/2023 (version used in Yb-Trieste and Firenze Sr-Tweezers)
old_version = True

# every time after compiling connection table I get strange BrokenPipeError for any print command within FPGA_Tab!?
# sometimes crashes so badly that BLACS cannot be closed anymore and have to manually kill it! this is super annoying.
# implement a save_print command and use everywhere!
def save_print(*args):
    try:
        print(*args)
    except BrokenPipeError:
        pass

#default connection
PRIMARY_IP   = '192.168.1.130'
SECONDARY_IP = '192.168.1.131'
DEFAULT_PORT = '49701'
SOCK_TIMEOUT = 5.0                          # timeout for send_recv_data in seconds. I see sometimes very long responds time. maybe USB-Ethernet-adapter?
SOCK_TIMEOUT_SHORT = 1.0                    # timeout for init_connection in seconds. this is shorter for fast tests withouts boards.

ADD_WORKER  = '_worker'                     # worker name = board name + ADD_WORKER
AO_NAME     = 'Analog Outputs'              # GUI button name analog outputs
DO_NAME     = 'Digital Outputs'             # GUI button name digital outputs
FPGA_NAME   = 'FPGA board'                  # GUI button name FPGA board

#global settings
MAX_FPGA_RATE   = 10e6                      # maximum bus output rate of FPGA in Hz. theoretical limit 30MHz - not tested.
MAX_RACKS       = 2                         # 2 racks can share one clockline
MAX_SHOW        = 20                        # maximum number of samples until which data is shown
ALWAYS_SHOW     = True                      # if true always shows first and last MAX_SHOW/2 data

def epsilon(number):
    """
    returns smallest epsilon for which number + epsilon != number.
    note: sys.float_info.epsilon == epsilon(1.0)
    """
    e = number
    while(number + e != number):
        e /= 2
    return 2*e

# clock resolution and limit calculated from bus_rate for intermediate devices.
# bus_rate is the maximum data output rate in Hz on the bus.
# times are rounded to nearest integer multiple of clock_resolution in quantise_to_pseudoclock in labscript.py.
# time deltas dt are checked vs. dt < 1/clock_line.clock_limit in collect_change_times in labscript.py.
# we add epsilon(MAX_TIME) to clock_limit to avoid that small numberical errors cause problems.
def get_clock_resolution(bus_rate):
    return 1.0 / bus_rate
def get_clock_limit(bus_rate):
    return 1.0 / (1.0 / bus_rate - 2.0 * epsilon(MAX_TIME_SECONDS))
MAX_BUS_RATE     = 1e6
CLOCK_RESOLUTION = get_clock_resolution(MAX_BUS_RATE)
MAX_TIME         = (2**32)-1
MAX_TIME_SECONDS = MAX_TIME*CLOCK_RESOLUTION
CLOCK_LIMIT      = get_clock_limit(MAX_BUS_RATE)
#save_print('FPGA_board: maximum bus rate %.3f MHz gives resolution %.3f ns and max time %.3f s (clock limit = bus rate + %.3f Hz)' % (MAX_BUS_RATE/1e6, CLOCK_RESOLUTION*1e9, MAX_TIME_SECONDS, CLOCK_LIMIT - MAX_BUS_RATE))

# smallest time step and start time in WORD units (ticks)
TIME_STEP       = 1                         # must be 1
START_TIME      = 0                         # note: FPGA board can start at time 0 since trigger delay is corrected.
TIME_ROUND_DECIMALS = 10                    # time is rounded internally by labscript to 10 decimals = 100ps
TIME_PRECISION  = 10.0**(-TIME_ROUND_DECIMALS) # time round precision in seconds
UPDATE_TIME_MS  = 500                       # update time of BLACS board status in ms

#bus data structure
DATA_BITS       = 16
ADDR_BITS       = 7                         # typically 7, but also 8 is possible (if your bus supports)
ADDR_SHIFT      = DATA_BITS                 # first bit of address = number of data bits
MAX_ADDRESS     = ((2**ADDR_BITS)-1)        # largest possible address
ADDR_MASK_SH    = np.array(MAX_ADDRESS<<ADDR_SHIFT,dtype=np.uint32) # address mask (7 or 8 bits)
DATA_MASK       = np.array((2**DATA_BITS)-1, dtype=np.uint32) # data field mask (16 bits)
DATA_ADDR_MASK  = DATA_MASK|ADDR_MASK_SH    # combined data field + address mask (23 or 24 bits)

# default special data bits
# TODO: defined by firmware.
BIT_NOP             = 31                        # no operation bit (at the moment cannot be changed since is hard-coded in driver!)
BIT_TRST            = 30                        # time reset bit (not implemented)
BIT_IRQ             = 29                        # data IRQ bit
BIT_STOP            = 28                        # data stop trigger bit
BIT_STRB            = DATA_BITS+ADDR_BITS       # data strobe bit (typically 23 but could be also 24)
BIT_STRB_GENERATE   = False                     # if True: generate BIT_STRB toggle bit, otherwise not
BIT_NOP_SH          = (1 << BIT_NOP)
BIT_STOP_SH         = (1 << BIT_STOP)
BIT_IRQ_SH          = (1 << BIT_IRQ)
BIT_STRB_SH         = (1 << BIT_STRB)
BIT_STRB_MASK       = ~np.array(BIT_STRB_SH, dtype=np.uint32)
SPECIAL_BITS        = BIT_NOP_SH | BIT_STOP_SH |BIT_IRQ_SH | BIT_STRB_SH

# device types (used for ID)
# TODO: add DDS
TYPE_board      = 0
TYPE_SP         = 1
TYPE_DO         = 2
TYPE_AO         = 3
TYPE_DDS        = 4

def prefix(value, unit=""):
    "returns smallest prefix G,M,k for given integer value"
    s = "%i" % (value)
    for i in range(len(s)):
        if (s[len(s) - i - 1] != '0'):
            #print([value, s, i])
            if i >= 9: return s[:-9] + "G" + unit
            if i >= 6: return s[:-6] + "M" + unit
            if i >= 3: return s[:-3] + "k" + unit
            return s + unit

# TODO: using times*self.bus_rate)+0.5 works if initial time is integer multiple of 1/self.bus_rate.
#      numpy.round() seems to be the better choice. but this needs further testing for different rates!
# delta = data[:, 0] = (np.array(times) * self.bus_rate).round(self.digits).astype(dtype=np.uint32)
def time_to_word(times, bus_rate, digits):
    return (np.array(times) * bus_rate).round(digits).astype(dtype=np.uint32)


def word_to_time(times, bus_rate):
    return np.array(times) / bus_rate

# analog out resolution, true max and min output values and +/-5V reference values
# see Texas Instruments, DAC712 datasheet, rev. July 2009, Table 1, p.13
AO_BITS       = 16              # number of bits
AO_RESOLUTION = 20/(2**AO_BITS) # 0x0001 = 305uV
AO_MAX = 10.0-AO_RESOLUTION     # 0x7fff =  +9.999695V
AO_MIN = -10.0                  # 0x8000 = -10.000000V

if False:
    # this is for DAC712 with 0x0 = 0V. see test_word.
    def V_to_word(volts):
        "convert voltage (scalar or np.array) into low 16 bits of 32bit data word."
        return np.array(np.round((np.clip(volts,AO_MIN,AO_MAX)-AO_MIN)*(2**AO_BITS-1)/(AO_MAX-AO_MIN))-(2**(AO_BITS-1)),dtype=np.uint32) & DATA_MASK

    def word_to_V(word):
        "convert 16bit data word (scalar or np.array) into voltage"
        return np.where(word & 0x8000, np.array(word, dtype=float)-(2**(AO_BITS-1)), (2**(AO_BITS-1)) + np.array(word, dtype=float))*(AO_MAX-AO_MIN)/(2**AO_BITS-1) + AO_MIN
else:
    # this is for other DACs with 0x0 = -10V
    def V_to_word(volts):
        "convert voltage (scalar or np.array) into low 16 bits of 32bit data word."
        return np.array(np.round((np.clip(volts, AO_MIN, AO_MAX) - AO_MIN) * (2 ** AO_BITS - 1) / (AO_MAX - AO_MIN)), dtype=np.uint32) & DATA_MASK

    def word_to_V(word):
        "convert 16bit data word (scalar or np.array) into voltage"
        return np.array(word, dtype=float) * (AO_MAX - AO_MIN) / (2 ** AO_BITS - 1) + AO_MIN

# default analog and digital output properties
# these define the capabilities of the analog outputs after unit conversion, i.e. in the base unit 'V'.
default_ao_props = {'base_unit':'V', 'min':-10.0, 'max':10.0,'step':0.1, 'decimals':4}
default_do_props = {'xcolor':'red'}

# default values are inserted automatically by labscript for times before channel is used
# these values are masked below and are not sent to boards.
# to distinguish between user inserted values and auto-inserted we keep them outside valid range.
SP_INVALID_VALUE = 0 # special output device (virtual)
#AO_INVALID_VALUE = 2*default_ao_props['min']-1.0 # TODO: with unit conversion this might be a valid user-inserted value!? I think nan is not possible here. maybe use np.nan?
AO_INVALID_VALUE = np.finfo(np.float64).min # inserted automatically by labscript
DO_INVALID_VALUE = 2 # inserted automatically by labscript

# DDS address offsets and invalid values
DDS_FREQ_ADDR_OFFSET        = 0
DDS_AMP_ADDR_OFFSET         = 1
DDS_PHASE_ADDR_OFFSET       = 2
DDS_FREQ_INVALID_VALUE      = -1
DDS_AMP_INVALID_VALUE       = -1000
DDS_PHASE_INVALID_VALUE     = -1000

# if True then primary board returns error also when a secondary board is in error state. default = False.
stop_primary_on_secondary_error = False

# runviewer options
runviewer_show_units    = True              # if True show user units in runviewer, otherwise show output in Volts
runviewer_add_start_time= False             # if True adds time START_TIME to data if not given by user. value is last value of last instruction.
runviewer_show_all      = True              # if True show all channels even without data

# tests (use only for testing!)
TEST_TIMING_ERROR       = False             # induce timing error at half of data
TEST_PRIM               = None              # True = primary board, False = secondary board(s), None = all boards

# timeout for interprocess communication wait event
EVT_TIMEOUT     = 5000

# calculation time counter
total_time = None

def make_cmd(command, size):
    "return SERVER_CMD from command and size as bytes array"
    server_cmd = (size & 0x3ff) | ((command & 0x3f) << 10)
    return bytes([server_cmd & 0xff, (server_cmd >> 8) & 0xff])

def get_bytes(server_cmd):
    "returns bytes from server_cmd"
    value = int.from_bytes(server_cmd[0:2],"little")
    return value & 0x3ff

#server commands (2 bytes: [command,size of data in bytes including command])
SERVER_ACK                  = make_cmd(0x01,  2)
SERVER_NACK                 = make_cmd(0x02,  2)
SERVER_RESET                = make_cmd(0x03,  2)
SERVER_OPEN                 = make_cmd(0x20,  2)
SERVER_CLOSE                = make_cmd(0x24,  2)
SERVER_CONFIG               = make_cmd(0x25, 42)
SERVER_WRITE                = make_cmd(0x27,  6)
SERVER_START                = make_cmd(0x28,  6)
SERVER_STOP                 = make_cmd(0x29,  2)
SERVER_STATUS               = make_cmd(0x08,  2)       # polls actual status
SERVER_STATUS_RSP           = make_cmd(0x08, 14)       # response: SERVER_STATUS
SERVER_STATUS_IRQ           = make_cmd(0x09,  2)       # allows to wait for update/end instead of polling
SERVER_STATUS_IRQ_RSP       = make_cmd(0x09, 14)       # response: SERVER_STATUS_IRQ
SERVER_STATUS_FULL          = make_cmd(0x07,  2)       # full status information displayed in board console
if old_version:
    SERVER_STATUS_FULL_RSP_8  = make_cmd(0x07,266)       # response: full status  8 bytes per samples
    SERVER_STATUS_FULL_RSP_12 = make_cmd(0x07,270)       # response: full status 12 bytes per samples
else:
    SERVER_STATUS_FULL_RSP_8  = make_cmd(0x07,274)       # response: full status  8 bytes per samples
    SERVER_STATUS_FULL_RSP_12 = make_cmd(0x07,278)       # response: full status 12 bytes per samples
SERVER_SET_SYNC_PHASE       = make_cmd(0x0c,  6)       # set sync phase. struct client_data32
SERVER_GET_INFO             = make_cmd(0x0d,  2)       # get info
SERVER_GET_INFO_RSP         = make_cmd(0x0d, 10)       # response get info: struct client_data64

# number of bytes per standard server command (should be 2)
SERVER_CMD_NUM_BYTES = struct.calcsize('<2s')

#return packed bytes to configure server (SERVER_CONFIG)
CONFIG_STRUCT_FORMAT = '<2s10I';
CONFIG_NUM_BYTES = struct.calcsize(CONFIG_STRUCT_FORMAT)
def to_config(
        cmd,            # in_out 16bit: must be SERVER_CONFIG
        clock_Hz,       # in_out 32bit: in: external clock frequency in Hz (unused if internal clock used), out: actual used clock frequency in Hz
        scan_Hz,        # in_out 32bit: in: requested scan rate in Hz, out: actual scan rate in Hz
        config,         # in_out 32bit: in: configuration bits for DIO24_IOCTL_SET_CONFIG, out: old configuration bits
        ctrl_trg,       # input  32bit: in: trigger configuration bits, see
        ctrl_out,       # input  32bit: in: output configuration bits, see
        reps,           # input  32bit: number of repetitions. 0=infinite, 1=default.
        trans,          # input  32bit: number of samples
        strb_delay,     # input  32bit: if not 0 strobe delay of both strobe signals
        sync_wait,      # input  32bit: if not SYNC_WAIT_AUTO, wait time in cycles after trigger sent/received
        sync_phase      # input  32bit: if not SYNC_PHASE_AUTO, {ext,det} phase.
        ):
    return struct.pack(CONFIG_STRUCT_FORMAT, cmd, clock_Hz, scan_Hz, config, ctrl_trg, ctrl_out, reps, trans, strb_delay, sync_wait, sync_phase)

#returns unpacked bytes from server into server configuration data (SERVER_CONFIG). for data see to_config.
def from_config(bytes):
    #save_print('unpack', bytes)
    return struct.unpack(CONFIG_STRUCT_FORMAT, bytes)

#return packed bytes with client_data32 structure
def to_client_data32(
        cmd,            # in_out 16bit: command
        data32          # in_out 32bit: data
        ):
    return struct.pack('<2sI', cmd, data32)

#returns unpacked bytes with client_data32 structure from server [cmd, data32]
def from_client_data32(bytes):
    return struct.unpack('<2sI', bytes)
    
#returns unpacked bytes with client_status structure from server:
# 16bit: command, must be SERVER_STATUS_RSP or SERVER_STATUS_IRQ_RSP
# 32bit: FPGA status register bits
# 32bit: board_time
# 32bit: board_samples
def from_client_status(bytes):
    return struct.unpack('<2s3I', bytes)

# inverse of from_client_status
def to_client_status(cmd, board_status, board_time, board_samples):
    return struct.pack('<2s3I', cmd, board_status, board_time, board_samples)

# worker arguments
STR_CONFIG              = 'config'
STR_CONFIG_MANUAL       = 'config_manual'
STR_INPUTS              = 'inputs'
STR_OUTPUTS             = 'outputs'
STR_EXT_CLOCK           = 'ext_clock'
STR_IGNORE_CLOCK_LOSS   = 'ignore_clock_loss'
STR_SYNC_WAIT           = 'sync_wait'
STR_SYNC_PHASE          = 'sync_phase'
STR_CYCLES              = 'num_cycles'
STR_SIMULATE            = 'simulate'
worker_args_keys = [STR_CONFIG, STR_CONFIG_MANUAL, STR_INPUTS, STR_OUTPUTS,
                    STR_EXT_CLOCK, STR_IGNORE_CLOCK_LOSS,
                    STR_SYNC_WAIT, STR_SYNC_PHASE, STR_CYCLES,
                    STR_SIMULATE]

# other
STR_ALLOW_CHANGES       = 'allow_changes'

# messages
MSG_QUESTION                = "?"
MSG_DISABLE                 = " disable"
MSG_ABORTED                 = " aborted!"
MSG_ENABLED                 = " enabled!"
MSG_DISABLED                = " disabled!"
MSG_DONE                    = " done!"
MSG_IGNORE_CLOCK_LOSS       = "board '%s' ignore clock loss"
MSG_SYNC_OUT                = "board '%s' sync out"
MSG_START_TRG               = "board '%s' start trigger"
MSG_STOP_TRG                = "board '%s' stop trigger"
MSG_RESTART_TRG             = "board '%s' restart trigger"
MSG_EXT_CLOCK               = "board '%s' external clock"
MSG_INPUT_SETTING           = "board '%s' input settings 0x%x %s"
MSG_OUTPUT_SETTING          = "board '%s' output settings 0x%x %s"
QUESTION_IGNORE_CLOCK_LOSS  = "Do you really want to ignore clock loss on board '%s'? Attention: the timing between several boards might get out of sync!"
QUESTION_SYNC_OUT           = "Do you really want to disable sync out signal of board '%s'? Attention: secondary boards will not get triggered!"
QUESTION_START_TRG          = "Do you really want to disable external trigger for board '%s'? Attention: the timing between the boards will be undefined!"
QUESTION_EXT_CLOCK          = "Do you really want to disable external clock for board '%s'? Attention: the timing between the boards will be undefined!"

# FPGA control register bits
CTRL_RESET                  = 1<<0           # reset enabled (not settable by user)
CTRL_READY                  = 1<<1           # server ready (not settable by user)
CTRL_RUN                    = 1<<2           # run enabled (not settable by user)
CTRL_RESTART_EN             = 1<<4           # automatic restart
CTRL_AUTO_SYNC_EN           = 1<<5           # auto-sync enabled: enable to detect start trigger with detection clock and sync_delay.
CTRL_AUTO_SYNC_PRIM         = 1<<6           # auto-sync primary board (not used at the moment)
CTRL_AUTO_SYNC_FET          = 1<<7           # auto-sync enable FET = reflect pulse
CTRL_BPS96                  = 1<<8           # data format 0=64bits/sample (default), 1=96bits/sample 
CTRL_BPS96_BRD              = 1<<9           # data+address selection if DIO_CTRL_BPS96=1: 0=2nd 32bit, 1=3rd 32bit (time=1st 32bit)
CTRL_EXT_CLK                = 1<<10          # 0/1=use internal/external clock
CTRL_ERR_LOCK_EN            = 1<<15          # enable error lock lost
CTRL_IRQ_EN                 = 1<<20          # FPGA all irq's enabled
CTRL_IRQ_END_EN             = 1<<21          # FPGA end irq enabled
CTRL_IRQ_RESTART_EN         = 1<<22          # FPGA restart irq enabled
CTRL_IRQ_FREQ_EN            = 1<<23          # FPGA irq with DIO_IRQ_FREQ enabled
CTRL_IRQ_DATA_EN            = 1<<24          # FPGA irq with DIO_BIT_IRQ enabled

# combined control bits
# TODO: have added start trigger here. need a compiler option.
CONFIG_RUN_64               = CTRL_IRQ_EN|CTRL_IRQ_END_EN|CTRL_IRQ_FREQ_EN|CTRL_ERR_LOCK_EN
CONFIG_RUN_RESTART_64       = CONFIG_RUN_64|CTRL_IRQ_RESTART_EN|CTRL_RESTART_EN
CONFIG_RUN_96               = CONFIG_RUN_64|CTRL_BPS96
CONFIG_RUN_RESTART_96       = CONFIG_RUN_RESTART_64|CTRL_BPS96

# FPGA status register bits
STATUS_RESET                = 1<<0           # reset active
STATUS_READY                = 1<<1           # ready state = first data received & not end
STATUS_RUN                  = 1<<2           # running state
STATUS_END                  = 1<<3           # end state = num_samples reached
STATUS_WAIT                 = 1<<4           # wait for restart trigger
STATUS_AUTO_SYNC            = 1<<5           # auto-sync active
STATUS_AS_TIMEOUT           = 1<<6           # auto-sync timeout
STATUS_PS_ACTIVE            = 1<<7           # phase shift active
STATUS_EXT_USED             = 1<<10          # 0/1=internal/external clock is used
STATUS_EXT_LOCKED           = 1<<11          # external clock is locked
STATUS_ERR_TX               = 1<<12          # error TX timeout loading of data
STATUS_ERR_RX               = 1<<13          # error RX not ready
STATUS_ERR_TIME             = 1<<14          # error timing
STATUS_ERR_LOCK             = 1<<15          # error lock lost
STATUS_ERR_TKEEP            = 1<<16          # error tkeep signal
STATUS_ERR_TKEEP2           = 1<<17          # error tkeep signal
STATUS_ERR_TKEEP3           = 1<<18          # error tkeep signal
STATUS_IRQ_FPGA_ERR         = 1<<20          # FPGA error irq
STATUS_IRQ_FPGA_END         = 1<<21          # FPGA end irq
STATUS_IRQ_FPGA_RESTART     = 1<<22          # FPGA restart irq
STATUS_IRQ_FPGA_FREQ        = 1<<23          # FPGA IRQ_FREQ
STATUS_IRQ_FPGA_DATA        = 1<<24          # FPGA IRQ_DATA
STATUS_BTN_0                = 1<<30          # button 0
STATUS_BTN_1                = 1<<31          # button 1

# combined status bits
STATUS_ERROR                = STATUS_ERR_TX|STATUS_ERR_RX|STATUS_ERR_TIME|STATUS_ERR_LOCK|STATUS_ERR_TKEEP|STATUS_ERR_TKEEP2|STATUS_ERR_TKEEP3
STATUS_SECONDARY_READY      = STATUS_READY | STATUS_AUTO_SYNC | STATUS_EXT_USED | STATUS_EXT_LOCKED

# input control register
CTRL_IN_SRC_BITS            = 3
CTRL_IN_LEVEL_BITS          = 2
CTRL_IN_DST_BITS            = (CTRL_IN_SRC_BITS + CTRL_IN_LEVEL_BITS)
CTRL_IN_SRC_MASK            = (1<<CTRL_IN_SRC_BITS)-1;
CTRL_IN_LEVEL_MASK          = (1<<CTRL_IN_LEVEL_BITS)-1;
CTRL_IN_DST_MASK            = (1<<CTRL_IN_DST_BITS)-1;

# input destination offsets
CTRL_IN_DST_START           = 0*CTRL_IN_DST_BITS   # start trigger
CTRL_IN_DST_STOP            = 1*CTRL_IN_DST_BITS   # stop trigger
CTRL_IN_DST_RESTART         = 2*CTRL_IN_DST_BITS   # restart trigger
# TODO: firmware uses parameters given at compile time.
#       these tell the software which bits to generate but no cross-checking is done.
#       either read from firmare directly or allow to modify firmware values (NOP is difficult).
#       BIT_IRQ is also missing here but no space left.
CTRL_IN_DST_DATA_NOP        = 3*CTRL_IN_DST_BITS   # data NOP bit (must be 31)
CTRL_IN_DST_DATA_STRB       = 4*CTRL_IN_DST_BITS   # data strobe bit (default 23)
CTRL_IN_DST_DATA_STOP       = 5*CTRL_IN_DST_BITS   # data STOP bit (default 28)

# input sources
CTRL_IN_SRC_NONE            = 0                     # no trigger input
CTRL_IN_SRC_IN0             = 1                     # ext_in[0]
CTRL_IN_SRC_IN1             = 2                     # ext_in[1]
CTRL_IN_SRC_IN2             = 3                     # ext_in[2]
CTRL_IN_SRC_DATA_20         = 4                     # data bits 20-23
CTRL_IN_SRC_DATA_24         = 5                     # data bits 24-27
CTRL_IN_SRC_DATA_28         = 6                     # data bits 28-31 # TODO: firmware uses only this!
CTRL_IN_SRC_DATA_START      = CTRL_IN_SRC_DATA_20   # first data bit source
CTRL_IN_SRC_IN_ALL          = (1<<CTRL_IN_SRC_NONE)|(1<<CTRL_IN_SRC_IN0)|(1<<CTRL_IN_SRC_IN1)|(1<<CTRL_IN_SRC_IN2)
CTRL_IN_SRC_DATA_ALL        = (1<<CTRL_IN_SRC_NONE)|(1<<CTRL_IN_SRC_DATA_20)|(1<<CTRL_IN_SRC_DATA_24)|(1<<CTRL_IN_SRC_DATA_28)
CTRL_IN_SRC_ALL             = CTRL_IN_SRC_IN_ALL | CTRL_IN_SRC_DATA_ALL

# input levels
CTRL_IN_LEVEL_LOW           = 0                     # level low
CTRL_IN_LEVEL_HIGH          = 1                     # level higth
CTRL_IN_EDGE_FALLING        = 2                     # edge falling
CTRL_IN_EDGE_RISING         = 3                     # edge rising
# data bits offset. in register are same bits as input levels.
# to distinguish the names we add CTRL_IN_DATA_OFFSET which in register is masked out with CTRL_IN_LEVEL_MASK
CTRL_IN_DATA_OFFSET         = (1<<CTRL_IN_LEVEL_BITS)
CTRL_IN_DATA_0              = 0|CTRL_IN_DATA_OFFSET # offset bit 0
CTRL_IN_DATA_1              = 1|CTRL_IN_DATA_OFFSET # offset bit 1
CTRL_IN_DATA_2              = 2|CTRL_IN_DATA_OFFSET # offset bit 2
CTRL_IN_DATA_3              = 3|CTRL_IN_DATA_OFFSET # offset bit 3
CTRL_IN_LVL_IN_ALL          = (1<<CTRL_IN_LEVEL_LOW)|(1<<CTRL_IN_LEVEL_HIGH)|(1<<CTRL_IN_EDGE_FALLING)|(1<<CTRL_IN_EDGE_RISING)
CTRL_IN_LVL_DATA_ALL        = (1<<CTRL_IN_DATA_0)|(1<<CTRL_IN_DATA_1)|(1<<CTRL_IN_DATA_2)|(1<<CTRL_IN_DATA_3)
CTRL_IN_LVL_ALL             = CTRL_IN_LVL_IN_ALL | CTRL_IN_LVL_DATA_ALL

# define inputs list for user to select in GUI. for sources/levels give True for default selection
# source=can be connected to several destinations. dest can be only connected to one source. source can be None, dest not.
# for in_dests values give (start offset, source_enable_bits, level_enable_bits)
# with enable bits = 1 for each enabled source or level option (use 1<<option).
# if nothing enabled destination is not displayed, if only one enabled destination is grayed.
IN_SRC_NONE         = 'None'
STR_TRIG_START      = 'start trigger'
STR_TRIG_STOP       = 'stop trigger'
STR_TRIG_RESTART    = 'restart trigger'
STR_BIT_NOP         = 'NOP bit'
STR_BIT_STRB        = 'STRB bit'
STR_BIT_STOP        = 'STOP bit'
STR_IN_0            = 'input 0'
STR_IN_1            = 'input 1'
STR_IN_2            = 'input 2'
STR_BIT_DATA_20_23  = 'data bits 20-23'
STR_BIT_DATA_24_27  = 'data bits 24-27'
STR_BIT_DATA_28_31  = 'data bits 28-31'
STR_EDGE_RISING     = 'rising edge'
STR_EDGE_FALLING    = 'falling edge'
STR_LEVEL_HIGH      = 'high level'
STR_LEVEL_LOW       = 'low level'
STR_BIT_OFFSET_0    = 'offset bit 0'
STR_BIT_OFFSET_1    = 'offset bit 1'
STR_BIT_OFFSET_2    = 'offset bit 2'
STR_BIT_OFFSET_3    = 'offset bit 3'
in_dests        = {STR_TRIG_START       : (CTRL_IN_DST_START, CTRL_IN_SRC_IN_ALL, CTRL_IN_LVL_IN_ALL),
                   STR_TRIG_STOP        : (CTRL_IN_DST_STOP, CTRL_IN_SRC_ALL, CTRL_IN_LVL_ALL),
                   STR_TRIG_RESTART     : (CTRL_IN_DST_RESTART, CTRL_IN_SRC_IN_ALL, CTRL_IN_LVL_IN_ALL),
                   STR_BIT_NOP          : (CTRL_IN_DST_DATA_NOP, 1<<CTRL_IN_SRC_DATA_28, 1<<CTRL_IN_DATA_3),
                   STR_BIT_STRB         : (CTRL_IN_DST_DATA_STRB, CTRL_IN_SRC_DATA_ALL, CTRL_IN_LVL_DATA_ALL),
                   STR_BIT_STOP         : (CTRL_IN_DST_DATA_STOP, CTRL_IN_SRC_DATA_ALL, CTRL_IN_LVL_DATA_ALL)}
in_sources      = {IN_SRC_NONE          : CTRL_IN_SRC_NONE,
                   STR_IN_0             : CTRL_IN_SRC_IN0,
                   STR_IN_1             : CTRL_IN_SRC_IN1,
                   STR_IN_2             : CTRL_IN_SRC_IN2,
                   STR_BIT_DATA_20_23   : CTRL_IN_SRC_DATA_20,
                   STR_BIT_DATA_24_27   : CTRL_IN_SRC_DATA_24,
                   STR_BIT_DATA_28_31   : CTRL_IN_SRC_DATA_28}
in_levels       = {STR_EDGE_RISING      : CTRL_IN_EDGE_RISING,
                   STR_EDGE_FALLING     : CTRL_IN_EDGE_FALLING,
                   STR_LEVEL_HIGH       : CTRL_IN_LEVEL_HIGH,
                   STR_LEVEL_LOW        : CTRL_IN_LEVEL_LOW,
                   STR_BIT_OFFSET_0     : CTRL_IN_DATA_0,
                   STR_BIT_OFFSET_1     : CTRL_IN_DATA_1,
                   STR_BIT_OFFSET_2     : CTRL_IN_DATA_2,
                   STR_BIT_OFFSET_3     : CTRL_IN_DATA_3}

# primary and secondary board default input settings.
# these settings are added to worker_args for primary and secondary boards.
# TODO: at the moment these bits are hard-coded in firmware. so changing them here does not make sense.
# do not change 'NOP bit' since it is used by driver on board to add 0 data. all data with this bit set is ignored by board.
# 'STRB bit' and 'start trigger' can be overwritten in connection_table, in GUI or in experiment script.
# if 'STRB bit' is set to 'None' output is always generated regardless if strobe bit toggles or not.
# 'STRB bit' might be ignored by firmware. 'STOP bit' and 'IRQ bit' must be enabled for firmware to take into account.
default_in_prim = {STR_BIT_NOP      : (STR_BIT_DATA_28_31, STR_BIT_OFFSET_3),
                   STR_BIT_STRB     : (STR_BIT_DATA_20_23, STR_BIT_OFFSET_3)}
default_in_sec  = {STR_BIT_NOP      : (STR_BIT_DATA_28_31, STR_BIT_OFFSET_3),
                   STR_BIT_STRB     : (STR_BIT_DATA_20_23, STR_BIT_OFFSET_3),
                   STR_TRIG_START   : (STR_IN_0, STR_EDGE_FALLING)}

def get_ctrl_in(input_selection,check=True):
    """
    returns input control register value from input_selection.
    input_selection = {dest:(source, level)),dest:(source, level),...}
    dest = key from in_dests. missing destinations are considered as not used.
    source = key from in_sources.
    level = key from in_levels.
    returns 32bit trigger control register value used to configure board.
    """
    register = np.array([0],dtype=np.uint32)
    for dest, value in input_selection.items():
        source, level = value
        register[0] |= (in_sources[source]|((in_levels[level] & CTRL_IN_LEVEL_MASK)<<CTRL_IN_SRC_BITS))<<in_dests[dest][0]
    if check: # consistency check
        sel = get_in_selection(register[0],return_NONE=False, check=False)
        for key,value in sel.items():
            if (key not in input_selection) or (input_selection[key][0] != value[0]) or (input_selection[key][1] != value[1]):
                if key in input_selection:
                    save_print('input (source, level) =', input_selection[key])
                else:
                    save_print('input key %s not existing' % (key))
                save_print('output (source, level) =', value)
                print('input selection:\n', input_selection, '\n-> value = 0x%x' % (register[0]))
                print('value = 0x%x' % register[0], '\n-> input selection:\n', sel)
                raise LabscriptError("error: get_ctrl_in does not give consistent result with get_in_selection for key '%s'!" %(key))
    #sel = get_in_selection(register[0],return_NONE=False, check=False)
    #print('get_ctrl_in')
    #print(input_selection)
    #print(sel)
    #raise LabscriptError('test')
    return register[0]

def get_in_selection(register, return_NONE=True, check=True):
    """
    returns dictionary with input selections.
    inverse function to get_ctrl_in.
    if return_NONE == True returns also IN_SRC_NONE, otherwise not.
    """
    selection = {}
    for dest, dest_offset in in_dests.items():
        offset, source_enable_bits, level_enable_bits = dest_offset
        reg_dest = (register >> offset) & CTRL_IN_DST_MASK;
        if reg_dest == 0: continue
        reg_src = reg_dest & CTRL_IN_SRC_MASK
        reg_lvl = (reg_dest >> CTRL_IN_SRC_BITS) & CTRL_IN_LEVEL_MASK
        #print(dest, 'dest bits:', reg_dest, 'source bits', reg_src ,'level bits', reg_lvl)
        for src, src_bits in in_sources.items():
            if (source_enable_bits & (1 << src_bits)) != 0: # source enabled
                if return_NONE or (src_bits != CTRL_IN_SRC_NONE):
                    if reg_src == src_bits:
                        #print('source %s (0x%x)' % (src, src_bits))
                        for level, level_bits in in_levels.items():
                            if (level_enable_bits & (1 << level_bits)) != 0:  # level enabled
                                if src_bits >= CTRL_IN_SRC_DATA_START and (level_bits & CTRL_IN_DATA_OFFSET) == 0: continue
                                if reg_lvl == (level_bits & CTRL_IN_LEVEL_MASK):
                                    #print('level %s (0x%x)' % (level, level_bits))
                                    selection[dest] = (src,level)
                                    break
                        if dest not in selection:
                            raise LabscriptError("could not find level for %s! register 0x%x" % (dest, register))
                        break
    if check and (get_ctrl_in(selection) != register): # consistency check
        raise LabscriptError('error: get_in_selection does not give consistent result with get_ctrl_in: %x != %x' %(get_ctrl_in(selection), register), selection)
    return selection

def is_in_start(ctrl_trg):
    "returns True when start trigger is enabled in trigger control register ctrl_trg"
    return (((ctrl_trg >> CTRL_IN_DST_START) & CTRL_IN_SRC_MASK) != CTRL_IN_SRC_NONE)

def is_in_stop(ctrl_trg):
    "returns True when stop trigger is enabled in trigger control register ctrl_trg"
    return (((ctrl_trg >> CTRL_IN_DST_STOP) & CTRL_IN_SRC_MASK) != CTRL_IN_SRC_NONE)

def is_trg_restart(ctrl_trg):
    "returns True when restart trigger is enabled in trigger control register ctrl_trg"
    return (((ctrl_trg >> CTRL_IN_DST_RESTART) & CTRL_IN_SRC_MASK) != CTRL_IN_SRC_NONE)

def get_in_info(ctrl_trg):
    "returns short info string with trigger selections"
    info = []
    if is_in_start(ctrl_trg):    info += ['start']
    if is_in_stop(ctrl_trg):     info += ['stop']
    if is_trg_restart(ctrl_trg): info += ['restart']
    if len(info) > 0: return "(" + "|".join(info) + ")"
    else:             return ""

# output control register
CTRL_OUT_SRC_BITS           = 4
CTRL_OUT_LEVEL_BITS         = 2
CTRL_OUT_DST_BITS           = CTRL_OUT_SRC_BITS + CTRL_OUT_LEVEL_BITS
CTRL_OUT_SRC_MASK           = (1<<CTRL_OUT_SRC_BITS)-1;
CTRL_OUT_LEVEL_MASK         = (1<<CTRL_OUT_LEVEL_BITS)-1;
CTRL_OUT_DST_MASK           = (1<<CTRL_OUT_DST_BITS)-1;

# output destinations offsets
CTRL_OUT_DST_OUT0           = 0*CTRL_OUT_DST_BITS   # ext_out[0]
CTRL_OUT_DST_OUT1           = 1*CTRL_OUT_DST_BITS   # ext_out[1]
CTRL_OUT_DST_OUT2           = 2*CTRL_OUT_DST_BITS   # ext_out[2]
CTRL_OUT_DST_BUS_EN0        = 3*CTRL_OUT_DST_BITS   # out_en[0]
CTRL_OUT_DST_BUS_EN1        = 4*CTRL_OUT_DST_BITS   # out_en[1]

# output sources
CTRL_OUT_SRC_NONE           = 0                 # fixed output at given level
CTRL_OUT_SRC_SYNC_OUT       = 1                 # sync_out
CTRL_OUT_SRC_SYNC_EN        = 2                 # sync_en
CTRL_OUT_SRC_SYNC_MON       = 3                 # sync_mon
CTRL_OUT_SRC_CLK_LOST       = 4                 # clock loss
CTRL_OUT_SRC_ERROR          = 5                 # error
CTRL_OUT_SRC_RUN            = 6                 # run (or wait)
CTRL_OUT_SRC_WAIT           = 7                 # wait (high only when run bit reset)
CTRL_OUT_SRC_READY          = 8                 # ready
CTRL_OUT_SRC_RESTART        = 9                 # restart toggle bit in cycling mode
CTRL_OUT_SRC_TRG_START      = 10                # toggles with start trigger
CTRL_OUT_SRC_TRG_STOP       = 11                # toggles with stop trigger
CTRL_OUT_SRC_TRG_RESTART    = 12                # toggles with restart trigger
CTRL_OUT_SRC_ALL            = (1<<CTRL_OUT_SRC_NONE)|(1<<CTRL_OUT_SRC_SYNC_OUT)|(1<<CTRL_OUT_SRC_SYNC_EN)|(1<<CTRL_OUT_SRC_SYNC_MON)|\
                              (1<<CTRL_OUT_SRC_CLK_LOST)|(1<<CTRL_OUT_SRC_ERROR)|\
                              (1<<CTRL_OUT_SRC_RUN)|(1<<CTRL_OUT_SRC_WAIT)|(1<<CTRL_OUT_SRC_READY)|(1<<CTRL_OUT_SRC_RESTART)|\
                              (1<<CTRL_OUT_SRC_TRG_START)|(1<<CTRL_OUT_SRC_TRG_STOP)|(1<<CTRL_OUT_SRC_TRG_RESTART)

# output levels
CTRL_OUT_LEVEL_LOW          = 0                 # level active low = inverted
CTRL_OUT_LEVEL_HIGH         = 1                 # level active high = normal
CTRL_OUT_LVL_ALL            = (1<<CTRL_OUT_LEVEL_LOW)|(1<<CTRL_OUT_LEVEL_HIGH)

# define output list for user to select in GUI. for sources/levels give True for default selection
# source=can be connected to several destinations. dest can be only connected to one source. source can be None, dest not.
# for out_dests values give (start offset, source_enable_bits, level_enable_bits)
# with enable bits = 1 for each enabled source or level option (use 1<<option).
# if nothing enabled destination is not displayed, if only one enabled destination is grayed.
# TODO: define string constants as for inputs...
OUT_SRC_NONE   = 'fixed'
out_dests   = {   'output 0'        : (CTRL_OUT_DST_OUT0, CTRL_OUT_SRC_ALL, CTRL_OUT_LVL_ALL),
                  'output 1'        : (CTRL_OUT_DST_OUT1, CTRL_OUT_SRC_ALL, CTRL_OUT_LVL_ALL),
                  'output 2'        : (CTRL_OUT_DST_OUT2, CTRL_OUT_SRC_ALL, CTRL_OUT_LVL_ALL),
                  'bus enable 0'    : (CTRL_OUT_DST_BUS_EN0, CTRL_OUT_SRC_ALL, CTRL_OUT_LVL_ALL),
                  'bus enable 1'    : (CTRL_OUT_DST_BUS_EN1, CTRL_OUT_SRC_ALL, CTRL_OUT_LVL_ALL)}
out_sources = {   OUT_SRC_NONE      : CTRL_OUT_SRC_NONE,
                  'sync out'        : CTRL_OUT_SRC_SYNC_OUT,
                  'sync en'         : CTRL_OUT_SRC_SYNC_EN,
                  'sync mon'        : CTRL_OUT_SRC_SYNC_MON,
                  'clock lost'      : CTRL_OUT_SRC_CLK_LOST,
                  'error'           : CTRL_OUT_SRC_ERROR,
                  'run'             : CTRL_OUT_SRC_RUN,
                  'wait'            : CTRL_OUT_SRC_WAIT,
                  'ready'           : CTRL_OUT_SRC_READY,
                  'restart'         : CTRL_OUT_SRC_RESTART,
                  'trig. start'     : CTRL_OUT_SRC_TRG_START,
                  'trig. stop'      : CTRL_OUT_SRC_TRG_STOP,
                  'trig. restart'   : CTRL_OUT_SRC_TRG_RESTART,
                  }
out_levels  = {   STR_LEVEL_LOW     : CTRL_OUT_LEVEL_LOW,
                  STR_LEVEL_HIGH    : CTRL_OUT_LEVEL_HIGH}

# primary and secondary board default output settings
# these settings are added to worker_args for primary and secondary boards.
# all settings here can be overwritten in connection_table, in GUI or in experiment script.
default_out_prim = {'output 0':('sync out',STR_LEVEL_HIGH)}
default_out_sec  = {}

def get_ctrl_out(output_selection):
    """
    returns output control register value from output_selection.
    output_selection = dictionary key = output and value = (source,level) with
    output = key from out_dests. missing outputs are considered as not used.
    source = key from out_sources.
    level = key from out_levels.
    returns 32bit output control register value used to configure board.
    """
    register = np.array([0],dtype=np.uint32)
    for dest, value in output_selection.items():
        source, level = value
        register[0] |= (out_sources[source]|(out_levels[level]<<CTRL_OUT_SRC_BITS))<<out_dests[dest][0]
    return register[0]

def get_out_selection(register, return_NONE=True):
    """
    returns dictionary with output selections.
    inverse function to get_ctrl_out.
    if return_NONE == True returns also OUT_SRC_NONE, otherwise not.
    """
    selection = {}
    for dest, dest_offset in out_dests.items():
        reg_dest = (register >> dest_offset[0]) & CTRL_OUT_DST_MASK;
        for src, src_bits in out_sources.items():
            if return_NONE or (src_bits != CTRL_OUT_SRC_NONE):
                if (reg_dest & CTRL_OUT_SRC_MASK) == src_bits:
                    for level, level_bits in out_levels.items():
                        if ((reg_dest >> CTRL_OUT_SRC_BITS) & CTRL_OUT_LEVEL_MASK) == level_bits:
                            selection[dest] = (src,level)
                            break
                    break
    if get_ctrl_out(selection) != register: # consistency check
        save_print('error: get_out_selection does not give consistent result with get_ctrl_out: %x != %x' %(get_ctrl_out(selection), register), selection)
        exit()
    return selection

def is_sync_out(ctrl_out):
    "returns True when sync_out is enabled in output control register ctrl_out"
    for dest, dest_offset in out_dests.items():
        if (((ctrl_out >> dest_offset[0]) & CTRL_OUT_SRC_MASK) == CTRL_OUT_SRC_SYNC_OUT): return True
    return False

def get_out_info(ctrl_out):
    "returns short info string with output selections"
    info = []
    if is_sync_out(ctrl_out):   info += ['sync out']
    if len(info) > 0: return "(" + "|".join(info) + ")"
    else:             return ""

# TODO: maybe merge with parse_worker_args
def check_worker_args(worker_args):
    "checks if valid worder_args are given"
    for key,value in worker_args.items():
        if key not in worker_args_keys:
            raise LabscriptError("worker_arg '%s' is not allowed!" % (key))
        if (key == STR_CONFIG) or (key == STR_CONFIG_MANUAL):
            if not isinstance(value, integer):
                raise LabscriptError("worker_arg '%s':'%s' must be an integer! but is %s" % (key, str(value), type(value)))
            if (value & CTRL_USER_MASK) != 0:
                raise LabscriptError("worker_arg '%s':0x%x is invalid!" % (key, value))
        elif key == STR_INPUTS:
            if isinstance(value, dict):
                ctrl_in = get_ctrl_in(value)
            else:
                selection = get_in_selection(value, return_NONE=False)
        elif key == STR_OUTPUTS:
            if isinstance(value, dict):
                ctrl_out = get_ctrl_out(value)
            else:
                selection = get_out_selection(value, return_NONE=False)
        elif (key == STR_EXT_CLOCK) or (key == STR_IGNORE_CLOCK_LOSS) or (key == STR_SIMULATE):
            if not isinstance(value, bool):
                raise LabscriptError("worker_arg '%s':'%s' must be True/False (bool)! but is %s" % (key, str(value), type(value)))
        elif (key == STR_SYNC_WAIT) or (key == STR_SYNC_PHASE) or (key == STR_CYCLES):
            if not isinstance(value, integer):
                raise LabscriptError("worker_arg '%s':'%s' must be an integer! but is %s" % (key, str(value), type(value)))
        else:
            raise LabscriptError("error worker_arg '%s'!" % (key))

# configuration bits
CONFIG_CLOCK        = 100e6                 # 100MHz, not used at the moment
CONFIG_SCAN         = 1e6                   # 1MHz, requested sampling rate. overwritten by FPGA_board.bus_rate
CONFIG_CYCLES       = 1                     # cycles=repetitions, 0=infite, 1=default. needs CTRL_RESTART_EN bit to enable cycling mode.
CONFIG_TRANS        = 0                     # number of samples but can be given later.

# strobe delay bits
STRB_DELAY_AUTO     = 0                     # strobe delay. 0=use from config.server file
STRB_DELAY_DEFAULT  = 0x451e451e            # default strobe delay for 300:400:300 ns at 1MHz bus output frequency
STRB_DELAY          = STRB_DELAY_AUTO       # strobe delay. STRB_DELAY_AUTO = use from config.server file

# primary board sync wait time
SYNC_WAIT_BITS      = 10                    # bits used for sync_wait
SYNC_WAIT_MASK      = (1<<SYNC_WAIT_BITS)-1 # bit mask for sync_wait
SYNC_WAIT_AUTO      = 0xffffffff            # sync delay in cycles. 0xffffffff = take from config.server file
SYNC_WAIT_PRIM      = 22  & SYNC_WAIT_MASK   # sync delay in cycles for primary board. SYNC_WAIT_AUTO = take from config.server file
SYNC_WAIT_SEC       = 0  & SYNC_WAIT_MASK   # sync delay in cycles for secondary boards. SYNC_WAIT_AUTO = take from config.server file
SYNC_WAIT_SINGLE    = 0  & SYNC_WAIT_MASK   # sync delay in cycles for single-board experiment. SYNC_WAIT_AUTO = take from config.server file

# secondary boards external and detection clock phase bits
PHASE_360           = 560                   # phase steps for 360 degree at 100MHz clock
SYNC_PHASE_BITS     = 12                    # number of bits per phase
SYNC_PHASE_MASK     = (1<<SYNC_PHASE_BITS)-1 # phase mask
SYNC_PHASE_AUTO     = 0xffffffff            # use phase from server.config file
SYNC_PHASE_NONE     = 0                     # 0 phase
SEC_PHASE_EXT       = int((290*PHASE_360)//360) & SYNC_PHASE_MASK # secondary board external clock phase in steps
SEC_PHASE_DET       = int(( 90*PHASE_360)//360) & SYNC_PHASE_MASK # secondary board detection clock phase in steps
SYNC_PHASE_SEC      = (SEC_PHASE_EXT << SYNC_PHASE_BITS) | SEC_PHASE_DET # secondary board {fi_ext,fi_det} clock phase

# stop options
STOP_NOW            = 0                     # abort any output
STOP_AT_END         = 1                     # stop at end of cycle (not implemented)

# FPGA_status definition
# unpacks and save_prints full status information received from server
# unpack info contains tuples of (repetition, struct type)
FPGA_STATUS_NUM_DEBUG       = 20
if old_version:
    FPGA_status_unpack_info_8   = [(25,'I'),(6,'B'),(2,'s'),(3,'i'),(16,'I'),(FPGA_STATUS_NUM_DEBUG,'I')] # (2,'s')
    FPGA_status_unpack_info_12  = [(25,'I'),(6,'B'),(2,'s'),(3,'i'),(17,'I'),(FPGA_STATUS_NUM_DEBUG,'I')]
else:
    FPGA_status_unpack_info_8   = [(27,'I'),(6,'B'),(2,'s'),(3,'i'),(16,'I'),(FPGA_STATUS_NUM_DEBUG,'I')] # (2,'s')
    FPGA_status_unpack_info_12  = [(27,'I'),(6,'B'),(2,'s'),(3,'i'),(17,'I'),(FPGA_STATUS_NUM_DEBUG,'I')]
FPGA_STATUS_OK              = 0
FPGA_STATUS_ENOINIT         = -1
FPGA_STATUS_EINCONST        = -10
FPGA_STATUS_ENUMBYTES       = -20
FPGA_STATUS_ERSP            = -30
FPGA_STATUS_EBPS            = -40
FPGA_STATUS_ENUMI32         = -50
FPGA_STATUS_EDUMMY          = -60
FPGA_status_format_8 = FPGA_status_format_12 = '<2s'
for i in FPGA_status_unpack_info_8 : FPGA_status_format_8  += '%i%s' % i[0:2]
for i in FPGA_status_unpack_info_12: FPGA_status_format_12 += '%i%s' % i[0:2]
FPGA_STATUS_NUM_BYTES_8     = struct.calcsize(FPGA_status_format_8)
FPGA_STATUS_NUM_BYTES_12    = struct.calcsize(FPGA_status_format_12)
class FPGA_status:
    error = FPGA_STATUS_ENOINIT        # error code. FPGA_STATUS_OK = ok

    def __init__(self, bytes):
        # extract FPGA_status from bytes sent from server
        # note: assigning result of struct.unpack to a single variable saves everything as bytes and not int!?
        if (get_bytes(SERVER_STATUS_FULL_RSP_8) != FPGA_STATUS_NUM_BYTES_8) or (get_bytes(SERVER_STATUS_FULL_RSP_12) != FPGA_STATUS_NUM_BYTES_12):
            save_print('FPGA_status inconsistency: %i != %i or %i != %i' % (get_bytes(SERVER_STATUS_FULL_RSP_8),FPGA_STATUS_NUM_BYTES_8,get_bytes(SERVER_STATUS_FULL_RSP_12),FPGA_STATUS_NUM_BYTES_12))
            self.error = FPGA_STATUS_EINCONST
            return
        if len(bytes) == FPGA_STATUS_NUM_BYTES_8:
            self.bytes_per_sample = 8
            cmd = SERVER_STATUS_FULL_RSP_8
            info = FPGA_status_unpack_info_8
            format = FPGA_status_format_8
        elif len(bytes) == FPGA_STATUS_NUM_BYTES_12:
            self.bytes_per_sample = 12
            cmd = SERVER_STATUS_FULL_RSP_12
            info = FPGA_status_unpack_info_12
            format = FPGA_status_format_12
        else:
            save_print('FPGA_status recieved %i bytes but must be either %i or %i' % (len(bytes), FPGA_STATUS_NUM_BYTES_8, FPGA_STATUS_NUM_BYTES_12))
            self.error = FPGA_STATUS_ENUMBYTES
            return
        self.cmd, *data = struct.unpack(format, bytes)
        if self.cmd != cmd:
            self.error = FPGA_STATUS_ERSP
            return
        i = 0
        self.ctrl_FPGA          = data[i]; i += 1;
        self.ctrl_in            = data[i]; i += 1;
        self.ctrl_out           = data[i]; i += 1;
        self.set_samples        = data[i]; i += 1;
        if not old_version:
            self.set_cycles     = data[i]; i += 1;
        self.clk_div            = data[i]; i += 1;
        self.strb_delay         = data[i]; i += 1;
        self.sync_delay         = data[i]; i += 1;
        self.sync_phase         = data[i]; i += 1;
        self.status             = data[i]; i += 1;
        self.board_time         = data[i]; i += 1;
        self.board_samples      = data[i]; i += 1;
        self.board_time_ext     = data[i]; i += 1;
        self.board_samples_ext  = data[i]; i += 1;
        if not old_version:
            self.board_cycles   = data[i]; i += 1;
        self.sync_time          = data[i]; i += 1;
        self.version            = data[i]; i += 1;
        self.info               = data[i]; i += 1;
        self.FPGA_temp          = data[i]; i += 1;
        self.phase_ext          = data[i]; i += 1;
        self.phase_det          = data[i]; i += 1;
        self.period_in          = data[i]; i += 1;
        self.period_out         = data[i]; i += 1;
        self.period_bus         = data[i]; i += 1;
        self.ctrl_DMA           = data[i]; i += 1;
        self.status_TX          = data[i]; i += 1;
        self.status_RX          = data[i]; i += 1;
        self.dsc_TX_p           = data[i]; i += 1;
        self.dsc_TX_a           = data[i]; i += 1;
        self.dsc_TX_c           = data[i]; i += 1;
        self.dsc_RX_p           = data[i]; i += 1;
        self.dsc_RX_a           = data[i]; i += 1;
        self.dsc_RX_c           = data[i]; i += 1;
        dummy                   = data[i]; i += 1;      # dummy 2 bytes
        self.err_TX             = data[i]; i += 1;
        self.err_RX             = data[i]; i += 1;
        self.err_FPGA           = data[i]; i += 1;
        self.irq_TX             = data[i]; i += 1;
        self.irq_RX             = data[i]; i += 1;
        self.irq_FPGA           = data[i]; i += 1;
        self.irq_num            = data[i]; i += 1;
        self.TX_bt_tot          = data[i]; i += 1;
        self.RX_bt_tot          = data[i]; i += 1;
        self.bt_tot             = data[i]; i += 1;
        self.RD_bt_max          = data[i]; i += 1;
        self.RD_bt_act          = data[i]; i += 1;
        self.RD_bt_drop         = data[i]; i += 1;
        self.reps_set           = data[i]; i += 1;
        self.reps_act           = data[i]; i += 1;
        self.timeout            = data[i]; i += 1;
        if self.bytes_per_sample == 8:  self.last_sample = data[i:i+2]; i += 2; # [time, data]
        else:                           self.last_sample = data[i:i+3]; i += 3; # [time, data rack 0, data rack 1]
        self.debug_count        = data[i]; i += 1;
        self.debug              = data[i:i+FPGA_STATUS_NUM_DEBUG]; i += FPGA_STATUS_NUM_DEBUG;
        # check number of integers
        num_int = sum([i[0] if i[1] != 's' else 1 for i in info])
        if (i != num_int): # check consistent number of uint32_t
            self.error = FPGA_STATUS_ENUMI32
            return
        # check bytes per sample
        bytes_per_sample = 8 if ((self.ctrl_FPGA & CTRL_BPS96) == 0) else 12
        if (self.bytes_per_sample != bytes_per_sample): # check consistent bytes per sample
            self.error = FPGA_STATUS_EBPS
            return
        # check dummy
        if dummy != b'\x00\x00':
            save_print('2 dummy bytes should be 0 but is',dummy)
            self.error = FPGA_STATUS_EDUMMY
            return
        # status string
        if   self.status & STATUS_RUN:   self.FPGA_status_str = "running"
        elif self.status & STATUS_ERROR: self.FPGA_status_str = "error"
        elif self.status & STATUS_END:   self.FPGA_status_str = "end"
        else:                            self.FPGA_status_str = "stopped"
        # check correct number of TX and RX bytes
        self.TX_RX_bytes_ok = "ok" if (self.TX_bt_tot == self.RX_bt_tot) and (self.TX_bt_tot == self.bt_tot) else "error"
        # board temperature
        self.FPGA_temp = (((self.FPGA_temp >> 4) * 503975) / 4096 - 273150)
        if (self.FPGA_temp < 10): self.FPGA_temp = 0    # TODO: first sample is always wrong?
        # no error:
        self.error = FPGA_STATUS_OK

    def show(self):
        # save_print status info in console
        save_print("DMA & FPGA status:")
        save_print("                    TX       RX     FPGA")
        save_print("ctrl       0x        - %8x %08x" % (self.ctrl_DMA, self.ctrl_FPGA))
        save_print("in/out     0x        - %08x %08x" % (self.ctrl_in, self.ctrl_out))
        save_print("in/out/bus ps %8u %8u %8u" % (self.period_in, self.period_out, self.period_bus))
        save_print("strb/clk   0x        - %8x %8x" % (self.strb_delay, self.clk_div))
        save_print("sync w/ph  0x        - %8x %8x" % (self.sync_delay, self.sync_phase))
        save_print("status     0x %8x %8x %8x (%s)" % (self.status_TX, self.status_RX, self.status, self.FPGA_status_str))
        save_print("board #/t            - %8u %8d us" % (self.board_samples, self.board_time))
        save_print("board #/t (ext)      - %8u %8d us" % ( self.board_samples_ext, self.board_time_ext))
        if not old_version:
            save_print("board #/cyc          - %8d %8d" % ( self.board_cycles, self.set_cycles))
        save_print("sync time  0x        -        - %8x" % (self.sync_time))
        save_print("temperature          -        - %4d.%03u deg.C" % (self.FPGA_temp / 1000, self.FPGA_temp % 1000))
        save_print("phase ext/det        - %8d %8d steps" % (self.phase_ext, self.phase_det))
        save_print("error         %8d %8d %8d" % (self.err_TX, self.err_RX, self.err_FPGA))
        save_print("IRQ's         %8u %8u %8u" % (self.irq_TX, self.irq_RX, self.irq_FPGA))
        save_print("IRQ's mrg     %8u" % (self.irq_num))
        save_print("trans bytes   %8u %8u %8u (%s)" % (self.TX_bt_tot, self.RX_bt_tot, self.bt_tot, self.TX_RX_bytes_ok))
        save_print("TX p/a/c      %8u %8u %8u" % (self.dsc_TX_p, self.dsc_TX_a, self.dsc_TX_c))
        save_print("RX p/a/c      %8u %8u %8u" % (self.dsc_RX_p, self.dsc_RX_a, self.dsc_RX_c))
        save_print("rd m/a/d      %8u %8u %8u" % (self.RD_bt_max, self.RD_bt_act, self.RD_bt_drop))
        save_print("reps/act      %8u %8u" % (self.reps_set, self.reps_act))
        save_print("timeout       %8u" % (self.timeout))
        if self.bytes_per_sample == 8:
            save_print("RX last    0x %08x %08x        - (%u us)" % (self.last_sample[0], self.last_sample[1], self.last_sample[0]))
        elif self.bytes_per_sample == 12:
            save_print("RX last    0x %08x %08x %08x (%u us)" % (self.last_sample[0], self.last_sample[1], self.last_sample[2], self.last_sample[0]))
        save_print("byte/samples  %8u        - %8u (mult. of 4)" % (self.bytes_per_sample, self.set_samples))
        save_print("version    0x        -        - %08x (%s)" % (self.version, self.get_version()))
        save_print("info       0x        -        - %08x (%s)" % (self.info, self.get_info()))
        # debug bytes we do not display

    def get_version(self):
        major = (self.version >> 24) & 0xff
        minor = (self.version >> 16) & 0xff
        year  = 2000 + ((self.version >> 9)  & 0x7f)
        month = (self.version >> 5) & 0x0f
        day   = (self.version     ) & 0x1f
        return 'v%02i.%02i-%04i/%02i/%02i' % (major, minor, year, month, day)

    def get_info(self):
        board = self.info & 0xff
        if   board == 0xc0: return 'Cora-Z7-07S'
        elif board == 0xc1: return 'Cora-Z7-10'
        elif board == 0xa1: return 'Arty-Z7-10'
        elif board == 0xa2: return 'Arty-Z7-20'
        else: return ''

def get_board_samples(samples, last_time):
    """
    returns the expected board [samples, time] from sent number of samples and last time.
    the board is appending NOP samples in order to have always multiple of 4 samples.
    this changes the board_samples and the board_time.
    note: the reason is that the FIFO buffer have a fixed data width of 2^7 = 128bits = 16 bytes.
          for  8 bytes/sample this gives 2 experiment samples/FIFO sample
          for 12 bytes/sample this gives 4 experiment samples/3 FIFO samples
          the experimental samples are extracted from the FIFO samples by the onboard hardware,
          where a mask for invalid bytes could be set. but the driver would need to set this mask.
          if the total number of samples is a multiple of 2 or 4 samples, there will be never invalid bytes.
          so, for simplicity, the driver is always generating multiple of 4 samples where added samples have the NOP bit set,
          and the hardware is disregarding data whith the NOP bit set. the time has to be still incrementing for this data.
    """
    if (samples % 4) == 0: add = 0
    else:                  add = 4 - (samples % 4)
    return [samples + add, last_time + add]

def to_string(d, level=0):
    """
    creates string from a python object to be used to save as dataset for hdf5 file.
    allowed objects are dict, list, string, integer, float.
    inverse function of dict_from_string(d).
    the recursive call makes the function very simple but maybe not very efficient.
    """
    data = ""
    if isinstance(d, dict):
        data += "%%D%i#%i["%(level, len(d)*2)
        for key, value in d.items():
            data += "%s%s"%(to_string(key,level+1),to_string(value,level+1))
        data += "]%i;"%level
    elif isinstance(d, list):
        data += "%%L%i#%i["%(level, len(d))
        for di in d:
            data += "%s" % (to_string(di, level+1))
        data += "]%i;" % (level)
    elif isinstance(d, tuple):
        data += "%%T%i#%i[" % (level, len(d))
        for di in d:
            data += "%s" % (to_string(di, level + 1))
        data += "]%i;" % (level)
    elif isinstance(d, str):
        data += "%%s=%s;"%(d)
    elif isinstance(d, (int,np.uint32,np.uint64,np.int32,np.int64)):
        data += "%%i=%i;"%(d)
    elif isinstance(d, (float,np.float32,np.float64)):
        data += "%%f=%f;"%(d)
    elif d is None: # note: isinstance does not work with type(None) = NoneType!?
        data += "%NN;"
    else:
        save_print(d)
        raise LabscriptError('to_string:',d,'has unknown data type', type(d))
        exit()
    return data

def findall(s, sub):
    "generator to find indices of all non-overlapping sub in s"
    i = s.find(sub)
    while i != -1:
        yield i
        i = s.find(sub, i + len(sub))

def list_from_string(data, level):
    "helper function for from_string. returns list of python objects from data string"
    #print('list level', level, 'data =', data)
    num = 3 + data[3:].find("#")
    next  = [i for i in findall(data, ";")]
    start = [i for i in findall(data, "[")]
    end   = [i for i in findall(data, "]")]
    if (num < 0) or (len(next) == 0) or (len(start)==0) or (len(start) != len(end)) or (end[-1] > len(data)-3):
        print([num,len(next),len(start),len(end),end[-1],len(data)])
        raise LabscriptError("from_string: '%s' invalid! (L0)" % (data))
    if (int(data[2:num]) != (level-1)) or (int(data[end[-1]+1:end[-1]+num-1]) != (level-1)):
        raise LabscriptError("from_string: '%s' invalid! (L1)" % (data))
    num = int(data[num+1:start[0]]) # number of items in list
    # get indices of entries on on actual level
    assign = np.array([0 for _ in next] + [1 for _ in start] + [-1 for _ in end])
    index = np.array([i for i in next] + [i for i in start] + [i for i in end])
    sort = np.argsort(index)
    assign = assign[sort]
    index = index[sort]
    cumsum = np.cumsum(assign)
    mask = (cumsum == 1) & (assign == 0)
    index = index[mask]
    if (len(index) != num):
        raise LabscriptError("from_string: '%s' invalid! (L2)" % (data))
    start = start[0] + 1
    d = [None for _ in range(num)]
    for j,i in enumerate(index):
        d[j] = from_string(data[start:i+1], level)
        start = i + 1
    #print('list level', level, 'result =', d)
    return d

def from_string(data, level=0):
    """
    inverse function of to_string. returns reconstructed object. for details see there.
    """
    d = None

    #print('level', level, 'data = ', data)

    if isinstance(data, bytes):
        data = data.decode('utf-8')

    # data must contain single object starting wtih "%" and ending with ";"
    if (len(data) <= 3) or (data[0] != "%") or (data[-1] != ";"):
        print(data)
        print(data[0])
        print(data[-1])
        raise LabscriptError("from_string: '%s' invalid! (0)" % (data))

    if data[1] == "D": # dictionary
        d = {}
        l = list_from_string(data, level+1)
        if len(l) & 1 == 1:
            raise LabscriptError("from_string: '%s' invalid! (1)" % (data))
        for i in range(0,len(l),2):
            d[l[i]] = l[i+1]
        return d
    elif data[1] == "T": # tuple
        return tuple(list_from_string(data, level+1))
    elif data[1] == "L": # list
        return list_from_string(data, level+1)
    elif (data[1] == "s") and (data[2] == "="): # string
        return data[3:-1]
    elif (data[1] == "i") and (data[2] == "="): # integer
        return int(data[3:-1])
    elif (data[1] == "f") and (data[2] == "="): # float
        return float(data[3:-1])
    elif (data[1] == "N") and (data[2]=='N') and (len(data) == 4):  # None
        return None
    else: # unknown
        raise LabscriptError("from_string: '%s' invalid! (2)" % (data))

# PseudoClock
# accepts only ClockLine as childs
class FPGA_PseudoClock(Pseudoclock):
    # TODO: TriggerableDevice needs to be defined here otherwise get an error in start() which calls labscript.py trigger() line 949.
    #       the name of the dictionary is however __trigger but somehow it needs the '_TriggerableDevice' before? very obscure.
    #       To fix this I think one needs to declare a digital output as the "trigger", but I do not know how.
    #       For secondary boards, I do not need a TTL output for triggering since the primary board triggers it internally.
    #       However, for the Moglabs QRF device one would need a trigger TTL associated in some way?
    _TriggerableDevice__triggers = []

    def add_device(self, device):
        if isinstance(device, ClockLine):
            save_print("%s: adding ClockLine '%s'" % (self.name, device.name))
            parent = device.parent_device.name
            Pseudoclock.add_device(self, device)
        else:
            raise LabscriptError('%s allows only ClockLine child but you have connected %s (class %s).'%(self.name, device.name, device.__class__))

def parse_num(num):
    "parse string into integer number. string can be prefixed with '0x' for hex number"
    #TODO: which exceptions can int() raise?
    if isinstance(num, str):
        if len(num) > 2:
            if (num[0]=='0') and (num[1]=='x'): # hex number
                return int(num[2:],16)
            else: return int(num)
        else: return int(num)
    else:
        return num # assume is already a number

def time_to_str(time):
    #convert time (float) in seconds into easily readable string
    if time < 1e-12: return '0s'
    elif time < 1e-6: return ('%.3fns' % (time*1e9))
    elif time < 1e-3: return ('%.3fus' % (time*1e6))
    elif time < 1.0: return ('%.6fms' % (time*1e3))
    else: return ('%.6fs' % time)

#basic checking when adding new devices to one of the IntermediateDevice below
#returns decimal numbers [rack,address,channel] of device or raises LabscriptError on error
def check_device(device, allowed_type, max_channels, device_list, shared_address):
    #check device type
    if not isinstance(device, allowed_type):
        raise LabscriptError("device '%s', type %s must be of type %s" % (device.name, str(type(device)), str(allowed_type)))
    # rack is always given by parent device
    rack = device.parent_device.rack
    #get address or channel
    if shared_address: # get rack & address from parent. channel defines data bits.
        address = device.parent_device.address
        channel = parse_num(device.connection)
    else: # each channel has its own rack/address. channel not needed (maybe in GUI).
        address = parse_num(device.connection)
        channel = len(device_list)
    #check valid rack number
    if (rack < 0) or (rack >= MAX_RACKS):
        save_print([rack,MAX_RACKS, rack < 0, rack >= MAX_RACKS])
        LabscriptError("For device '%s' rack number %i given but only 0..%i allowed!"%(device.name, rack, MAX_RACKS-1))
    #check maximum number of channels
    if len(device_list) >= max_channels:
        raise LabscriptError("You tried to add device '%s' to '%s' but which has already %i channels." % (device.name, device.parent_device.name, max_channels))
    #check valid channel number
    if (channel<0) or (channel >= max_channels):
        raise LabscriptError("Device '%s' channel number %i must be 0..%i." % (device.name, channel, max_channels-1))
    #ensure rack/address/channel is unique
    board = device.parent_device.parent_device.parent_device.parent_device
    if not isinstance(board, FPGA_board): # sanity check
        raise LabscriptError("'%s' is expected FPGA_board but is '%s'?" % (board.name, board.__class__))
    for pseudoclock in board.child_devices:
        for clockline in pseudoclock.child_devices:
            for IM in clockline.child_devices: # intermediate devices
                #save_print('check IM',IM.name)
                # skip QRF since is not a device in a rack!
                # note: do not use isinstance since this requires to import MOGLabs_QRF which can lead to a circular reference causing import to fail!
                if isinstance(IM, (DigitalChannels, AnalogChannels)):
                    for dev in IM.child_devices: # note: device is not yet in list of childs.
                        if (dev.rack == rack) and (dev.address == address) and (dev.channel == channel):
                            raise LabscriptError("device '%s' rack/address/channel %i/%i/%i is already used by '%s'" % (device.name, rack, address, channel, dev.name))
    #return [rack,address,channel] of new device
    return [rack,address,channel]

# internal special output device
# one created for each rack
# allows to insert time with special data bits for each rack
class SpecialOut(Output):
    address = None # has no address
    channel = None # channel = rack
    type    = TYPE_SP
    default_value = SP_INVALID_VALUE
    dtype   = np.uint32

    def __init__(self, name, parent_device, connection, rack, **kwargs):
        Output.__init__(self, name, parent_device, connection, **kwargs)
        self.rack = rack

# internal special Intermediate Device
# needed for SpecialOut devices created one per rack
# TODO: maybe can be replaced with markers?
class SpecialIM(IntermediateDevice):
    description = 'internal device for special data'
    allowed_children = [SpecialOut]
    shared_address = False

    def __init__(self, name, parent_device, bus_rate, **kwargs):
        #parent device must be FPGA_board. you should not connect it directly to clockline.
        if not isinstance(parent_device, FPGA_board):
            raise LabscriptError("Device '%s' parent class is '%s' but must be '%s'!" % (self.name, parent_device.__class__, FPGA_board))
        # get clockline from FPGA_board and set as parent
        self.parent_device = parent_device.get_clockline(self, bus_rate)
        # init device with clockline as parent
        IntermediateDevice.__init__(self, name, self.parent_device, **kwargs)

    def add_device(self, device):
        if isinstance(device, SpecialOut):
            IntermediateDevice.add_device(self, device)
        else:
            raise LabscriptError("'%s' must be SpecialOut but is '%s'!" % (device.name, device.__class__))

    # define conversion function from raw data to data word.
    # will be called by generate_code for each DigitalOut device.
    def to_word(self, channel):
        "return data word for this channel"
        return np.array(np.where(channel.raw_output == channel.default_value, 0,
                                 channel.raw_output),
                        dtype=np.uint32)

# IntermediateDevice with digital output channels
# channel numbers must be unique. all channels have the parent address (called 'connect' for consistency)
class DigitalChannels(IntermediateDevice):
    description = 'digital output device with several channels'
    allowed_children = [DigitalOut]
    shared_address = True
    #clock_limit = CLOCK_LIMIT
    #num_racks = 0 # set to maximum allowed number of racks given by FPGA_board

    def __init__(self, name, parent_device, connection, rack, max_channels, bus_rate=MAX_BUS_RATE, **kwargs):
        #parent device must be FPGA_board. you should not connect it directly to clockline.
        if not isinstance(parent_device, FPGA_board):
            raise LabscriptError("Device '%s' parent class is '%s' but must be '%s'!" % (name, parent_device.__class__, FPGA_board))
        # get clockline from FPGA_board and set as parent
        self.parent_device = parent_device.get_clockline(self, bus_rate)
        # init device with clockline as parent
        IntermediateDevice.__init__(self, name, self.parent_device, **kwargs)

        # set clock limit and resolution
        self.clock_limit      = get_clock_limit(bus_rate)
        self.clock_resolution = get_clock_resolution(bus_rate)

        self.num_racks = parent_device.num_racks
        self.max_channels = max_channels
        self.rack = rack

        # digital channels share the same address. therefore, channels on the same intermediate device can change simultaneously.
        self.address = parse_num(connection)
        if (self.rack < 0) or (self.rack >= self.num_racks):
            raise LabscriptError("For device '%s' rack number %i given but parent device '%s' has only %i racks!" % (self.name, self.rack, parent_device.name, self.num_racks))
        if (self.address < 0) or (self.address > MAX_ADDRESS):
            raise LabscriptError("For device '%s' address %x given but only 0..%x allowed!" % (self.name, self.address, MAX_ADDRESS))
        #save address bits
        # manually add device to clockline
        #self.parent_device.add_device(self)

    # define conversion function from raw data to data word.
    # will be called by generate_code for each DigitalOut device.
    def to_word(self, channel):
        "return data word for this channel"
        return np.array(np.where(channel.raw_output == channel.default_value,
                                 BIT_NOP_SH,
                                 (channel.raw_output*channel.ch_bits) | channel.addr_bits),
                        dtype=np.uint32)
    #DigitalOut.to_word = _to_word

    def add_device(self, device):
        #save_print('FPGA_Intermediatedevice: add device', device.name)
        #check if valid device, channel and if channel is already used
        #we use shared address from parent (DigitalChannels)
        device.rack, device.address, device.channel = check_device(device, DigitalOut, self.max_channels, self.child_devices, self.shared_address)
        device.type = TYPE_DO
        device.user_default_value = device.default_value # default_value given in connection_table
        device.default_value = DO_INVALID_VALUE # automatically inserted value by labscript
        #data save data and address bits for this channel
        device.ch_bits   = np.array((1<<device.channel) | (self.address << ADDR_SHIFT), dtype=np.uint32)
        device.addr_bits = np.array((self.address << ADDR_SHIFT), dtype=np.uint32)
        # set default value when unused
        IntermediateDevice.add_device(self, device)
        #save device rack/address/channel into hdf5 file
        device.set_property('address', '%i/%i/%i'%(device.rack,device.address,device.channel), 'connection_table_properties')

    # def get_data(self, times, conflicts, data=None, changes=None, rack=None, channels=None):
    #     """
    #     combine data bits of digital channels.
    #     times     = numpy list of times where any channel changes for given board.
    #     conflicts = if channels is None: 2D list for each rack and time, otherwise: 1D list for given rack and time.
    #                    list contains: input boolean of conflicts. output True where two or more channels changes simultaneously.
    #     data      = 2D list for each rack and time: input data for all times (0 initially). output updated data with channel bits.
    #     changes   = 2D list for each rack and time: input boolean for all times (False initially). output True where any channel changes.
    #     rack      = if not None: rack number for which conflicting channels should be added to channels
    #     channels  = if not None: dict with key = conflict time, value = list of conflicting channels for each conflict of given rack
    #         conflict_time = time where conflict occurs. this must be an entry of times[conflicts]
    #         conflict_channels = list of [channel name, initial state, final state] for all channels in rack, where time conflict is detected.
    #         initial and final states are float or integer,
    #         initial state can be None if the conflict occurs at the first instruction of the channel.
    #         a conflicting channel is changing state at the same time as another channel of another device.
    #     note: digital channels with same address (i.e. with same parent DigitalChannels) can change simultaneously.
    #     """
    #     d = np.zeros(len(times),dtype=np.uint32)
    #     chg = np.zeros(len(times),dtype=np.bool_)
    #     if channels is not None: zeros = np.zeros(len(times),dtype=np.uint32)
    #     #combine all channels into data.
    #     #note: labscript gives a warning when a channel state is changed at the same time twice or more. the last state is retained.
    #     #dev.raw_output gives state 0 or 1 for each entry in times
    #     for dev in self.child_devices:
    #         if (channels is None) or (dev.parent_device.rack == rack):
    #             #save_print('combine DO',dev.name)
    #             # first user-defined instruction (auto-inserted time=dev.t0, value=DO_INVALID_VALUE is ignored)
    #             user_times = [key for key,value in dev.instructions.items() if isinstance(value,dict) or (key != dev.t0) or (value != dev.default_value)]
    #             if channels is not None:
    #                 # get changing channels for all conflicts (called only when conflicts detected)
    #                 # here we detect individual changing channels
    #                 d = np.where(dev.raw_output != dev.default_value, dev.raw_output, zeros)
    #                 chg = np.concatenate([[False], (np.array(d[1:] - d[0:-1]) != 0)])
    #                 if len(user_times) > 0:
    #                     chg |= (np.abs(times - round(min(user_times), TIME_ROUND_DECIMALS)) < TIME_PRECISION)
    #                 index = np.arange(len(times))[conflicts & chg]
    #                 for i in index:
    #                     conflict_time = times[i]
    #                     conflict_channel = [dev.name, None if (i == 0) or (d[i - 1] == dev.default_value) else d[i - 1], d[i]]
    #                     if conflict_time in channels:
    #                         channels[conflict_time].append(conflict_channel)
    #                     else:
    #                         channels[conflict_time] = [conflict_channel]
    #             else:
    #                 # here we combine data and detect changes for all channels together
    #                 #d[dev.raw_output == 1] |= dev.ch_bits
    #                 d |= np.where(dev.raw_output == 1, dev.ch_bits, dev.addr_bits)
    #                 if len(user_times) > 0:
    #                     #save_print("'%s' first user time %.6f" % (dev.name, round(min(user_times), TIME_ROUND_DECIMALS)))
    #                     chg |= (np.abs(times - round(min(user_times), TIME_ROUND_DECIMALS)) < TIME_PRECISION)
    #                 #else: save_print("'%s' no user instruction" % (dev.name))
    #     if channels is None:
    #         # detect changes in state = True. first user-defined instructions are ALWAYS executed.
    #         chg |= np.concatenate([[False], (np.array(d[1:] - d[0:-1]) != 0)])
    #         if any(chg):
    #             # detect conflicts with other devices
    #             conflicts[:,dev.parent_device.rack][chg] |= changes[:, dev.parent_device.rack][chg]
    #             # combine data
    #             data[:,dev.parent_device.rack+1][chg] |= (d[chg] & DATA_ADDR_MASK)
    #             # update changes
    #             changes[:,dev.parent_device.rack][chg] = True

# IntermediateDevice with analog output channels
# channels have individual addresses (saved in 'connect').
class AnalogChannels(IntermediateDevice):
    description = 'analog output device with several channels'
    allowed_children = [AnalogOut]
    shared_address = False
    #clock_limit = CLOCK_LIMIT
    #num_racks = 0 # set to maximum allowed number of racks given by FPGA_board

    def __init__(self, name, parent_device, rack, max_channels, bus_rate=MAX_BUS_RATE, **kwargs):
        # parent device must be FPGA_board. you should not connect it directly to clockline.
        if not isinstance(parent_device, FPGA_board):
            raise LabscriptError("Device '%s' parent class is '%s' but must be '%s'!" % (self.name, parent_device.__class__, FPGA_board))
        # get clockline from FPGA_board and set as parent_device
        self.parent_device = parent_device.get_clockline(self, bus_rate)
        # init device with clockline as parent
        IntermediateDevice.__init__(self, name, self.parent_device, **kwargs)

        # set clock limit and resolution
        self.clock_limit      = get_clock_limit(bus_rate)
        self.clock_resolution = get_clock_resolution(bus_rate)

        self.num_racks = parent_device.num_racks
        self.rack = rack
        self.max_channels = max_channels
        if rack >= self.num_racks:
            raise LabscriptError("Device '%s' specified rack number %i is larger than allowed %i!" % (self.name, rack, self.num_racks-1))
        # manually add device to clockline
        #self.parent_device.add_device(self)

    # define conversion function from raw data to data word.
    # will be called by generate_code for each AnalogOut device.
    def to_word(self, channel):
        "return data word for this channel"
        return np.array(np.where(channel.raw_output == channel.default_value,
                                 BIT_NOP_SH,
                                 V_to_word(channel.raw_output) | channel.addr_bits),
                        dtype=np.uint32)
    #AnalogOut.to_word = _to_word

    def add_device(self, device):
        #save_print("AnalogChannels: add device '%s' type '%s'" % (device.name, str(type(device))))
        #check if valid device and channel and if channel is already used
        #create container class and check if valid device, channel and if channel is already used
        #each channel has its own address.
        device.rack, device.address, device.channel = check_device(device, AnalogOut, self.max_channels, self.child_devices, False)
        device.type = TYPE_AO
        device.user_default_value = device.default_value # default_value given in connection_table
        device.default_value = AO_INVALID_VALUE # automatically inserted value by labscript
        #device.id = get_ID(type=device.type, rack=device.rack, address=device.address, channel=device.channel)
        device.addr_bits = np.array(device.address<<ADDR_SHIFT,dtype=np.uint32)
        IntermediateDevice.add_device(self, device)
        device.set_property('address', '%i/%i/%i'%(device.rack,device.address,device.channel), 'connection_table_properties')
        # note: this is called with device = labscript.labscript.AnalogOut via parent class constructors of Output and Device classes.
        #       unfortunately, it is called BEFORE unit_conversion_class and unit_conversion_parameters are assigned!
        #       therefore, we cannot check here (i.e. during compilation of connection table)
        #       if unit_conversion is valid and calculate V_min and V_max for later usage!
        #       instead we have to do this inside get_channels which is called every time when new data is generated (runmanager).

    # def get_data(self, times, conflicts, data=None, changes=None, rack=None, channels=None):
    #     """
    #     combine data bits of analog channels.
    #     times     = numpy list of times where any channel changes for given board.
    #     conflicts = if channels is None: 2D list for each rack and time, otherwise: 1D list for given rack and time.
    #                    list contains: input boolean of conflicts. output True where two or more channels changes simultaneously.
    #     data      = 2D list for each rack and time: input data for all times (0 initially). output updated data with channel bits.
    #     changes   = 2D list for each rack and time: input boolean for all times (False initially). output True where any channel changes.
    #     rack      = if not None: rack number for which conflicting channels should be added to channels
    #     channels  = if not None: dict with key = conflict time, value = list of conflicting channels for each conflict of given rack
    #         conflict_time = time where conflict occurs. this must be an entry of times[conflicts]
    #         conflict_channels = list of [channel name, initial state, final state] for all channels in rack, where time conflict is detected.
    #         initial and final states are float or integer,
    #         initial state can be None if the conflict occurs at the first instruction of the channel.
    #         a conflicting channel is changing state at the same time as another channel of another device.
    #     """
    #     for dev in self.child_devices:
    #         if (channels is not None) and (dev.parent_device.rack != rack): continue # skip wrong rack
    #         #note: dev.raw_output has same length as times and is already in volts and unit_conversion has been applied and limits checked.
    #         d = np.array(V_to_word(dev.raw_output), np.uint16)
    #         chg = np.concatenate([[False], ((d[1:] - d[0:-1]) != 0)])
    #         # detect changes in state = True. in next lines first user-defined instruction is detected and ALWAYS executed.
    #         # note: labscript gives a warning when a channel state is changed at the same time twice or more. the last state is retained.
    #         # first user-defined instruction (auto-inserted time=dev.t0, value=AO_INVALID_VALUE is ignored)
    #         user_times = [key for key,value in dev.instructions.items() if isinstance(value,dict) or (key != dev.t0) or (value != AO_INVALID_VALUE)]
    #         if len(user_times) > 0:
    #             #print('%s user times:' % dev.name, user_times)
    #             #if channels is None: save_print("'%s' first user time %.6f" % (dev.name, round(min(user_times), TIME_ROUND_DECIMALS)))
    #             chg |= (np.abs(times - round(min(user_times), TIME_ROUND_DECIMALS)) < TIME_PRECISION)
    #
    #         #else: save_print("'%s' no user instruction" % (self.name))
    #         #save_print('combine AO',dev.name)
    #         if channels is not None:
    #             # get changing channels for all conflicts (called only when conflicts detected)
    #             index = np.arange(len(times))[conflicts & chg]
    #             for i in index:
    #                 conflict_time = times[i]
    #                 #TODO: unit conversion?
    #                 conflict_channel = [dev.name, None if (i == 0) or (dev.raw_output[i - 1] == AO_INVALID_VALUE) else dev.raw_output[i - 1], dev.raw_output[i]]
    #                 if conflict_time in channels:
    #                     channels[conflict_time].append(conflict_channel)
    #                 else:
    #                     channels[conflict_time] = [conflict_channel]
    #         else:
    #             # detect conflicts with other channels and devices
    #             conflicts[:,dev.parent_device.rack] |= (changes[:,dev.parent_device.rack] & chg)
    #             # combine data
    #             data[:,dev.parent_device.rack+1] = data[:,dev.parent_device.rack+1] | ((d|dev.addr_bits) & (chg*DATA_ADDR_MASK))
    #             # update changes
    #             changes[:,dev.parent_device.rack] |= chg

# IntermediateDevice with DDS output channels
# address of each channel must be integer multiple of 4
# since each channel uses 3 consecutive addresses for frequency, amplitude and phase.
class DDSChannels(IntermediateDevice):
    description = 'DDS output device with several channels'
    allowed_children = [DDS]
    shared_address = False
    #clock_limit = CLOCK_LIMIT
    #num_racks = 0 # set to maximum allowed number of racks given by FPGA_board

    def __init__(self, name, parent_device, rack, max_channels, bus_rate=MAX_BUS_RATE, **kwargs):
        # parent device must be FPGA_board. you should not connect it directly to clockline.
        if not isinstance(parent_device, FPGA_board):
            raise LabscriptError("Device '%s' parent class is '%s' but must be '%s'!" % (self.name, parent_device.__class__, FPGA_board))
        # get clockline from FPGA_board and set as parent_device
        self.parent_device = parent_device.get_clockline(self, bus_rate)
        # init device with clockline as parent
        IntermediateDevice.__init__(self, name, self.parent_device, **kwargs)

        # set clock limit and resolution
        self.clock_limit      = get_clock_limit(bus_rate)
        self.clock_resolution = get_clock_resolution(bus_rate)

        self.num_racks = parent_device.num_racks
        self.rack = rack
        self.max_channels = max_channels
        if rack >= self.num_racks:
            raise LabscriptError("Device '%s' specified rack number %i is larger than allowed %i!" % (self.name, rack, self.num_racks-1))
        # manually add device to clockline
        #self.parent_device.add_device(self)

    # define conversion functions from raw data to data word.
    # will be called by generate_code for each freq, amp, phase channel of DDS device.
    def to_word(self, channel):
        "return data word for this channel"
        if channel.name.endswith('_freq'):
            return np.array(np.where(channel.raw_output == channel.default_value,
                                     BIT_NOP_SH,
                                     V_to_word(channel.raw_output) | channel.addr_bits),
                            dtype=np.uint32)
        elif channel.name.endswith('_amp'):
            return np.array(np.where(channel.raw_output == channel.default_value,
                                     BIT_NOP_SH,
                                     V_to_word(channel.raw_output) | channel.addr_bits),
                            dtype=np.uint32)
        elif channel.name.endswith('_phase'):
            return np.array(np.where(channel.raw_output == channel.default_value,
                                     BIT_NOP_SH,
                                     V_to_word(channel.raw_output) | channel.addr_bits),
                            dtype=np.uint32)
        else:
            raise LabscriptError("DDS channel '%s' to_word: unknown channel type?" % (channel.name))

    def add_device(self, device):
        save_print("DDSChannels: add device '%s' type '%s'" % (device.name, str(type(device))))
        #check if valid device and channel and if channel is already used
        #create container class and check if valid device, channel and if channel is already used
        #each channel has its own address.
        device.rack, device.address, device.channel = check_device(device, DDS, self.max_channels, self.child_devices, False)
        device.type = TYPE_DDS
        if device.address & 3 != 0:
            # address must be integer multiple of 4 so we can address each sub-channel individually
            raise LabscriptError("device '%s' address 0x%x must be multiple of 4!" % (device.name, device.address))
        device.frequency.type           = TYPE_DDS
        device.frequency.address        = device.address+DDS_FREQ_ADDR_OFFSET
        device.frequency.addr_bits      = np.array((device.frequency.address)<<ADDR_SHIFT,dtype=np.uint32)
        device.frequency.rack           = device.rack
        device.frequency.channel        = 0
        device.frequency.set_property('address', '%i/%i/%i'%(device.frequency.rack,device.frequency.address,device.frequency.channel), 'connection_table_properties')
        device.frequency.user_default_value = device.frequency.default_value
        device.frequency.default_value  = DDS_FREQ_INVALID_VALUE
        device.amplitude.type           = TYPE_DDS
        device.amplitude.address        = device.address+DDS_AMP_ADDR_OFFSET
        device.amplitude.addr_bits      = np.array((device.amplitude.address)<<ADDR_SHIFT,dtype=np.uint32)
        device.amplitude.rack           = device.rack
        device.amplitude.channel        = 1
        device.amplitude.user_default_value = device.amplitude.default_value
        device.amplitude.default_value  = DDS_AMP_INVALID_VALUE
        device.amplitude.set_property('address', '%i/%i/%i'%(device.amplitude.rack,device.amplitude.address,device.amplitude.channel), 'connection_table_properties')
        device.phase.type               = TYPE_DDS
        device.phase.address            = device.address+DDS_PHASE_ADDR_OFFSET
        device.phase.addr_bits          = np.array((device.phase.address)<<ADDR_SHIFT,dtype=np.uint32)
        device.phase.rack               = device.rack
        device.phase.channel            = 2
        device.phase.user_default_value = device.phase.default_value
        device.phase.default_value      = DDS_PHASE_INVALID_VALUE
        device.phase.set_property('address', '%i/%i/%i'%(device.phase.rack,device.phase.address,device.phase.channel), 'connection_table_properties')
        #device.user_default_value = device.default_value # default_value given in connection_table
        #device.default_value = AO_INVALID_VALUE # automatically inserted value by labscript
        #device.id = get_ID(type=device.type, rack=device.rack, address=device.address, channel=device.channel)
        IntermediateDevice.add_device(self, device)
        device.set_property('address', '%i/%i/%i'%(device.rack,device.address,device.channel), 'connection_table_properties')
        # note: this is called with device = labscript.labscript.AnalogOut via parent class constructors of Output and Device classes.
        #       unfortunately, it is called BEFORE unit_conversion_class and unit_conversion_parameters are assigned!
        #       therefore, we cannot check here (i.e. during compilation of connection table)
        #       if unit_conversion is valid and calculate V_min and V_max for later usage!
        #       instead we have to do this inside get_channels which is called every time when new data is generated (runmanager).
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
