INO-quantum/FPGA-SoC-experiment-control/firmware-source/2020.1/Petalinux/project-spec/meta-user/recipes-modules/dio24/files/dma.c

////////////////////////////////////////////////////////////////////////////////////////////////////
// dma.c, communicated with phycisal DMA device
// DMA part of dma24 Linux kernel module for Arty-Z7-20 FPGA
// created November 2018 by Andi
// compiled with g++ on Ubuntu 18.04 LTS
// tested with Petalinux 2017.4
// last change 2023/06/13 by Andi
////////////////////////////////////////////////////////////////////////////////////////////////////

#include <linux/kernel.h>			// printk, pr_err, etc.
#include <linux/delay.h>			// udelay
#include <linux/time.h>				// do_gettimeofday
#include <linux/string.h>			// memset, memcpy
#include <linux/slab.h>				// kmalloc, kfree
#include <linux/uaccess.h> 			// copy_to_user, access_ok
#include <linux/random.h>			// get_random_bytes
#include <linux/jiffies.h>			// jiffies
#include "dma.h"

////////////////////////////////////////////////////////////////////////////////////////////////////
// macros
////////////////////////////////////////////////////////////////////////////////////////////////////

// name used in all pre_err statements
#define NAME			"dma24c "		// DMA functions
#define NAME_DIO		"dio24c "		// DIO functions

// timing
#define REPETITIONS		1			    // number of repetitions of test
#define SLEEP_TIME_LONG		50			// long waiting time in microseconds
#define SLEEP_TIME_SHORT	20			// short waiting time in microseconds
#define TIMEOUT_SHORT		10000		// short timeout in us (10ms)
#define TIMEOUT_LONG		100000		// long timeout in us (100ms)
#define TIMEOUT_RESET		1000000		// FPGA reset timeout in us (1s)
#define LOOPS_SHORT         (TIMEOUT_SHORT / SLEEP_TIME_LONG)
#define LOOPS_LONG          (TIMEOUT_LONG / SLEEP_TIME_LONG)
#define LOOPS_RESET         (TIMEOUT_RESET / SLEEP_TIME_LONG)

//self_test settings
//#define TEST_BUF_SIZE			0x4000		// self_test data size in bytes (distributed on random buffer sizes)
//#define ST_NUM_UNTIL_LOOP_RX	2			// number of loops after self_test start when DMA_STATUS_LOOP_RX is set
							// this defines how many RX buffers are allocated
//#define ST_NUM_BEFORE_STOP	100			// number of loops before self_test_loops when DMA_STATUS_STOP_ALL_AT_END is set


///////////////////////////////////////////////////////////////////////////////////////////////////////////////
// globals
///////////////////////////////////////////////////////////////////////////////////////////////////////////////

// IRQ status string
//char * irq_status_string = "dma24: MM2S/S2MM irq=___/___ en=___/___\n";
// offsets into irq_status_string
#define irq_status_MM2S		21
#define irq_status_S2MM		25
#define irq_enable_MM2S		32
#define irq_enable_S2MM		36

// single-linked lists of DMA buffers and descriptors
struct mem_list mem_TX = {NULL, NULL, NULL};
struct mem_list mem_RX = {NULL, NULL, NULL};
struct dsc_list dsc_TX = {NULL, NULL, NULL};
struct dsc_list dsc_RX = {NULL, NULL, NULL};

// single-linked list of unused buffers and descriptors
struct mem_info *mem_pool = NULL;

// packet buffer counter used by prepare_TX_dsc, reset by reset_TX and start_TX
static uint32_t p_count = 0;

///////////////////////////////////////////////////////////////////////////////////////////////////////////////
// function declarations
///////////////////////////////////////////////////////////////////////////////////////////////////////////////

// show DMA status registers and dsc head, tail, last_prep
//void show_status(bool is_TX);

// start TX in scatter/getter DMA mode
int start_TX_SG(void);
// start RX in scatter/getter DMA mode
int start_RX_SG(void);

// verify completed TX descriptors 
int verify_TX(bool release);
// verify completed RX descriptors 
int verify_RX(bool release);

// shows content of DMA buffer
//void show_buf(const char *title, struct mem_info *first, bool is_TX);
// show descriptor content for debugging
void show_dsc(const char *title, struct dsc_list *list, bool is_TX);

// prepares next TX descriptors
int prepare_TX_dsc(void);
// prepares next RX descriptors
int prepare_RX_dsc(void);

// releases un-completed RX dsc's and buffers
//int release_RX(void);

// init source buffer with bit pattern
//void init_source(unsigned char *buffer, uint32_t bytes, uint32_t *count);
// verify destination buffer
//uint32_t verify(unsigned char *buffer, uint32_t bytes, uint32_t *count);

// self_test irq handler TX
int self_test_TX(int err);
// self_test irq handler RX
int self_test_RX(int err);

///////////////////////////////////////////////////////////////////////////////////////////////////////////////
// functions
///////////////////////////////////////////////////////////////////////////////////////////////////////////////

const char *bits[16] = { 
	"0000", "0001", "0010", "0011", "0100", "0101", "0110", "0111",
	"1000", "1001", "1010", "1011", "1100", "1101", "1110", "1111"
};
#define GET_BITS(num32)	bits[(num32 >> 28) & 0xF], bits[(num32 >> 24) & 0xF],\
			bits[(num32 >> 20) & 0xF], bits[(num32 >> 16) & 0xF],\
			bits[(num32 >> 12) & 0xF], bits[(num32 >>  8) & 0xF],\
			bits[(num32 >>  4) & 0xF], bits[ num32        & 0xF]
// print binary number
#define PRINT_BINARY(num32)	pr_err("0b%s%s_%s%s_%s%s_%s%s", GET_BITS(num32))

// shows all desciptors in list.
// returns 0 if ok, otherwise error code
// note:
// [head-tail]              = running      dsc's, tail=NULL or tail->buffer=NULL: nothing running
// [tail->next - last_prep] = prepared     dsc's, last_prep = NULL: nothing prepared (after start_TX/RX_SG)
// [last_prep->next - head[ = not prepared dsc's (exclusive head)
char DMA_sts_bits[7] = "esISDc"; // end/start/IRQ?/error?/error?/completed
int check_dsc(struct dsc_list *list, char *title) {
	int err = 0, i;
	char DMA_sts[7] = "xxxxxx", c[4]="xxx";
	unsigned d_count = 0, b_count = 0, running = 0, prepared = 0;
	uint32_t num, d_bytes = 0, b_bytes = 0, sts;
    bool run;
	struct dsc_info *next = list->head;
	struct SG_dsc * dsc;
    if (list->tail == NULL)              run = false;
    else if (list->tail->buffer == NULL) run = false;
    else                                 run = true;
    if (title) pr_err(NAME "%s:\n", title);
	while(next) {
		if(next->virt_addr == NULL)             { err= -1; break; }                 // must be nonzero
		c[0] = (next == list->head)      ? 'h' : (list->head      ? '.' : '!');	    // head must never NULL
		c[1] = (next == list->tail)      ? 't' : (list->tail      ? '.' : '0');
		c[2] = (next == list->last_prep) ? 'l' : (list->last_prep ? '.' : '0');
		dsc = GET_ALIGNED_DSC(next->virt_addr);
		num = dsc->control & SG_MM2S_CTRL_BYTES;
		sts = (dsc->status & SG_MM2S_STATUS_COMPLETE) ? dsc->status : dsc->control;
		sts = sts >> 26;
		for(i=0;i<6;++i,sts=sts>>1) DMA_sts[i] = (sts & 1) ? DMA_sts_bits[i] : '.';
		d_bytes += num;
		if(next->buffer) {
			pr_err(NAME "dsc %2d %s %5u %s %8p %5u %2u\n", d_count, c, num, DMA_sts, next->buffer, next->buffer->bytes, next->buffer->ref_cnt);
            if (next->buffer->ref_cnt == 0)     { err = -2; break; }                // must be at least 1
			b_bytes += next->buffer->bytes;
			++b_count;
		}
		++d_count;
        if (next == list->tail) {
            if (run) {
                if (b_count != d_count)         { err = -3; break; }                // unprepared buffers between head and tail?
                else if (d_count == 0)          { err = -4; break; }                // no running descriptors?
                running = d_count;
            }
            else {
                if (b_count != 0)               { err = -5; break; }                // TODO: not sure if this can happen or not?
                else if (next->buffer)          { err = -6; break; }                // if not running then tail->buffer must be NULL
            }
        }
        else if (next == list->last_prep) {
            prepared = d_count - running;
            if (prepared == 0)                  { err = -7; break; }                // last_prep == tail? if nothing prepared last_prep should be NULL.
        }
		next = next->next;
		if(next == list->head) break;
	}
    if (err) pr_err(NAME "check_dsc: dsc's/bytes %u/%u error %d!\n", d_count, d_bytes, err);
    else     pr_err(NAME "check_dsc: dsc's/bytes %u/%u ok\n", d_count, d_bytes);
    pr_err(NAME "           run/prep/not prep  %u/%u/%u\n", running, prepared, d_count - running - prepared);
	pr_err(NAME "           bufs/bytes %u/%u\n",      b_count, b_bytes);
	return err;
}

// check validity of descriptors in list starting at head and ending at tail (inclusive)
// head = first descriptor in list.
// tail = last descriptor in list.
// is_TX = true if descriptor is TX dsc, otherwise RX dsc.
// returns 0 if ok, otherwise error code
// start and end bits are ignored
// this is called from start_TX/RX_SG to check if prepared dsc's are valid
int check_sg_dsc(struct dsc_info *head, struct dsc_info *tail, bool is_TX) { 
	int err = 0, i = 0;
	uint32_t num, count = 0;
	struct dsc_info *act = head;
	struct SG_dsc * dsc = NULL;

	if((head == NULL) || (tail == NULL)) err = -1;
	else {
		//pr_err(NAME "check_sg_dsc: first=%p, next=%p, last=%p\n", list.first, list.next, list.last);
		while(true) {
			//pr_err(NAME "%d check_sg_dsc: this   %p\n", i, act);
			//pr_err(NAME "%d check_sg_dsc: dsc    %p\n", i, act->virt_addr);
			//pr_err(NAME "%d check_sg_dsc: next   %p\n", i, act->next);
			//pr_err(NAME "%d check_sg_dsc: buf    %p\n", i, act->buffer);
			if(act->buffer == NULL) { err = -10; break; } // buffer must not be NULL
			dsc = GET_ALIGNED_DSC(act->virt_addr); // virtual address!
			if(!dsc) { err = -11; break; }
			if((!IS_ALIGNED_DSC(dsc)) || (!IS_ALIGNED_DSC(GET_ALIGNED_PHYS_DSC(act->phys_addr)))) 
			{ err = -12; break; }
			if(dsc->address_low != GET_ALIGNED_PHYS_BUFFER(act->buffer->phys_addr)) // physical address!
			{ err = -13; break; }
			//pr_err(NAME "%d check_sg_dsc: buffer %p\n", i, dsc->address_low);
			if((dsc->address_low != GET_ALIGNED_PHYS_BUFFER(act->buffer->phys_addr)) || 
				(!IS_ALIGNED_BUFFER(dsc->address_low))) { err = -21; break; }	// wrong buffer!
			if(dsc->address_high != 0) { err = -23; break; }
			num = dsc->control & SG_MM2S_CTRL_BYTES;
			//pr_err(NAME "%d check_sg_dsc: %u bytes\n", i, num);
			/*if(dsc->control != (BUF_SIZE | 
					((i == 0) ? SG_MM2S_CTRL_START : 0) |
					(((i+1) < SG_NUM) ? 0: SG_MM2S_CTRL_END)
					)) { err = -14; break; }*/
			if(num > DMA_BUF_SIZE) { err = -31; break; }
			count += num;

			// next must never be NULL (ring-buffer)
			if(act->next == NULL) { err = -32; break; }

			// check next dsc low address
			if(dsc->next_low != GET_ALIGNED_PHYS_DSC(act->next->phys_addr)) // physical address!
			{ err = -33; break; }
			// check next dsc high address (must be always 0)
			if(dsc->next_high != 0) { err = -34; break; } 

			// check buffer reference counter
			if(is_TX && (act->buffer->ref_cnt == 0)) { err = -35; break; } // must be >0
			else if((!is_TX) && (act->buffer->ref_cnt != 1)) { err = -36; break; } // must be 1

			/*if(act == head) {
				//pr_err(NAME "%d check_sg_dsc: this is first\n", i);
				if(is_TX) { // first must have start bit set
					if((dsc->control & SG_MM2S_CTRL_START) != SG_MM2S_CTRL_START) { err = -41; break; }
				}
			}
			else {
				// normal descriptor cannot have start bit set
				if((dsc->control & SG_MM2S_CTRL_START) != 0) { err = -42; break; }
			}*/

			++i;

			if(act == tail) {
				//pr_err(NAME "%d check_sg_dsc: this is last\n", i);
				// last must have end bit set
				//if((dsc->control & SG_MM2S_CTRL_END) != SG_MM2S_CTRL_END) { err = -61; break; }
				
				// next dsc must point to first dsc
				//if(dsc->next_low != GET_ALIGNED_PHYS_DSC(first->phys_addr)) // physical address!
				// check next dsc
				// stop if last found
				break;
			}
			/*else {
				// normal descriptor cannot have end bit set
				if((dsc->control & SG_MM2S_CTRL_END) != 0) { err = -71; break; }
			}
*/
			//print_sg_dsc(act);

			act = act->next;

			if((act == head) || (act == NULL) || (i > (is_TX ? DSC_TX_NUM : DSC_RX_NUM))) { err = -99; break; } // end of ring-buffer reached without tail found!
		}
	}
	if(err) pr_err(NAME "check_sg_dsc: #%d dsc validity check error %d.\n", i, err);
	//else pr_err(NAME "check_sg_dsc: %d dsc's validity check ok (%u bytes).\n", i, count);
	return err;
}


// get new DMA buffer from memory_pool or allocates it
// returns NULL on error
// ATTENTION: must be called with user_mutex locked!
inline struct mem_info *get_mem(unsigned dbg_index) {
	struct mem_info *mem;
	if(mem_pool == NULL) {
		// allocate memory info
		mem = MALLOC_MEM_INFO;
		if(mem != NULL) {
			// allocate DMA buffer (virtual and physical address)
			MALLOC_BUFFER(mem->virt_addr, mem->phys_addr);
			if(mem->virt_addr == NULL) {
				FREE_MEM_INFO(mem);
				mem = NULL;
			}
			else ++debug_DMA_count[dbg_index];
		}
	}
	else {	// get memory info from pool
		mem = mem_pool;
		mem_pool = mem_pool->next;
		--debug_DMA_count[DBG_BUF_POOL];
		// DMA buffer must be already allocated. return NULL if this is not the case!
		if(mem->virt_addr == NULL) {
			FREE_MEM_INFO(mem);
			mem = NULL;
		}
		else ++debug_DMA_count[dbg_index];
	}
	// init memory
	if(mem) {
		mem->next = NULL;
		mem->bytes = 0L;
		mem->ref_cnt = 0;
	}
	return mem;
}

// free allocated DMA buffer and descriptors starting from 'first' until end of list.
// the list can be terminated with next == NULL or be a circular buffer next = first.
// the _no_pool version does not insert them back into pool but frees memory
// ATTENTION: must be called with user_mutex locked!
// last->next will be overwritten!
inline void free_mem(struct mem_info *first, unsigned dbg_index) { 
	unsigned count = 0;
	struct mem_info *test = first, *last = NULL;
	if (first) {
		while(true) { 	// find last entry
			if(test->ref_cnt != 0) { pr_err("\n*** "NAME "free_mem: ref_cnt != 0! ***\n\n"); return; } // error! and memory leak!
			++count;
			last = test;
			test = test->next;
			if ((test == NULL) || (test == first)) { // end of list: prepend to mem_pool
				last->next = mem_pool;
				mem_pool = first; 
				debug_DMA_count[dbg_index] -= count;
				debug_DMA_count[DBG_BUF_POOL] += count;
				break;
			}
		}
	}
}
inline void free_mem_no_pool(struct mem_info *first, unsigned dbg_index) {
	unsigned count = 0;
	struct mem_info *next = first, *tmp;
	if(first) {
		do {
			tmp = next->next;
			if(next->ref_cnt != 0) { pr_err("\n *** " NAME "free_mem (np) ref_cnt != 0! ***\n\n"); return; }
			if(next->virt_addr != NULL) FREE_BUFFER(next->virt_addr, next->phys_addr); 
			FREE_MEM_INFO(next);
			++count;
			next = tmp;
		} while ((next != NULL) && (next != first));
		debug_DMA_count[dbg_index] -= count;
	}
}

// for debugging count entries of TX, RX and testing lists
unsigned debug_DMA_count[DBG_NUM] = {0,0,0,0,0,0};
int free_dsc_no_pool(struct dsc_info *head, unsigned dbg_index) {
	int err = 0, count = 0; 
	struct dsc_info *act = head, *next;
	if(head) {
		do {
			if(act->buffer != NULL) { pr_err("\n *** " NAME "free_dsc (np) buffer != NULL! ***\n\n"); return -1; }
			next = act->next;
			if(act->virt_addr != NULL) FREE_DSC(act->virt_addr, act->phys_addr);
			FREE_DSC_INFO(act);
			++count;
			act = next;
		} while((act != NULL) && (act != head));
	}
	if(count != debug_DMA_count[dbg_index]) { pr_err("\n *** " NAME "free_dsc (np) count %u != %u! ***\n\n", count, debug_DMA_count[dbg_index]); if(!err) err = -50; }
	debug_DMA_count[dbg_index] -= count;
	return err;
}

// shows s_num samples in TX/RX buffer starting at s_start sample
void show_data(struct mem_info *mem, uint32_t s_start, uint32_t s_num) {
	uint32_t i, j = mem->bytes / DIO_BYTES_PER_SAMPLE, *p = GET_ALIGNED_BUFFER(mem->virt_addr);
	s_num += s_start;
	for (i = 0; i < s_num; ++i, --j, p += (DIO_BYTES_PER_SAMPLE/4)) {
		if(j == 0) {
			mem = mem->next;
			if(mem == NULL) return;
			if(mem->bytes == 0) continue;
			j = mem->bytes / DIO_BYTES_PER_SAMPLE;
			p = GET_ALIGNED_BUFFER(mem->virt_addr);
		}
		if(i >= s_start) {
#if DIO_BYTES_PER_SAMPLE == 8
			pr_err("%03d: %8u us %08x\n", i, *(p), *(p+1));
#elif DIO_BYTES_PER_SAMPLE == 12
			pr_err("%03d: %8u us %08x %08x\n", i, *(p), *(p+1), *(p+2));
#endif
		}
	}

}

// called by check_mem to check correct increment of time in data
// returns -1 if ok, otherwise sample index with error
int check_data(uint32_t *data, uint32_t bytes, uint32_t *t_old) {
	int i;
	bytes = (bytes / DIO_BYTES_PER_SAMPLE);
	for(i = 0; i < bytes; data += (DIO_BYTES_PER_SAMPLE/4), ++i) {
		if ((*t_old != 0xffffffff) && (*data <= *t_old)) return i;
		*t_old = *data;
	}
	return -1;
}

// check validity of DMA buffers in list
// returns 0 if ok, otherwise error code
// notes: 
// - if test_data is true checks that time is incremental and
//   if no other error and buffer size is not multiple of DMA_BUF_MULT returns ERROR_NO_BUF_MULT
//   this way function can check for other errors and caller can decide what to do
// - mem_RX is a ring buffer while mem_TX is not! 
// - mem_RX.last is not maintained outside from prepare_RX_buffers and is not checked here.
int check_mem(struct mem_list *list, bool show, bool test_data) {
	int count = 0, err = 0, err_alt = 0, locked = 0;
	bool next_found = false;
	unsigned int bytes = 0;
	uint32_t t_old = 0xffffffff, *p;
	struct mem_info *first = list->first;
	if (show) {
        if (list->first == NULL) pr_err(NAME "check_mem: empty\n");
        else                     pr_err(NAME "check_mem: f/n/l %p/%p/%p\n", list->first, list->next, list->last);
    }
	while(first) {
		if(show) pr_err("%s%03d: %p %8u %2u\n", NAME, count, first, first->bytes, first->ref_cnt);
		// first->ref_cnt we cannot check here
		if((first->virt_addr == 0)||(first->phys_addr == 0)) { err = -101; break; } 
		if(first->bytes > DMA_BUF_SIZE) { err = -102; break; }
		if(test_data) {
			if(first->bytes == 0) { err = -103; break; } // we cannot check data when there is no data!
			if(first->bytes % DMA_BUF_MULT) err_alt = -ERROR_NO_BUF_MULT; // append_TX not yet called?
			err = check_data(GET_ALIGNED_BUFFER(first->virt_addr),first->bytes,&t_old);
			if (err >= 0) {
				p = GET_ALIGNED_BUFFER(first->virt_addr) + (err*DIO_BYTES_PER_SAMPLE/4); // buffer offset at error
				err = bytes/DIO_BYTES_PER_SAMPLE + err; // total sample offset at error
				pr_err("%s%03d: %p %8u %2u     error time! # %d t_old=%u us\n", NAME, count, first, first->bytes, first->ref_cnt, err, t_old);
				if (err > 1) {
					if(err >= 10) show_data(list->first, err - 10, 10);
					else show_data(list->first, 0, err - 1);
				}
#if DIO_BYTES_PER_SAMPLE == 8
				pr_err("%03d: %8u us %08x < error time!\n", err, *(p), *(p+1));
#elif DIO_BYTES_PER_SAMPLE == 12
				pr_err("%03d: %8u us %08x %08x < error time!\n", err, *(p), *(p+1), *(p+2));
#endif
				show_data(list->first, err + 1, (err >= 10) ? 10 : 20-err);
				err = -104; 
				break;
			}
			else err = 0;
		}
		if(first->next == NULL) { // check mem_TX.last
			if((list != &mem_TX) || (list->last != first)) { err = -105; break; }
		}
		else if (first->next == list->first) { // check mem_RX.last
			if((list != &mem_RX) /*|| (list->last != first)*/) { err = -106; break; }
		}
		if(list->next == first) { // next found
			if(next_found) { err = -107; break;} // loop?
			else next_found = true;
		}
        if (first->ref_cnt > 0) ++locked;
		bytes += first->bytes;
		first = first->next;
		++count;
		if(first == list->first) { 		// ring-buffer closed
			if (list != &mem_RX ) err = -108; 
			break; 
		}
	}
	if(list->first == NULL) {
		if(list->next != NULL) err = -109;
		if(list->last != NULL) err = -110;
	}
	if((!err) && (list->next != NULL) && (!next_found)) err = -111; // next is not in list!
	if(!err) err = err_alt;
	if(err) pr_err("%scheck_mem: locked/tot/bytes %d/%d/%u error %d!\n", NAME, locked, count, bytes, err);
	else if (show) pr_err("%scheck_mem: locked/tot/bytes %d/%d/%u ok\n", NAME, locked, count, bytes);
	return err;
}

// return FPGA status string
char *FPGA_status_str(uint32_t status) {
	static char st_run[]   = "running";
	static char st_err[]   = "error";
	static char st_end[]   = "end";
	static char st_stop[]  = "stopped";
	if (status & DIO_STATUS_RUN) return st_run;
	if (status & DIO_STATUS_END) return st_end;
	if (status & DIO_STATUS_ERROR) return st_err;
	return st_stop;
}

#define CHECK_BT_TOT(st)	((st.TX_bt_tot == st.RX_bt_tot) && (st.RX_bt_tot == (st.bt_tot*st.reps_set)))

// updates status info and if st != NULL saves to st
// if force=True resets status and forces reading of FPGA registers
// if show=True prints status on console
void update_status(struct FPGA_status *st, bool show, bool force) {
    static bool first_time = true;
    static char board_c0[] = "Cora-Z7-07S";
    static char board_c1[] = "Cora-Z7-10";
    static char board_a1[] = "Arty-Z7-10";
    static char board_a2[] = "Arty-Z7-20";
    static char board_u[]  = "unknown";
	//int i;
	int32_t mT = 0;
    uint32_t tmp;
    char *ptr;
    if (force) { // force read FPGA registers
        memset(&status, 0, sizeof(struct FPGA_status));
        // --- FPGA section ---
        // control
        status.ctrl_FPGA                    = READ_DIO_REGISTER(DIO_REG_CTRL);
        status.ctrl_in                      = READ_DIO_REGISTER(DIO_REG_CTRL_IN);
        status.ctrl_out                     = READ_DIO_REGISTER(DIO_REG_CTRL_OUT);
        status.set_samples                  = READ_DIO_REGISTER(DIO_REG_NUM_SAMPLES);
        status.clk_div                      = READ_DIO_REGISTER(DIO_REG_CLK_DIV);
        status.strb_delay                   = READ_DIO_REGISTER(DIO_REG_STRB_DELAY);
        status.sync_delay                   = READ_DIO_REGISTER(DIO_REG_SYNC_DELAY);
        status.sync_phase                   = READ_DIO_REGISTER(DIO_REG_SYNC_PHASE);
        // status register
        status.status_FPGA.status           = READ_DIO_REGISTER(DIO_REG_STATUS);
        status.status_FPGA.board_time       = READ_DIO_REGISTER(DIO_REG_BOARD_TIME);
        status.status_FPGA.board_samples    = READ_DIO_REGISTER(DIO_REG_BOARD_SAMPLES);
        status.board_time_ext               = READ_DIO_REGISTER(DIO_REG_BOARD_TIME_EXT);
        status.board_samples_ext            = READ_DIO_REGISTER(DIO_REG_BOARD_SAMPLES_EXT);
        status.sync_time                    = READ_DIO_REGISTER(DIO_REG_SYNC_TIME);
        status.status_info.version          = READ_DIO_REGISTER(DIO_REG_VERSION);
        status.status_info.info             = READ_DIO_REGISTER(DIO_REG_INFO);
        // XDC module board temperature
        status.FPGA_temp = READ_XADC_REGISTER(XADC_TEMP_ACT);
        if (first_time) { // first temperature read is always wrong. so read 2x
            first_time = false;
            status.FPGA_temp = READ_XADC_REGISTER(XADC_TEMP_ACT);
        }
    }
	if(st) memcpy(st,&status,sizeof(struct FPGA_status));
	if(show) {
		mT = GET_mT(status.FPGA_temp);
		pr_err(NAME "DMA & FPGA status:\n");
		pr_err(NAME "                    TX       RX     FPGA\n");
		pr_err(NAME "ctrl       0x %8x        - %08x\n",  status.ctrl_DMA, status.ctrl_FPGA);
		pr_err(NAME "in/out     0x        - %08x %08x\n",                   status.ctrl_in,  status.ctrl_out);
        pr_err(NAME "in/out/bus ps %8u %8u %8u\n",        status.period_in, status.period_out, status.period_bus);
        pr_err(NAME "strb/clk   0x        - %8x %8x\n",                       status.strb_delay, status.clk_div);
		pr_err(NAME "sync w/ph  0x %8x %8x\n",            status.sync_delay, status.sync_phase);
		pr_err(NAME "status     0x %8x %8x %8x (%s)\n", 	status.status_TX, status.status_RX, status.status_FPGA.status, FPGA_status_str(status.status_FPGA.status));
        pr_err(NAME "board #/t            - %8u %8d us\n",                  status.status_FPGA.board_samples, status.status_FPGA.board_time);
        pr_err(NAME "board #/t (ext)      - %8u %8d us\n",                  status.board_samples_ext, status.board_time_ext);
        //pr_err(NAME "board cyc            -        - %8d us\n",             status.board_cycles);
		pr_err(NAME "sync time            -        - %8d\n",                status.sync_time);
		pr_err(NAME "temperature          -        - %4d.%03u deg.C\n",                       mT/1000, mT % 1000);
        pr_err(NAME "phase ext/det        - %8d %8d steps\n",               status.phase_ext, status.phase_det);
		pr_err(NAME "error         %8d %8d %8d\n",        status.err_TX,    status.err_RX,    status.err_FPGA);
		pr_err(NAME "IRQ's         %8u %8u %8u\n",        status.irq_TX,    status.irq_RX,    status.irq_FPGA);
		pr_err(NAME "IRQ's mrg     %8u\n",                status.irq_num);
		pr_err(NAME "trans bytes   %8u %8u %8u (%s)\n",   status.TX_bt_tot, status.RX_bt_tot, status.bt_tot, CHECK_BT_TOT(status) ? "ok" : "error" );
		pr_err(NAME "TX p/a/c      %8u %8u %8u\n",        status.dsc_TX_p,  status.dsc_TX_a,  status.dsc_TX_c);
		pr_err(NAME "RX p/a/c      %8u %8u %8u\n",        status.dsc_RX_p,  status.dsc_RX_a,  status.dsc_RX_c);
		pr_err(NAME "rd m/a/d      %8u %8u %8u\n",       	status.RD_bt_max, status.RD_bt_act, status.RD_bt_drop);
		pr_err(NAME "reps/act      %8u %8u\n",       	status.reps_set,  status.reps_act);
		pr_err(NAME "timeout       %8u\n",  		status.timeout);
#if DIO_BYTES_PER_SAMPLE == 8
		pr_err(NAME "RX last    0x %08x %08x          (%u us)\n",	status.last_sample.data32[0], status.last_sample.data32[1], status.last_sample.data32[0]);
#elif DIO_BYTES_PER_SAMPLE == 12
		pr_err(NAME "RX last    0x %08x %08x %08x (%u us)\n",	status.last_sample.data32[0], status.last_sample.data32[1], status.last_sample.data32[2], status.last_sample.data32[0]);
#endif		
		//pr_err(NAME "bt/cyc/smpl   %8u %8u %8u (mult. of %u)\n", DIO_BYTES_PER_SAMPLE, status.set_samples, status.set_cycles, DMA_BUF_MULT/DIO_BYTES_PER_SAMPLE);
        pr_err(NAME "bt/smpl   %8u        - %8u (mult. of %u)\n", DIO_BYTES_PER_SAMPLE, status.set_samples, DMA_BUF_MULT/DIO_BYTES_PER_SAMPLE);
        tmp = status.status_info.version;       // board version {brd_vers_major[7:0],brd_vers_minor[7:0],year[6:0],month[3:0],day[4:0]}
		pr_err(NAME "version    0x        -        - %08x (%02u.%02u-%04u/%02u/%02u)\n", tmp, (tmp>>24)&0xff, (tmp>>16)&0xff, ((tmp>>9)&0x7f)+2000, (tmp>>5)&0xf, tmp&0x1f);
        tmp = status.status_info.info;
        switch (tmp & 0xff) {
            case 0xc0: ptr = board_c0; break;
            case 0xc1: ptr = board_c1; break;
            case 0xa1: ptr = board_a1; break;
            case 0xa2: ptr = board_a2; break;
            default:   ptr = board_u;
        }
		pr_err(NAME "info       0x        -        - %08x (%s)\n", tmp, ptr);
/*
		pr_err(NAME "debug_cnt     %8u\n",  		status.debug_count);
		for(i=0; i<FPGA_STATUS_NUM_DEBUG; ++i) {
			if ((i % DBG_HIST) == 0) pr_err(NAME "debug %2d   0x %8x", i, status.debug[i]);
			else if ((i % DBG_HIST) == (DBG_HIST-1)) pr_err(" %8x\n", status.debug[i]);
			else pr_err(" %8x", status.debug[i]);
		}
*/
	}
}

// set dio24 control register and return actual value
// for settable configuration values see DIO_CTRL_SETTABLE in dma24.h
// note: FPGA must be stopped!
int set_config(uint32_t *config) {
	int err = 0;
	uint32_t ctrl = status.ctrl_FPGA;
	
	if(ctrl & DIO_CTRL_RUN) {
		pr_err(NAME "set FPGA config: FPGA must be stopped! (error)\n");
		err = -1;
	}
	else {
		if((*config & (~DIO_CTRL_USER)) != 0) {
			pr_err(NAME "set FPGA config: wrong bits! %u (error)\n", *config);
			err = -2;
		}
		else {					
			if(ctrl != READ_DIO_REGISTER(DIO_REG_CTRL)) {
				pr_err(NAME "set FPGA config: CTRL %x != register %x (error)\n", ctrl, READ_DIO_REGISTER(DIO_REG_CTRL));
				err = -3;
			}
			else
			{
				// save settings
				status.ctrl_FPGA = (status.ctrl_FPGA & ~DIO_CTRL_USER) | (*config & DIO_CTRL_USER);
				WRITE_DIO_REGISTER(DIO_REG_CTRL, status.ctrl_FPGA);
				// ensure configuration is written
				wmb();
				// return new status
				*config = status.ctrl_FPGA;
				//pr_err(NAME "set_config %x, old = %x (ok)\n", status.ctrl_FPGA, ctrl);
			}
		}
	}
	return err;
}

// returns num_dsc allocated descriptors or NULL on error
// notes: 
// - start/end bits are not set since have to be set by prepare_TX/RX_dsc.
// - completion bit is also not set.
// - dsc is automatically closed as ringbuffer (last->next=first)
struct dsc_info *allocate_dsc(int num_dsc, unsigned index) {
	int i;
	uint32_t count = 0;
	struct dsc_info *first, *last = NULL, *prev = NULL;
	struct SG_dsc *dsc;

	// allocate dsc info
	first = MALLOC_DSC_INFO;
	if(first == NULL) pr_err(NAME "allocate_dsc: out of mem! (1)\n");
	else {
		// init with zeros
		memset(first, 0, sizeof(struct dsc_info));

		// allocate dsc (virtual and physical address)
		MALLOC_DSC(first->virt_addr, first->phys_addr);
		if(first->virt_addr == NULL) {
			pr_err(NAME "allocate_dsc: out of mem! (2)\n");
			FREE_DSC_INFO(first);
			first = NULL;
		}
		else {
			// for debugging count entries
			++count;

			// init first descriptor with zeros.
			prev = last = first;
			dsc = GET_ALIGNED_DSC(last->virt_addr);	// aligned virtual descriptor
			memset(dsc, 0, sizeof(struct SG_dsc));
			
			// loop over additional descriptors
			for(i = 1; i < num_dsc; ++i) {
				// allocate memory info
				last = last->next = MALLOC_DSC_INFO;
				if(last == NULL) { pr_err(NAME "allocate_dsc: out of mem! (3)\n"); break; }
				
				// init descriptor with zeros
				memset(last, 0, sizeof(struct dsc_info));

				// allocate dsc (virtual and physical address)
				MALLOC_DSC(last->virt_addr, last->phys_addr);
				if(last->virt_addr == NULL) {
					pr_err(NAME "allocate_dsc: out of mem! (4)\n");
					FREE_DSC_INFO(last);
					prev->next = last = NULL;
					break;
				}

				// for debugging count entries
				++count;

				// in previous descriptor save aligned physical address
				dsc->next_low = GET_ALIGNED_PHYS_DSC(last->phys_addr);

				// init descriptor with zeros
				dsc = GET_ALIGNED_DSC(last->virt_addr);	// aligned virtual descriptor
				// dsc->next is set in next loop
				// dsc_address_low must be DATA_WIDTH_ALIGN aligned
				// dsc_control is set to buffer size and might have start or end bit set (later).
				// dsc_status gets after successful completion transmitted buffer size and completion bit set.
				memset(dsc, 0, sizeof(struct SG_dsc));

				// save previous descriptor (only needed in error case)
				prev = last;
			} // next loop
		}
	}

	// update debug counter
	debug_DMA_count[index] += count;

	// if all ok return list, else delete list
	if(first != NULL) {
		if (last != NULL) { 
			// set last->next to first entry to close ring-buffer. same for descriptor.
			last->next = first;
			dsc->next_low = GET_ALIGNED_PHYS_DSC(first->phys_addr);
		}
		else {
			pr_err(NAME "allocate_dsc: out of mem!\n");
			free_dsc_no_pool(first, index);
			first = NULL;
		}
	}
	else pr_err(NAME "allocate_dsc: out of mem!\n");
	return first;
}


//inline void irq_enable(void) {
//	uint32_t old;
	//if(dma24_reg_base != NULL) {
	//	pr_err(NAME "irq enable: (not implemented)\n");
	//}
	/*if(dio24_reg_base != NULL) {
		old = READ_DIO_REGISTER(DIO_REG_CTRL);
		WRITE_DIO_REGISTER(DIO_REG_CTRL, old | DIO_CTRL_IRQ_FPGA); // | DIO_CTRL_IRQ_TX | DIO_CTRL_IRQ_RX);
	}*/
//}

//inline void irq_disable(void) {
//	uint32_t old;
	//if(dma24_reg_base != NULL) {
	//	pr_err(NAME "irq disable: (not implemented)\n");
	//}
	/*if(dio24_reg_base != NULL) {
		old = READ_DIO_REGISTER(DIO_REG_CTRL);
		WRITE_DIO_REGISTER(DIO_REG_CTRL, old & (~(DIO_CTRL_IRQ_FPGA | DIO_CTRL_IRQ_TX | DIO_CTRL_IRQ_RX)));
	}*/
//}

// save TX and RX and FPGA status register and acknowledge all interrups
// call within IRQ, status gets TX_status, RX_status
// notes: 
// - RESET_REGISTER_BIT does not work, have to use SET_REGISTER_BIT or WRITE_DMA_REGISTER instead!
// - this is NOT called within user_mutex since might lock out itself! locking must be done from helper_thread.
inline void irq_ack_TX(uint32_t status_irq[HELPER_TASK_NUM_STATUS_IRQ]) {
	//static TIME_DATA t_IRQ;

	// count irq's
	++status.irq_TX;

	// save time of IRQ
	// todo: save directly into status
	//GET_TIME(t_IRQ);
	//status_irq[HELPER_STATUS_SEC]=GET_SEC(t_IRQ);
	//status_irq[HELPER_STATUS_USEC]=GET_USEC(t_IRQ);

	//rmb(); // not sure if needed?
	
	// save register content
	status_irq[HELPER_STATUS_TX] = READ_DMA_REGISTER(DMA_REG_MM2S_STATUS);
	status_irq[HELPER_STATUS_RX] = 0L;

	// writing to these registers reset bits
	if(status_irq[HELPER_STATUS_TX] & MM2S_STATUS_IRQS) WRITE_DMA_REGISTER(DMA_REG_MM2S_STATUS, status_irq[HELPER_STATUS_TX]);

	// memory barrier to ensure data is written!
	// todo: not sure if needed inside irq routine? (I actually think its not needed)
	//wmb();
}
inline void irq_ack_RX(uint32_t status_irq[HELPER_TASK_NUM_STATUS_IRQ]) {
	//static TIME_DATA t_IRQ;

	// count irq's
	++status.irq_RX;

	// save time of IRQ
	// todo: save directly into status
	//GET_TIME(t_IRQ);
	//status_irq[HELPER_STATUS_SEC]=GET_SEC(t_IRQ);
	//status_irq[HELPER_STATUS_USEC]=GET_USEC(t_IRQ);

	//rmb(); // not sure if needed?
	
	// save register content
	status_irq[HELPER_STATUS_TX] = 0L;
	status_irq[HELPER_STATUS_RX] = READ_DMA_REGISTER(DMA_REG_S2MM_STATUS);

	// writing to these registers reset bits
	if(status_irq[HELPER_STATUS_RX] & S2MM_STATUS_IRQS) WRITE_DMA_REGISTER(DMA_REG_S2MM_STATUS, status_irq[HELPER_STATUS_RX]);

	// memory barrier to ensure data is written!
	// todo: not sure if needed inside irq routine? (I actually think its not needed)
	//wmb();
}
/*inline void irq_ack_FPGA(uint32_t status_irq[HELPER_TASK_NUM_STATUS]) {
	//int i = 0;
	
	// count irq's
	++status.irq_FPGA;

	// save register content
	status_irq[HELPER_STATUS_TX] = status_irq[HELPER_STATUS_RX] = 0L;
	status.status_FPGA.status = status_irq[HELPER_STATUS_FPGA] = READ_DIO_REGISTER(DIO_REG_STATUS);

	// reset corresponding irq enable bit(s) which also resets irq(s)
	WRITE_DIO_REGISTER(DIO_REG_CTRL, status.ctrl_FPGA & (~(status.status_FPGA.status & DIO_STATUS_IRQ_ALL)));

	// enable irq again if there is no error
	if (status.status_FPGA.status & DIO_STATUS_IRQ_FPGA_ERR) { 
		status.ctrl_FPGA &= (~(status.status_FPGA.status & DIO_STATUS_IRQ_ALL));
		//pr_err(NAME "irq_FPGA ctrl/status = 0x %x / %x error!\n", status.ctrl_FPGA,status.status_FPGA.status);
	}
	else { 
		WRITE_DIO_REGISTER(DIO_REG_CTRL, status.ctrl_FPGA);
		//pr_err(NAME "irq_FPGA ctrl/status = 0x %x / %x ok\n", status.ctrl_FPGA,status.status_FPGA.status);
	}
}*/

/* irq_FPGA handler executed by helper thread with user_mutex locked
// FPGA produces irq only when in end state, on auto-restart, on error or on update
// for performance we limit output to every 5 seconds except end and error
inline void irq_hdl_FPGA(uint32_t status_irq[HELPER_TASK_NUM_STATUS]) {
	if (status.status_FPGA.status & (DIO_STATUS_ERROR|DIO_STATUS_END)) {
		if (status.status_FPGA.status & DIO_STATUS_ERROR) pr_err(NAME "%u irq_FPGA ctrl/status = 0x%x/%x (error!)\n", irq_cnt + 1, status.ctrl_FPGA, status.status_FPGA.status);
		else pr_err(NAME "%u irq_FPGA ctrl/status = 0x%x/%x (end)\n", irq_cnt + 1, status.ctrl_FPGA, status.status_FPGA.status);
		jf_old = jiffies;
		irq_cnt = 0;
	}
	else {	// auto-restart or update timer
		if((jiffies - jf_old) > (5*HZ)) {
			if (status.status_FPGA.status & DIO_STATUS_IRQ_FPGA_RESTART) pr_err(NAME "%u irq_FPGA ctrl/status = 0x%x/%x (auto-restart)\n", irq_cnt + 1, status.ctrl_FPGA, status.status_FPGA.status);
			else pr_err(NAME "%u irq_FPGA ctrl/status = 0x%x/%x (update)\n", irq_cnt + 1, status.ctrl_FPGA, status.status_FPGA.status);
			jf_old = jiffies;
			irq_cnt = 0;
		}
		else ++irq_cnt; // in next message we display # of new irqs
	}
}*/

// handle irq_TX/RX by helper thread with locked user_mutex
// status_irq is filled by irq_ack (see there)
// ATTENTION: must be called with user_mutex locked!
// updates globals status.err_TX and err_RX with last errors
// no error = 0, warnings > 0, errors < 0
// calls reset_all if error < 0
// NOTE: this is the main and busiest function of DMA part of driver!
//       if you understand it and its functions you understand most of it.
//       see also device_write, device_read and device_ioctl in driver.c
#define ST_NONE		0
#define ST_RESTARTED	1
#define ST_FINISHED	2	
inline void irq_hdl_DMA(uint32_t status_irq[HELPER_TASK_NUM_STATUS]) {
	//uint32_t status_TX, status_RX;
	int err_TX = 0, err_RX = 0;
	//TIME_DATA t_IRQ;
  	int st_TX = ST_NONE, st_RX = ST_NONE; 
	// effective samples to be done: 0 = infinite, otherwise repetitions * samples
	uint32_t bytes = status.bt_tot * status.reps_set;

	rmb(); // ensure read cache is updated such that verify finds all completed dsc's

	// read latest status and combine with status at irq
	// this ensures that we do not loose completions which occur between reading irq status and acknowlede of irq
	// but it might cause that we get irq's where nothing needs to be done (get warnings, no error).
	status.status_TX = status_irq[HELPER_STATUS_TX] | READ_DMA_REGISTER(DMA_REG_MM2S_STATUS);
	status.status_RX = status_irq[HELPER_STATUS_RX] | READ_DMA_REGISTER(DMA_REG_S2MM_STATUS);
	status.irq_num = status_irq[HELPER_STATUS_NUM_IRQ];

	// check RX/TX completion and restart as fast as possible
	if(status.status_RX & S2MM_STATUS_IRQ_COMPLETE) {

		if (++status.debug_count >= DBG_HIST) status.debug_count = 0;
		status.debug[DBG_OFF_RX_IRQ     + status.debug_count] = status.status_RX;	
		status.debug[DBG_OFF_RX_VERIFY  + status.debug_count] ^= 0xffffffff;
		status.debug[DBG_OFF_RX_START   + status.debug_count] ^= 0xffffffff;
		status.debug[DBG_OFF_RX_PREPARE + status.debug_count] ^= 0xffffffff;

		//SET_TIME(t_IRQ, status_irq[HELPER_STATUS_SEC], status_irq[HELPER_STATUS_USEC]);

		// verify_RX checks completion and sets dsc_RX.next to next not completed dsc.
		// this stops RX if status.set_RX reached
		err_RX = verify_RX(false);
		if(err_RX >= 0) {
			if ((bytes > 0L) && (status.RX_bt_tot >= bytes)) st_RX = ST_FINISHED;
			else if (!(status.ctrl_DMA & DMA_CTRL_CYCLIC_RX)) {
				// if DMA enabled:
				// start [dsc_RX.tail->next..dsc_RX.last_prepared] if dsc_RX.last_prep != NULL
				// sets active descriptors [dsc_RX.head..tail] and dsc_RX.last_prep = NULL
				err_RX = start_RX_SG();
				if(err_RX >= 0) st_RX = ST_RESTARTED;
			}
		}
	} 
	if(status.status_TX & MM2S_STATUS_IRQ_COMPLETE) {
		//SET_TIME(t_IRQ, status_irq[HELPER_STATUS_SEC], status_irq[HELPER_STATUS_USEC]);

		// verify_TX checks completion and sets dsc_TX.next to next not completed dsc.
		// stops TX if status.set_TX reached
		err_TX = verify_TX(false);

		if(err_TX >= 0) {
			if ((bytes > 0L) && (status.TX_bt_tot >= bytes)) st_TX = ST_FINISHED;
			else {
				// if DMA enabled:
				// start [dsc_TX.tail->next..dsc_TX.last_prepared] if last_prep != NULL
				// sets active descriptors [dsc_TX.head..tail] and dsc_TX.last_prep = NULL
				err_TX = start_TX_SG();
				if(err_TX >= 0)	st_TX = ST_RESTARTED;
			}
			// start FPGA when TX wrote DIO_FPGA_START_BT bytes or all data
			if ((status.ctrl_DMA & DMA_CTRL_ENABLE_FPGA) && ((status.TX_bt_tot >= DIO_FPGA_START_BT) || (st_TX == ST_FINISHED))) {
				status.ctrl_DMA &= ~DMA_CTRL_ENABLE_FPGA;
                // TODO: this might return ERROR_FPGA for small number of samples. so we ignore it at the moment but I am not sure why is this the case?
                status.err_FPGA = start_FPGA(false);
			}
		}
	}

	wmb(); // ensure start_TX/RX_SG operations are written to device

	// prepare next dsc's RX and TX if DMA enabled,
	// or stop RX/TX channel when all samples transmitted (stop_TX/RX calls verify_TX/RX(true))
	if(st_RX == ST_RESTARTED) err_RX = prepare_RX_dsc();
	else if(st_RX == ST_FINISHED) err_RX = stop_RX((status.ctrl_DMA & DMA_CTRL_ACTIVE_TX) == 0);
	if(st_TX == ST_RESTARTED) err_TX = prepare_TX_dsc();
	else if(st_TX == ST_FINISHED) err_TX = stop_TX((status.ctrl_DMA & DMA_CTRL_ACTIVE_RX) == 0);

	// check error RX channel (S2MM)
	if(status.status_RX & S2MM_STATUS_IRQ_DELAY) {
		pr_err(NAME "IRQ delay! RX control 0x%X, status 0x%x\n", READ_DMA_REGISTER(DMA_REG_S2MM_CTRL), status.status_RX);
		status.err_RX = err_RX = -50;
	}
	if(status.status_RX & S2MM_STATUS_IRQ_ERR) {
		pr_err(NAME "IRQ error! RX control 0x%08x, status 0x%08x\n", READ_DMA_REGISTER(DMA_REG_S2MM_CTRL), status.status_RX);
		pr_err(NAME "           RX current 0x%08x, tail   0x%08x\n", 
			READ_DMA_REGISTER(DMA_REG_S2MM_CURR), READ_DMA_REGISTER(DMA_REG_S2MM_TAIL));
		pr_err(NAME "IRQ error bits SG/simple %c%c%c/%c%c%c\n", 
			status.status_RX & S2MM_STATUS_ERR_SG_INT ? 'I' : '_',
			status.status_RX & S2MM_STATUS_ERR_SG_SLV ? 'S' : '_',
			status.status_RX & S2MM_STATUS_ERR_SG_DEC ? 'D' : '_',
			status.status_RX & S2MM_STATUS_ERR_INT    ? 'i' : '_',
			status.status_RX & S2MM_STATUS_ERR_SLV    ? 's' : '_',
			status.status_RX & S2MM_STATUS_ERR_DEC    ? 'd' : '_');
		status.err_RX = err_RX = -60;
	}

	// check error TX channel (MM2S)
	if(status.status_TX & MM2S_STATUS_IRQ_DELAY) {
		pr_err(NAME "IRQ delay! TX control 0x%X, status 0x%x\n", READ_DMA_REGISTER(DMA_REG_MM2S_CTRL), status.status_TX);
		status.err_TX = err_TX = -20;
	}
	if(status.status_TX & MM2S_STATUS_IRQ_ERR) {
		pr_err(NAME "IRQ error! TX control 0x%08x, status 0x%08x\n", READ_DMA_REGISTER(DMA_REG_MM2S_CTRL), status.status_TX);
		pr_err(NAME "           TX current 0x%08x, tail   0x%08x\n", 
			READ_DMA_REGISTER(DMA_REG_MM2S_CURR), READ_DMA_REGISTER(DMA_REG_MM2S_TAIL));
		pr_err(NAME "IRQ error bits SG/simple %c%c%c/%c%c%c\n", 
			status.status_TX & MM2S_STATUS_ERR_SG_INT ? 'I' : '_',
			status.status_TX & MM2S_STATUS_ERR_SG_SLV ? 'S' : '_',
			status.status_TX & MM2S_STATUS_ERR_SG_DEC ? 'D' : '_',
			status.status_TX & MM2S_STATUS_ERR_INT    ? 'i' : '_',
			status.status_TX & MM2S_STATUS_ERR_SLV    ? 's' : '_',
			status.status_TX & MM2S_STATUS_ERR_DEC    ? 'd' : '_');
		status.err_TX = err_TX = -30;
	}

	// reset DMA if an error occurred [removed since makes it difficult to debug]
	if((err_TX < 0) || (err_RX < 0)) {
		pr_err(NAME "irq_hdl: error TX = %d, RX = %d!\n", err_TX, err_RX);
		//reset_all();
	}
}

// set FPGA clock to external (true) or internal (false)
// returns 0 if ok, otherwise error
int set_ext_clk_FPGA(bool external) {
	int err = 0;
	uint32_t loops;
    //pr_err(NAME "set external clock = %d\n", (int)external);
	if(external && (!(status.status_FPGA.status & DIO_STATUS_EXT_USED))) { // switch to external clock
        // wait until clock is re-locked. max. TIMEOUT_SHORT (10ms)
        for(loops = LOOPS_SHORT; (loops > 0) && (!CLOCK_IS_LOCKED()); loops--) udelay(SLEEP_TIME_LONG);
        if (CLOCK_IS_LOCKED()) {
			// external clock is locked: try to switch to external clock
			CLOCK_SET_EXTERNAL(status.ctrl_FPGA);
			// wait until FPGA has switched to external clock
			for(loops = LOOPS_LONG; (loops > 0) && (!CLOCK_IS_EXTERNAL(status.status_FPGA.status)); loops--) udelay(SLEEP_TIME_LONG);
			if(loops == 0) {
				err = -ERROR_TIMEOUT;
				pr_err(NAME "switching to external clock failed! ctrl/status %x/%x\n", READ_DIO_REGISTER(DIO_REG_CTRL), READ_DIO_REGISTER(DIO_REG_STATUS));
			}
			else {
				status.ctrl_FPGA |= DIO_CTRL_EXT_CLK;
                if (status.ctrl_FPGA & DIO_CTRL_ERR_LOCK_EN) 
                    pr_err(NAME "ext.clock. ctrl/status %x/%x\n", READ_DIO_REGISTER(DIO_REG_CTRL), READ_DIO_REGISTER(DIO_REG_STATUS));
                else
                    pr_err(NAME "ext.clock. ctrl/status %x/%x (ignore loss!)\n", READ_DIO_REGISTER(DIO_REG_CTRL), READ_DIO_REGISTER(DIO_REG_STATUS));
			}
		}
		else {
			pr_err(NAME "external clock is not locked! ctrl/status %x/%x\n", READ_DIO_REGISTER(DIO_REG_CTRL), READ_DIO_REGISTER(DIO_REG_STATUS));
			err = -1;
		}
	}
	else if ((!external) && (status.status_FPGA.status & DIO_STATUS_EXT_USED)) { // switch to internal clock
		CLOCK_SET_INTERNAL(status.ctrl_FPGA);
		// wait until FPGA has switched to internal clock
		for(loops = LOOPS_LONG; (loops > 0) && CLOCK_IS_EXTERNAL(status.status_FPGA.status); loops--) udelay(SLEEP_TIME_LONG);
		if(loops == 0) {
			err = -ERROR_TIMEOUT;
			pr_err(NAME "switching to internal clock failed! ctrl/status %x/%x\n", READ_DIO_REGISTER(DIO_REG_CTRL), READ_DIO_REGISTER(DIO_REG_STATUS));
		}
		else {
			status.ctrl_FPGA &= ~DIO_CTRL_EXT_CLK;
			pr_err(NAME "int.clock. ctrl/status %x/%x\n", READ_DIO_REGISTER(DIO_REG_CTRL), READ_DIO_REGISTER(DIO_REG_STATUS));
		}
	}
	if (err) status.err_FPGA = err;
	return err;
}

// start FPGA
// if wait = true will wait until RUN bit is set, otherwise not.
// returns 0 if RUN bit is set, otherwise error (-ERROR_TIMEOUT if RUN bits was not set during TIMEOUT_LONG period)
// note: set all user settable control bits before calling start_FPGA!
int start_FPGA(bool wait) {
	int err = 0;
	uint32_t loops = LOOPS_LONG;
	// get actual status
	status.status_FPGA.status = READ_DIO_REGISTER(DIO_REG_STATUS);
	// check status
	if( (status.ctrl_FPGA & DIO_CTRL_RUN) != 0) err = WARN_ALREADY_DONE;
	else if ( READ_DIO_REGISTER(DIO_REG_NUM_SAMPLES) != status.set_samples ) err = -ERROR_ILLEGAL_STATE; // must have been set by IOCTL_START
	else if ( ((status.ctrl_FPGA & DIO_CTRL_EXT_CLK)?1:0) != (CLOCK_IS_EXTERNAL(status.status_FPGA.status)?1:0) ) err = -ERROR_ILLEGAL_STATE; // wrong clock selected
	else {
		// reset irq counter
		//irq_cnt = 0;
		// set multiplicator, strobe delay and external clock to defaults
//		WRITE_DIO_REGISTER(DIO_REG_BOARD_TIME_MULT, DIO_TIME_MULT);
//		WRITE_DIO_REGISTER(DIO_REG_STRB_DELAY, (DIO_STRB_DELAY << DIO_STRB_DELAY_START) | (DIO_STRB_WIDTH << DIO_STRB_WIDTH_START));
//		WRITE_DIO_REGISTER(DIO_REG_EXT_CLOCK, DIO_EXT_CLOCK_DEFAULT);

		// set FPGA running bit
		WRITE_DIO_REGISTER(DIO_REG_CTRL, status.ctrl_FPGA | DIO_CTRL_RUN);

	    // memory barrier to be sure data is written
	    wmb();

        if (wait) {
		    // wait until FPGA is running (fails when FPGA is in error mode!)
		    // if no data is available goes into idle state [so far not used], otherwise into running state
		    status.status_FPGA.status = READ_DIO_REGISTER(DIO_REG_STATUS);
		    for(; (loops > 0) && (((status.status_FPGA.status = READ_DIO_REGISTER(DIO_REG_STATUS)) & (DIO_STATUS_RUN|DIO_STATUS_READY)) != (DIO_STATUS_RUN|DIO_STATUS_READY)); --loops) {
			    udelay(SLEEP_TIME_LONG);
		    }
		    if(loops == 0) {
			    err = -ERROR_TIMEOUT;
			    pr_err(NAME "start_FPGA failed (%d loops)! ctrl/status %x/%x\n", LOOPS_LONG - loops, READ_DIO_REGISTER(DIO_REG_CTRL), READ_DIO_REGISTER(DIO_REG_STATUS));
		    }
		    else {
			    status.ctrl_FPGA |= DIO_CTRL_RUN;
			    //pr_err(NAME "start_FPGA ok (%d loops)! ctrl/st/DMA %x/%x/%x\n", 
                //    (TIMEOUT_LONG/SLEEP_TIME_LONG)-loops, READ_DIO_REGISTER(DIO_REG_CTRL), READ_DIO_REGISTER(DIO_REG_STATUS),status.ctrl_DMA);
		    }
        }
        else { // do not wait but read one time status
            status.ctrl_FPGA |= DIO_CTRL_RUN;
            status.status_FPGA.status = READ_DIO_REGISTER(DIO_REG_STATUS);
            if(!(status.status_FPGA.status & DIO_STATUS_RUN)) err = -ERROR_FPGA;
        }
	}

	status.err_FPGA = err;
	//pr_err(NAME "start_FPGA ctrl/status %x/%x result %d\n", READ_DIO_REGISTER(DIO_REG_CTRL), READ_DIO_REGISTER(DIO_REG_STATUS), err);

	return err;
}

// stop FPGA
int stop_FPGA(void) {
	int err = 0;
	uint32_t loops = LOOPS_LONG;

	if((status.ctrl_FPGA & DIO_CTRL_RUN) == 0) err = WARN_ALREADY_DONE;
	else {
		// reset FPGA running bit but keep other settings
		WRITE_DIO_REGISTER(DIO_REG_CTRL, READ_DIO_REGISTER(DIO_REG_CTRL) & ~DIO_CTRL_RUN);

		// memory barrier to be sure data is written
		wmb();
		
		// wait until FPGA is stopped (should not fail)
		for(; (loops > 0) && (((status.status_FPGA.status = READ_DIO_REGISTER(DIO_REG_STATUS)) & DIO_STATUS_RUN) != 0); --loops) udelay(SLEEP_TIME_LONG);
		if(loops == 0) {
			err = -ERROR_TIMEOUT;
			pr_err(NAME "stop_FPGA failed (%d loops)! ctrl/status %x/%x\n", LOOPS_LONG - loops, READ_DIO_REGISTER(DIO_REG_CTRL), READ_DIO_REGISTER(DIO_REG_STATUS));
		}
		else {
			status.ctrl_FPGA &= ~DIO_CTRL_RUN;
			pr_err(NAME "stop_FPGA ok (%d loops)! ctrl/status %x/%x\n", LOOPS_LONG - loops, READ_DIO_REGISTER(DIO_REG_CTRL), READ_DIO_REGISTER(DIO_REG_STATUS));
		}
	}

	status.err_FPGA = err;

	return err;
}

// reset FPGA
int reset_FPGA(void) {
	int err = 0;
	uint32_t loops[2] = {LOOPS_LONG,LOOPS_RESET};

	// use internal clock
	// force by setting status.ctrl_FPGA to external clock
	//status.ctrl_FPGA |= DIO_CTRL_EXT_CLK;
	//set_ext_clk_FPGA(false);

	// set DATA_NUM to 0
    // TODO: is this needed?
	WRITE_DIO_REGISTER(DIO_REG_NUM_SAMPLES, 0);
	// set multiplicator, strobe delay and external clock to defaults
	//WRITE_DIO_REGISTER(DIO_REG_BOARD_TIME_MULT, DIO_TIME_MULT);
	//WRITE_DIO_REGISTER(DIO_REG_STRB_DELAY, (DIO_STRB_DELAY << DIO_STRB_DELAY_START) | (DIO_STRB_WIDTH << DIO_STRB_WIDTH_START));
	//WRITE_DIO_REGISTER(DIO_REG_EXT_CLOCK, DIO_EXT_CLOCK_DEFAULT);

	// reset all FPGA control bits and set FPGA reset and (server ready) bit
	// note: reset bit is cleared automatically!
	WRITE_DIO_REGISTER(DIO_REG_CTRL, DIO_CTRL_RESET|DIO_CTRL_READY);

	// memory barrier to be sure data is written
	wmb();

	// wait for reset bit set in status register. we might miss this bit but 100ms timeout is not too long. maybe reduce timeout, but seems not to happen (often).
	for(; (loops[0] > 0) && ((DIO_STATUS_RESET & (status.status_FPGA.status = READ_DIO_REGISTER(DIO_REG_STATUS))) != DIO_STATUS_RESET); --loops[0]) udelay(SLEEP_TIME_LONG); 

	// wait until FPGA is reset. this should never fail. timeout is 1s.
	for(; (loops[1] > 0) && (((status.status_FPGA.status = READ_DIO_REGISTER(DIO_REG_STATUS)) & DIO_STATUS_RESET_MASK) != DIO_STATUS_RESET_EXP); --loops[1]) udelay(SLEEP_TIME_LONG);
	if((loops[0] == 0) || (loops[1] == 0)) { // timeout
		pr_err(NAME "reset_FPGA: reset timeout! (%u/%u loops) ctrl/sts = %x/%x (error)\n", LOOPS_LONG - loops[0], LOOPS_RESET - loops[1], READ_DIO_REGISTER(DIO_REG_CTRL), status.status_FPGA.status);
		if (loops[1] == 0) err = -ERROR_TIMEOUT; // only second timeout is serious
	}
	else {
		pr_err(NAME "reset_FPGA: (%u/%u loops) ctrl/sts = %x/%x (ok)\n", LOOPS_LONG - loops[0], LOOPS_RESET - loops[1], READ_DIO_REGISTER(DIO_REG_CTRL), status.status_FPGA.status);
		status.ctrl_FPGA = DIO_CTRL_NONE;
	}

	status.err_FPGA = err;

	return err;
}

// reset TX channel.
// returns 0 if ok, >0 if warning, <0 error
// ATTENTION: this resets also RX channel!
// call verify_TX and release_TX if you want to use data
int reset_TX(void) {
	int err = 0;
	uint32_t loops = LOOPS_LONG;

	//print_status(NAME "reset_TX");
	pr_err(NAME "reset TX (and RX) channel ...\n");

	// reset TX channel
	SET_REGISTER_BIT(DMA_REG_MM2S_CTRL, MM2S_CTRL_RESET);

	// memory barrier to be sure data is written
	wmb();

	// wait until DMA is reset
	for(; (loops > 0) && (!TX_IS_RESET(READ_DMA_REGISTER(DMA_REG_MM2S_CTRL),READ_DMA_REGISTER(DMA_REG_MM2S_STATUS))); --loops) udelay(SLEEP_TIME_LONG);
	if(loops == 0) {
		pr_err(NAME "reset_TX: timeout! (error)\n");
		err = -ERROR_TIMEOUT;
	}
	else {
		//pr_err(NAME "reset_TX: succeeded! (ok)\n");
		// reset status
		status.ctrl_DMA &= ~(DMA_CTRL_ENABLE_TX | DMA_CTRL_ACTIVE_TX);
		
		// reset packet buffer count (next starts with start bit)
		p_count = 0;
	}

	//print_status(NULL);
	status.err_TX = err;

	return err;
}

// reset RX channel
// returns 0 if ok, >0 if warning, <0 error
// ATTENTION: this resets also TX channel!
// call verify_RX and release_RX if you want to use data
int reset_RX(void) {
	int err = 0;
	uint32_t loops = LOOPS_LONG;

	//print_status(NAME "reset_RX");
	pr_err(NAME "reset RX (and TX) channel ...\n");

	// reset RX channel
	SET_REGISTER_BIT(DMA_REG_S2MM_CTRL, S2MM_CTRL_RESET);

	// memory barrier to be sure data is written
	wmb();

	for(; (loops > 0) && (!RX_IS_RESET(READ_DMA_REGISTER(DMA_REG_S2MM_CTRL),READ_DMA_REGISTER(DMA_REG_S2MM_STATUS))); --loops) udelay(SLEEP_TIME_LONG);
	if(loops == 0) {
		pr_err(NAME "reset_RX: timeout! (error)\n");
		err = -ERROR_TIMEOUT;
	}
	else {
		//pr_err(NAME "reset_RX: succeeded! (ok)\n");
		// reset status
		status.ctrl_DMA &= ~(DMA_CTRL_ENABLE_RX | DMA_CTRL_ACTIVE_RX);
	}

	//print_status(NULL);
	status.err_RX = err;

	return err;
}

void check_TX(void) {
	struct dsc_info *dsc = dsc_TX.tail;
	uint32_t curr = READ_DMA_REGISTER(DMA_REG_MM2S_CURR);
	uint32_t tail = READ_DMA_REGISTER(DMA_REG_MM2S_TAIL);
	int i = 0;
	pr_err(NAME "stop_TX: tail 0x%08x != curr 0x%08x, status 0x%x\n", tail, curr, READ_DMA_REGISTER(DMA_REG_MM2S_STATUS));
	pr_err(NAME "dsc:     virt     phys   m_virt\n");
	pr_err(NAME "%3d: %p %08x %p\n", i, dsc, tail, dsc->buffer);
	while(dsc && (tail != curr)) {
		++i;
		dsc = dsc->next;
		if(dsc == NULL) break;
		tail = GET_ALIGNED_PHYS_DSC(dsc->phys_addr);
		pr_err(NAME "%3d: %p %08x %p\n", i, dsc, tail, dsc->buffer);
	}
}

// stops all pending TX DMA transactions
// this might fail when DMA is not idle! resetting DMA is working however, but resets both channels!
// if reset_on_error == true waits maximum TIMEOUT_LONG until idle state, otherwise calls reset_TX!
// returns 0 if ok, >0 if warning, <0 error
// calls verify_TX if DMA_CTRL_ACTIVE_TX and release_TX if DMA_CTRL_STOP_TX_AT_END
// TODO: reset_on_error caused that verify_TX gives error if finds completed dscs (same for RX).
int stop_TX(bool reset_on_error) {
	int err = 0;
	uint32_t loops;

	if((status.ctrl_DMA & DMA_CTRL_ENABLE_TX) == 0) err = WARN_ALREADY_DONE;
	else {
		if ((READ_DMA_REGISTER(DMA_REG_MM2S_STATUS) & MM2S_STATUS_IDLE) == 0) {
			//pr_err(NAME "stop_TX not idle ...\n");
			if(reset_on_error) {
				// wait until idle, otherwise reset
				loops = LOOPS_LONG;
				for (; (loops > 0) && ((READ_DMA_REGISTER(DMA_REG_MM2S_STATUS) & MM2S_STATUS_IDLE) == 0); --loops) udelay(SLEEP_TIME_LONG);
				if (loops == 0) { // timeout
					pr_err(NAME "stop_TX not idle: reset TX (and RX)!\n");
					err = reset_TX();
					if(!err) err = WARN_TIMEOUT;
					status.ctrl_DMA |= DMA_CTRL_ENABLE_TX; // otherwise verify_TX error -24 when finds completed dscs
				}
			}
			else {
				pr_err(NAME "stop_TX not idle (might fail)\n");
				err = WARN_NOT_IDLE;
			}
		}

		// reset run bit and wait for the halted bit to go high
		RESET_REGISTER_BIT(DMA_REG_MM2S_CTRL, MM2S_CTRL_RUN);
		loops = LOOPS_LONG;
		for (; (loops > 0) && ((READ_DMA_REGISTER(DMA_REG_MM2S_STATUS) & MM2S_STATUS_HALTED) == 0); --loops) udelay(SLEEP_TIME_LONG);
		if (loops == 0) { // timeout
			if (err) pr_err(NAME "stop_TX: timeout/not idle! (error)\n");
			else pr_err(NAME "stop_TX: timeout! (error)\n");
			err = -ERROR_TIMEOUT;
		}

		if(err >= 0) {
			// disable TX
			status.ctrl_DMA &= ~DMA_CTRL_ENABLE_TX;

			// check if there were completed dsc's and release all of them
			err = verify_TX(true);
            if (err < 0) pr_err("%s *** stop_TX: verify_TX error %d! ***\n\n", NAME, err);
			if(status.ctrl_DMA & DMA_CTRL_ACTIVE_TX) err = -2; // verify_TX(true) must clear this bit!
		}
	}
	if (err) status.err_TX = err;

	return err;
}

// stop all pending RX DMA transactions
// this might fail when DMA is not idle! resetting DMA is working however, but resets both channels!
// if reset_on_error == true waits maximum TIMEOUT_LONG until idle state, otherwise calls reset_RX!
// returns 0 if ok, >0 if warning, <0 error
// TODO: reset_on_error caused that verify_RX gives error if finds completed dscs.
int stop_RX(bool reset_on_error) {
	int err = 0;
	uint32_t loops;

	if((status.ctrl_DMA & DMA_CTRL_ENABLE_RX) == 0) err = WARN_ALREADY_DONE;
	else {
        /* update 2025/03/11: RX channel is never idle, so we reset it immediately, otherwise stop time is very long.
		if ((READ_DMA_REGISTER(DMA_REG_S2MM_STATUS) & S2MM_STATUS_IDLE) == 0) {
			//pr_err(NAME "stop_RX not idle ...\n");
			if(reset_on_error) {
				// wait until idle, otherwise reset
				loops = LOOPS_LONG;
				for (; (loops > 0) && ((READ_DMA_REGISTER(DMA_REG_S2MM_STATUS) & S2MM_STATUS_IDLE) == 0); --loops) udelay(SLEEP_TIME_LONG);
				if(loops == 0) { // timeout
					pr_err(NAME "stop_RX not idle: reset RX (and TX)!\n");
					err = reset_RX();
					if(!err) err = WARN_TIMEOUT;
					status.ctrl_DMA |= DMA_CTRL_ENABLE_RX; // otherwise verify_RX error when finds completed dscs
				}
			}
			else {
				pr_err(NAME "stop_RX not idle (might fail)\n");
				err = WARN_NOT_IDLE;
			}
		}*/
		
		if ((READ_DMA_REGISTER(DMA_REG_S2MM_STATUS) & S2MM_STATUS_IDLE) == 0) {
		    pr_err(NAME "stop_RX not idle: reset RX (and TX)!\n");
		    err = reset_RX();
		    if(!err) err = WARN_TIMEOUT;
		    status.ctrl_DMA |= DMA_CTRL_ENABLE_RX; // otherwise verify_RX error when finds completed dscs
		}
		// update 2025/03/11: end


		// reset run bit and wait for the halted bit to go high
		RESET_REGISTER_BIT(DMA_REG_S2MM_CTRL, S2MM_CTRL_RUN);
		loops = LOOPS_LONG;
		for (; (loops > 0) && ((READ_DMA_REGISTER(DMA_REG_S2MM_STATUS) & S2MM_STATUS_HALTED) == 0); --loops) udelay(SLEEP_TIME_LONG);
		if(loops == 0) { // timeout
			if(err) pr_err(NAME "stop_RX: timeout/not idle! (error)\n");
			else pr_err(NAME "stop_RX: timeout! (error)\n");
			err = -ERROR_TIMEOUT;
		}

		if(err >= 0) {
			// disable RX
			status.ctrl_DMA &= ~DMA_CTRL_ENABLE_RX;

			// check if there were completed dsc's and release all of them
			err = verify_RX(true);
            if (err < 0) pr_err("\n%s *** stop_RX: verify_RX error %d! ***\n\n", NAME, err);
			if(status.ctrl_DMA & DMA_CTRL_ACTIVE_RX) err = -2; // verify_RX must clear this bit!
		}
	}
	if (err) status.err_RX = err;

	return err;
}

// start TX in scatter/getter DMA mode
// returns 0 if ok, >0 if warning, <0 error
// ATTENTION: must be called with user_mutex locked!
// notes: 
// - starts descriptors [dsc_TX.head..last_prep] (inclusive).
// - after return dsc_TX.tail = dsc_TX.last_prep and dsc_TX.last_prep = NULL.
// - sets DMA_CTRL_ACTIVE_TX bit in status.ctrl_DMA
// - call verify_TX before to update dsc_TX.head to first not-completed dsc.
// - if dsc_TX.last_prep == NULL no descriptors are ready and returns without error
// - if status.ctrl_DMA & DMA_CTRL_ACTIVE_TX == 0 then no descriptors are running
int start_TX_SG(void) {
	int err = 0;
	uint32_t loops, control, tmp;
	struct SG_dsc *dsc;

	// check if TX DMA is enabled
	if((status.ctrl_DMA & DMA_CTRL_ENABLE_TX) == 0) {
		// reset descriptors (tail = last = NULL)
		//status.ctrl_DMA &= ~DMA_CTRL_ACTIVE_TX;
		//dsc_TX.tail = dsc_TX.last_prep = NULL;
		err = WARN_NOT_ENABLED;
	}
	else {
		//pr_err(NAME "start_TX_SG [%p,%p,%p]\n", dsc_TX.head, dsc_TX.tail, dsc_TX.last_prep);
		//pr_err(NAME "start_TX_SG\n");
		// check if descriptors are ready
		if(dsc_TX.last_prep == NULL) { 
			// no descriptors ready: set dma status to incactive
			//pr_err(NAME "start_TX_SG: no prepared descriptors (ok)\n");
			//status.ctrl_DMA &= ~DMA_CTRL_ACTIVE_TX;
			err = WARN_NO_DATA;
		}
		else {
			// set last_prep->next to NULL. this avoids DMA going byound tail.
			//dsc = GET_ALIGNED_DSC(dsc_TX.last_prep->virt_addr);
			//dsc->next_low = 0;

			// check validity of descriptors
			if(dsc_TX.head == NULL) err = -1;
			else {
				//err = check_sg_dsc(dsc_TX.head, dsc_TX.last_prep, true);
				//if(!err) {
				{
					// read TX control and status registers
					control = READ_DMA_REGISTER(DMA_REG_MM2S_CTRL);
					tmp = READ_DMA_REGISTER(DMA_REG_MM2S_STATUS);

					// check scatter/getter bit
					if(!TX_IS_SG(tmp)) err = -1;
					// check cyclic bit
					else if(TX_IS_CYCLIC(control)) err = -2;
					// check error bits, IRQs and reserved bits
					else if(!TX_IS_OK(control, tmp)) { // restart from error
						err = -3;
						/*WRITE_DMA_REGISTER(DMA_REG_MM2S_CTRL, );
						// wait until halted bit is reset
						loops = LOOPS_LONG;
						for(; (loops > 0) && (READ_DMA_REGISTER(DMA_REG_MM2S_STATUS) & MM2S_STATUS_HALTED); --loops) udelay(SLEEP_TIME_LONG);

						// clear irq by writing to it
						WRITE_DMA_REGISTER(DMA_REG_MM2S_STATUS, tmp & TX_IRQ_SETTINGS);

						// set current dsc which is NULL
						tmp = GET_ALIGNED_PHYS_DSC(dsc_TX.tail->next->phys_addr);
						WRITE_DMA_REGISTER(DMA_REG_MM2S_CURR,tmp);
						WRITE_DMA_REGISTER(DMA_REG_MM2S_CURR_MSB,0);

						// set run bit, enable interrupts on completion and error, disable interrupt on delay
						WRITE_DMA_REGISTER(DMA_REG_MM2S_CTRL, (control & (~MM2S_CTRL_IRQ_MASK)) | MM2S_CTRL_RUN | TX_IRQ_SETTINGS);

						// memory barrier to be sure data is written
						wmb();

						// wait until halted bit is reset
						loops = LOOPS_LONG;
						for(; (loops > 0) && (READ_DMA_REGISTER(DMA_REG_MM2S_STATUS) & MM2S_STATUS_HALTED); --loops) udelay(SLEEP_TIME_LONG);
						if(loops == 0) err = -31;
						dsc = GET_ALIGNED_DSC(dsc_TX.tail->virt_addr); // this is virt_addr
						*/
					}
					// check if is already running
					else if(TX_IS_RUNNING(control, tmp)) {
						// already running:
						// DMA status must be active
						// IRQs must be enabled and tail descriptor must be dsc_TX->tail
						// TODO:
						// - idle bit might be set if there are no more descriptors.
						// - current might be not be equal tail descriptor but can be ahead!? but then does not restart!?
						// - to avoid this I set tail dsc->next = NULL [causes IRQ_ERR with ERR_SG_SLV, curr = NULL, cannot restart]
						if(TX_IS_IDLE(tmp)) {
							tmp = READ_DMA_REGISTER(DMA_REG_MM2S_TAIL); 
							if ((tmp != READ_DMA_REGISTER(DMA_REG_MM2S_CURR)))
								pr_err(NAME "start_TX_SG: IDLE! curr 0x%08x != tail 0x%08x\n", READ_DMA_REGISTER(DMA_REG_MM2S_CURR), tmp);
							//else pr_err(NAME "start_TX_SG: IDLE! curr == tail 0x%08x \n", tmp);
						}
						else tmp = READ_DMA_REGISTER(DMA_REG_MM2S_TAIL); // this is phys_addr
						dsc = GET_ALIGNED_DSC(dsc_TX.tail->virt_addr); // this is virt_addr
						//if((status.ctrl_DMA & DMA_CTRL_ACTIVE_TX) == 0) err = -12;
						if((control & MM2S_CTRL_IRQ_MASK) != TX_IRQ_SETTINGS) err = -13;
						else if (dsc_TX.tail == NULL) err = -14; // here tail cannot be NULL!
						else if (tmp != GET_ALIGNED_PHYS_DSC(dsc_TX.tail->phys_addr)) err = -15;
						else if (dsc == NULL) err = -16;
						//else if (dsc->next_low != 0) err = -17; // must be 0
						else if (dsc_TX.tail->next == NULL) err = -18; // must be first prepared dsc
						else {
							// set valid first prepared dsc. this allows DMA to go byound tail.
							// not done here but right before writing of tail dsc!
							//tmp = GET_ALIGNED_PHYS_DSC(dsc_TX.tail->next->phys_addr);
							//pr_err(NAME "start_TX_SG: re-start\n");
						}
					}
					else if(status.ctrl_DMA & DMA_CTRL_ACTIVE_TX) err = -21; // must be inactive
					else if(dsc_TX.tail != NULL) err = -22; // must be NULL
					else {	// not running:
						//pr_err(NAME "start_TX_SG: starting ...\n");
						// write current descriptor register with starting descriptor
						WRITE_DMA_REGISTER(DMA_REG_MM2S_CURR,GET_ALIGNED_PHYS_DSC(dsc_TX.head->phys_addr));
						WRITE_DMA_REGISTER(DMA_REG_MM2S_CURR_MSB,0);

						// set run bit, enable interrupts on completion and error, disable interrupt on delay
						WRITE_DMA_REGISTER(DMA_REG_MM2S_CTRL, (control & (~MM2S_CTRL_IRQ_MASK)) | MM2S_CTRL_RUN | TX_IRQ_SETTINGS);

						// memory barrier to be sure data is written
						wmb();

						// wait until halted bit is reset
						loops = LOOPS_LONG;
						for(; (loops > 0) && (READ_DMA_REGISTER(DMA_REG_MM2S_STATUS) & MM2S_STATUS_HALTED); --loops) udelay(SLEEP_TIME_LONG);
						if(loops == 0) err = -31;
						dsc = NULL;
					}
					
					// running or not: writing tail descriptor will (re-)start DMA
					if(!err) {

						// all descriptors up to last will be sent after next 2 instructions
						// update descriptors and reset last_prep=NULL
						// head was updated by verify_TX
						dsc_TX.tail = dsc_TX.last_prep;
						dsc_TX.last_prep = NULL;

						// update status
						status.ctrl_DMA |= DMA_CTRL_ACTIVE_TX;

						/*if(dsc) {
							// set valid first prepared dsc. this allows DMA to go byound tail.
							// TODO: if between here and writing tail dsc the DMA arrives at tail
							//       it might go byound and restarting does not work!
							//       I do not know how to fix this, but probability is very low.
							//       - one solution for not too many data is to use cycling mode.
							dsc->next_low = tmp;
						}*/

						// write tail descriptor
						// this causes DMA transfer to start
						WRITE_DMA_REGISTER(DMA_REG_MM2S_TAIL,GET_ALIGNED_PHYS_DSC(dsc_TX.tail->phys_addr));
						WRITE_DMA_REGISTER(DMA_REG_MM2S_TAIL_MSB,0);

						// true time starts somewhere between WRITE_DMA_REGISTER above and end of barrier below
						//GET_TIME(t_TX_start);

						// memory barrier to be sure data is written
						wmb();				

						//do not output anything here, otherwise disturbs time measurement
					}
				}
			}
		}
	}

	if (err) status.err_TX = err;

	if(err < 0) pr_err(NAME "start_TX_SG error %d ctrl/status = 0x %x/%x\n", err, READ_DMA_REGISTER(DMA_REG_MM2S_CTRL), READ_DMA_REGISTER(DMA_REG_MM2S_STATUS));
	else if(err==0) {
		status.dsc_TX_a += status.dsc_TX_p;
		status.dsc_TX_p = 0;
		//pr_err(NAME "start_TX_SG %p - %p active %u (ok)\n", dsc_TX.head->buffer, dsc_TX.tail->buffer, status.dsc_TX_a);
	}

	return err;
}
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
