INO-quantum/FPGA-SoC-experiment-control/(commit log)

2021-05-05 upload first files
    [6Li-53Cr_5898.csv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]
2021-05-18 upload firmware
    [6Li-53Cr_5898.csv, LENS_5890.csv, user_2018-04-30-10-48-00.cfg, user_2018-04-30-12-59-00.cfg, user_2020-07-21-23-30-00.cfg, user_2020-07-22-08-48-00.cfg, user_2020-07-22-10-10-00.cfg, user_2020-09-14-01-01-00.cfg]
2021-05-20 update bsp
    [6Li-53Cr_5898.csv, LENS_5890.csv, user_2018-04-30-10-48-00.cfg, user_2018-04-30-12-59-00.cfg, user_2020-07-21-23-30-00.cfg, user_2020-07-22-08-48-00.cfg, user_2020-07-22-10-10-00.cfg, user_2020-09-14-01-01-00.cfg]
2021-05-21 add short description of schematics
2021-05-21 update auto-sync, buffer card and data
    [FPGA_buffer_board-B_Cu.gbl, FPGA_buffer_board-B_Mask.gbs, FPGA_buffer_board-B_Paste.gbp, FPGA_buffer_board-B_SilkS.gbo, FPGA_buffer_board-Edge_Cuts.gm1, FPGA_buffer_board-F_Cu.gtl, FPGA_buffer_board-F_Mask.gts, FPGA_buffer_board-F_Paste.gtp]
2021-06-01 insert figure
2021-06-03 update labscript device
2021-06-05 in figure 5b show fitted numbers at 4 and 10^7 samples
2021-06-08 correct error in FPGA_device.py and do not use hardware_setup since makes problems
    [FPGA_device.py]
2023-04-04 reverting changed done by mistake
    [FPGA_device.py, register_classes.py]
2024-01-16 add buffer card v1.4
    [FPGA_buffer_board-B_Cu.gbl, FPGA_buffer_board-B_Mask.gbs, FPGA_buffer_board-B_Paste.gbp, FPGA_buffer_board-B_SilkS.gbo, FPGA_buffer_board-Edge_Cuts.gm1, FPGA_buffer_board-F_Cu.gtl, FPGA_buffer_board-F_Mask.gts, FPGA_buffer_board-F_Paste.gtp]
2024-01-19 rename folder and update firmware-source
    [6Li-53Cr_5898.csv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]
2024-05-06 add worker_arg to simulate device, use clockline for each address, add table_mode option
2024-06-13 add option to avoid generation of strobe bit
    [FPGA_device.py]
2024-06-24 fix bit masks for 8 address bits and update runviewer parser
    [FPGA_device.py]
2024-07-08 update old code in buffer board shopping list v1.4
    [FPGA_buffer_board_v1.4_shopping_list.ods, FPGA_buffer_board_v1.4_shopping_list.xls]
2024-07-29 invert LEDs
2024-12-23 readme forlabscript-suite driver development version
2025-03-12 patch driver to reduce delay between runs
2025-03-12 ignore error 99 in server when DHCP is enabled
    [fpga-server.cpp]
2025-03-12 create new bsp with patched driver
2025-03-12 update release with patched version of driver for shorter delay between cycles
    [FPGA_buffer_board_v1.4_FPGA_board_only_with_accessoires.xls, FPGA_buffer_board_v1.4_shopping_list.ods, FPGA_buffer_board_v1.4_shopping_list.xls]
2025-03-12 add list with FPGA board and accessoires
    [FPGA_buffer_board_v1.4_FPGA_board_only_with_accessoires.xls]
2025-07-17 updated buffer board version v1.3.2 with DFN footprint
    [FPGA_buffer_board-B_Cu.gbl, FPGA_buffer_board-B_Mask.gbs, FPGA_buffer_board-B_Paste.gbp, FPGA_buffer_board-B_SilkS.gbo, FPGA_buffer_board-Edge_Cuts.gm1, FPGA_buffer_board-F_Cu.gtl, FPGA_buffer_board-F_Mask.gts, FPGA_buffer_board-F_Paste.gtp]
